kotori0919/PLA-PET-Recycling-Lab/graphify-out/GRAPH_REPORT.md

# Graph Report - PPR  (2026-10-19)

## Corpus Check
- 1292 files · ~3,835,179 words
- Verdict: corpus is large enough that graph structure adds value.
- Unclassified: 2214 file(s) not represented in the graph (top: .step 486, .dxf 275, .csv 217)

## Summary
- 9168 nodes · 17152 edges · 686 communities (466 shown, 220 thin omitted)
- Extraction: 96% EXTRACTED · 4% INFERRED · 0% AMBIGUOUS · INFERRED: 723 edges (avg confidence: 0.84)
- Token cost: 0 input · 0 output

## Graph Freshness
- Built from commit: `34ae29d7`
- Run `git rev-parse HEAD` and compare to check if the graph is stale.
- Run `graphify update .` after code changes (no API cost).

## Community Hubs (Navigation)
- source_sha256
- MachineSupervisor
- MachineSupervisor
- MachineSupervisor
- cad/freecad/compact/geometry.py
- 05_SOURCE/analysis/final_validation/run_calculix_v08.py
- cad/freecad/compact/manufacturing.py
- cad/freecad/compact/generate.py
- Production Requalification Gate
- 05_SOURCE/cad/freecad/compact/geometry.py
- before/cad/freecad/compact/geometry.py
- BoundaryTests
- Parallel Actuation Hardening v0.6.2
- ProcessController
- build_bom_release.py
- QualificationTests
- P1SemanticsTest
- v0.8 공차·끼워맞춤 검토 — PASS
- runtime_supervisor_harness.cpp
- MachineViewState
- 환경 변경 이력
- MachineViewState
- MachineViewState
- source_sha256
- before/cad/freecad/compact/manufacturing.py
- ResourceTests
- freecad
- source_payload
- v0.4 요구사항 완료 감사
- 05_SOURCE/cad/freecad/compact/manufacturing.py
- TraverseHomingController
- source_sha256
- source_sha256
- 교정
- Gate-1 CUT-01 coupon 시험 절차와 합격기준
- TraverseHomingController
- TraverseHomingController
- Communities (46 total, 1 thin omitted)
- Parent Codex visual review — compact-single-path-v0.3
- 현금비용 value engineering — coupled-digital-validation-v0.5
- 16 mm x 16 L/D screw/barrel 제조성 audit — RFQ 기준
- Tests
- assembly.py
- Arduino Mega 2560 controller wiring contract
- firmware/arduino_mega/src/machine_supervisor.cpp
- SizingTests
- 시스템 요구사항 — coupled-digital-validation-v0.5
- ActuationShadowSystem
- GgmInput
- Conditional Cash Target
- GgmInput
- GgmInput
- build_complete_release.py
- EvidenceTests
- Actuation Hardening Contract
- render_views.py
- source/arduino_mega/src/machine_supervisor.cpp
- summarize_results.py
- source/arduino_mega/src/calibration_record.h
- generate
- cad/freecad/compact/generate_fusion_validation.py
- TraverseController
- fusion_release_gate_v0621.py
- solve_sliding_gradients.py
- InputSnapshot
- 공학 계산 통합 보고 — coupled-digital-validation-v0.5
- Shredder geared-DC drive wiring — solid-manifold-openmodelica-v0.4
- ProcessController
- ShredderController
- InputSnapshot
- ProcessController
- ShredderController
- InputSnapshot
- run_v062.py
- ShredderController
- analyze_p2_records.py
- shelf_fea.py
- Coupon Ppr Tc01 First Layer
- v0621_mutation_tests.py
- v062_mutation_tests.py
- Gate1 Assembly
- Compact Exploded
- Fullsystemjam
- Tests
- cutter_shaft
- firmware/arduino_mega/src/calibration_record.h
- 저비용 물리 Gate
- Trace
- RadialSupportTests
- source_sha256
- 05_SOURCE/cad/freecad/compact/generate.py
- CalibrationRecord
- Cut 01 Cycloidal Hook Profile
- drive_ggm_v08/firmware/arduino_mega/src/machine_supervisor.cpp
- CalibrationRecord
- DriveCalibration
- CalibrationRecord
- QuantizedDrivePlant
- Compact FreeCAD source
- numpy
- 교환식 분쇄기 구동 인터페이스 — coupled-digital-validation-v0.5
- minimum_yield_floor
- integrated_objects
- 05_SOURCE/cad/freecad/compact/generate_fusion_validation.py
- Tests
- SelectionTests
- analyze_p4_records.py
- v0.5 가열계 RFQ 및 수령검사 계약
- TraverseController
- TraverseController
- build_mechanical_release.py
- analysis/final_validation/run_calculix_v08.py
- cad/freecad/compact/process_v0621.py
- FeedDeliveryConfig
- FeedDeliveryConfig
- 05_SOURCE/cad/freecad/compact/process_v0621.py
- Compact Full Assembly Front
- FeedDeliveryConfig
- pre_push.py
- Communities (19 total, 7 thin omitted)
- Tests
- build_print_release.py
- sys
- shadow_v0.6.2/README.md
- configureCalibrationRecord
- ProcessProfile
- ProcessProfile
- ProcessProfile
- 경제성  coupled-digital-validation-v05
- forming_chain_control_ko.md
- drive_acceptance_v08/package_review.py
- puller_spooler_traverse_control_ko.md
- purge_measurement_ko.md
- v0.6.2_parallel_work_contract.md
- EX-BAR-01 — ID16.20 x OD34 barrel
- Machine fabrication package — coupled-digital-validation-v0.5
- calculate.py
- artifacts/manifest.json
- datetime
- extruder_rfq_parts
- CalibrationReadiness
- CalibrationReadiness
- CoolingMonitorOutput
- CalibrationReadiness
- build_electrical_firmware_release.py
- test_p11_execution.py
- Dimension Sheet
- Dimension Sheet
- Dimension Sheet
- Dimension Sheet
- Dimension Sheet
- Dimension Sheet
- Dimension Sheet
- Dimension Sheet
- Dimension Sheet
- Dimension Sheet
- Dimension Sheet
- Dimension Sheet
- runtime_schedule.md
- SpoolerConfig
- make_fixture
- SpoolerConfig
- Extruder Die Exploded
- OpenModelica coupled digital validation v0.5
- shelf_strip_screen.py
- Graph Report - PPR  (2026-09-10)
- 동적 하중 연계 구조 검토
- Metal Extruder Load Path
- SpoolerConfig
- Build Manual Ko
- Design Report Ko
- Digital Release Report Ko
- CUT-01 — Cycloidal hook cutter disc
- CUT-02 — Cutter spacer
- CUT-03 — Bearing side plate
- CUT-04 — 5 mm aperture screen
- CUT-05 — 20 mm keyed cutter shaft
- CUT-06 — Phase gear axial spacer
- CUT-07 — DRV-01 universal donor motor plate
- CUT-08 — Dual 6004 bearing retainer
- Ex Scr 01 Drawing
- EX-CPN-BAR — Matched barrel process coupon
- EX-CPN-SCR — Three-pitch screw process coupon
- EX-DIE-01 — Connected 90 degree down-die body
- EX-DIE-02 — Seven-hole breaker plate
- EX-DIE-03 — Replaceable Ø3 die insert
- EX-DIE-04 — Sacrificial die relief retainer
- EX-DIE-05 — Annealed copper face gasket
- EX-SCR-01 — 16 mm x 16D single screw
- DRV-01 — Universal donor motor plate
- DRV-02 — Bolt-on cutter sprocket hub
- DRV-03 — M3 Z16 keyed phase gear lamination
- DRV-A42 — 42GP-775 reference adapter plate
- DRV-A60 — GMP60-60127 selected adapter plate
- DRV-F01A — Motor-side fuse inner hub
- DRV-F01B — Motor-side fuse sprocket carrier
- DRV-F01P — Replaceable waisted shear pin coupon
- CT-ENC-01 — Control-panel sheet enclosure
- DRV-GD-01 — Interlocked drive guard
- EX-SH-01 — Three-panel hot-zone shield
- EX-THR-01 — Extruder thrust plate
- FD-BIN-01 — Removable flake bin
- FD-HOP-01 — Sealed feed hopper
- FD-MET-01 — Metering feeder housing
- FD-MET-02 — Six-pocket metering rotor
- FD-MET-03 — Metering feeder shaft
- pin_record
- FM-AX-01 — Puller roller spindle
- FM-GA-01 — Guide roller fixed axle
- FM-GR-01 — Solid-strand guide roller
- FM-PL-01 — Puller side plate
- FM-RL-01 — Puller roller
- IN-HOP-01 — Refillable input hopper
- SP-AX-01 — Dancer pivot/roller axles
- SP-BP-01 — Spool 6001 bearing plate
- SP-DA-01 — Dancer arm
- SP-DS-01 — Dancer pivot support plate
- SP-MM-01 — Universal NEMA17-class spool motor plate
- SP-RL-01 — Dancer end roller
- SP-SH-01 — Spool spindle
- SP-TR-01 — Traverse rod end plate
- G1J-01 — Reusable jig base plate
- G1J-02 — 250 mm torque arm
- G1J-03 — Front/rear guard panel
- G1J-04 — Left guard panel
- G1J-05 — Right slotted guard panel
- G1J-06 — Torque-slot offset baffle
- G1J-07 — Metal guard upright
- G1J-08 — Removable screen rail
- G1J-09 — Universal guard-interlock bracket
- G1J-10 — CUT-03 plate foot angle
- G1J-11 — DRV-01 motor-plate foot angle
- G1J-12 — Top guard panel with chute opening
- G1J-P01 — Anti-reach coupon feed chute
- G1J-P02 — Removable chip collection tray
- G1J-P03 — Guard edge trim
- PPR-TC01 — fastener/insert/fit tolerance coupon
- Release slicer profile
- Plate 05 Ppr C05 First Layer
- Plate 06 Ppr C06 First Layer
- Plate 07 Ppr C07 First Layer
- Plate 08 Ppr C08 First Layer
- Plate 09 Ppr C09 First Layer
- Plate 10 Ppr C10 First Layer
- Plate 11 Ppr C11 First Layer
- Plate 12 Ppr C12 First Layer
- 출력물 총 재료 보고  실제 slicing
- TH-BH-01 — Custom barrel mica band heater
- TH-DIE-01 — Die cartridge heater
- TH-FUSE-01 — Independent one-shot thermal fuse envelope
- validate_physical_test.py
- properties
- finalizeOutput
- TH-TC-01 — Grounded K-type barrel/die/hopper probe
- Mega realtime core
- LoadTests
- SpoolerController::configure
- TraverseController::configure
- run_phase_load_v08.py
- run_engineering.py
- TachEstimator
- TachEstimator
- External Predry Unqualified
- Cooling Fault Scenarios
- Reverseclear
- TachEstimator
- audit_evidence
- inspection.py
- analysis/final_validation/run_solid_load_path_closure.py
- dancer_revision.py
- ScrewMotionMonitor
- configureCalibrationRecord
- 물리 검증·시제품 제작 착수용 검증 계획
- FeedDeliveryController
- configureCalibrationRecord
- PulseAdapter
- run_sensor_bore_local_candidate.py
- analysis/structural/run_load_checks.py
- PowerLoop
- Arduino Mega Runtime Schedule
- run_controller_replay.py
- properties
- HeaterController
- plate_fea.py
- power_loop_bridge.cpp
- validate
- generate_manufacturing.py
- tolerance_stack_final.py
- ScrewMotionOutput
- source_sha256
- DriveSpeedController
- FeedDeliveryController
- HeaterController
- DriveSpeedController
- FeedDeliveryController
- DriveSpeedController
- test_machine_supervisor.cpp
- test_tach_estimator.cpp
- analyze_p12_records.py
- make_p6_records
- FrameReleaseTest
- ExecutionToolsTest
- ScrewMotionMonitor
- crossrail_response
- analyze_p5_records.py
- analyze_p9_records.py
- fixture
- validate_p8_firmware_commissioning.py
- manifest_lib.py
- CoolingMonitorOutput
- drive_ggm_v08/firmware/arduino_mega/src/feed_delivery_control.cpp
- FeedDeliveryOutput
- HeaterAllocation
- PullerCalibration
- integrated_motion
- traverse_retention
- stdint
- source/arduino_mega/src/feed_delivery_control.cpp
- FeedDeliveryOutput
- HeaterAllocation
- PullerCalibration
- exact_head_evidence_v0621.py
- FeedDeliveryOutput
- HeaterAllocation
- PullerCalibration
- prepare_run.py
- build_p3_inspection_packet.py
- make_inputs
- PatchTests
- run_qualification_v08.py
- GaugeController
- hook_disc
- GaugeController
- StatePermissions
- ActuatorCommands
- promote_canonical.py
- Branch Current and Dual-Fan Tach
- finalizeOutput
- GaugeController
- StatePermissions
- source/arduino_mega/src/hardware_interfaces.h
- ActuatorCommands
- HeaterController
- SpoolerOutput
- process_v0621/manifest.json
- 05_SOURCE/release/finalize_engineering_closure_review.py
- firmware/arduino_mega/src/feed_delivery_control.cpp
- DiameterController
- StatePermissions
- firmware/arduino_mega/src/hardware_interfaces.h
- ActuatorCommands
- SpoolerOutput
- FusionImportTests
- validate_v0621_shadow.py
- 05_SOURCE/validation/test_load_path_closure.py
- test_material_run.py
- make_p12
- make_record
- TorqueTests
- fixture/manifest.json
- test_fixture_geometry.py
- finalizeOutput
- TachEstimatorConfig
- integrated_clearance
- Purge Completion Gate
- TachEstimatorConfig
- CoolingMonitorOutput
- TachEstimatorConfig
- properties
- analyze_p6_records.py
- analyze_p8_records.py
- make_fixture
- CompactLayoutTests
- MountBindingTest
- P4ExecutionTest
- analysis/final_validation/beam_torque_recovery.py
- 470 x 700 x 930 mm compact 배치의 canonical 승격
- v0.8 현재 closure 보고서
- v0.8 현재 closure 보고서
- v0.8 현재 closure 보고서
- S0 시작 전 최종 재검토 - 2026-09-12
- SupervisorOutput
- SupervisorOutput
- TemperatureReading
- SupervisorOutput
- TachEstimate
- drive_ggm_v08/manifest.json
- joined
- build_p5_inquiry_package.py
- PullerSpeedOutput
- TachEstimate
- execution_checkout_sha
- source_git_sha
- TachEstimate
- step_sha256
- BomReleaseScopeTest
- acknowledgeMaterialStep
- build_physical_evidence_package.py
- make_record
- slice_prints.py
- regional_stress_review.py
- Chiron 기반 최소 제작 기준 — 2026-09-09
- acknowledgeMaterialStep
- 실제 히터 제어기와 수치 열모델 연결
- FeedDeliveryInputs
- DriveCalibration
- one_solid
- drive_ggm_v08/firmware/arduino_mega/src/machine_supervisor.h
- dancer_retention
- FeedDeliveryInputs
- FeederMotionMonitor
- ShredderInputs
- DriveCalibration
- ScrewMotionOutput
- analyze_ggm_mount_compatibility.py
- analyze_s4_thermal_barrier_tape.py
- P3 GGM 구동계 벤치 검증 절차
- LaunchBindingTest
- make_release
- make_release
- make_release
- make_release
- EvidencePackageTest
- FirmwareController
- v0.8 공급자 문의 패키지 — 발송·회신 기록
- HS-R1-S2: 고온부 sliding 시험 기반
- 시험 목적과 판정 범위
- drive_ggm_v08/firmware/arduino_mega/src/tach_estimator.cpp
- HeaterOutput
- source/arduino_mega/src/tach_estimator.cpp
- TraverseOutput
- 05_SOURCE/cad/freecad/compact/export_validation_geometry_v08.py
- test_feed_delivery_control.cpp
- FeedDeliveryInputs
- HeaterOutput
- firmware/arduino_mega/src/tach_estimator.cpp
- prepareProduction
- mesh_levels
- finalize_v0621_handoff_lock.py
- analyze_p7_records.py
- analyze_p9_receipt.py
- PPR v0.8 물리 검증·제작 준비 기준
- make_release
- P5ExecutionTest
- make
- validate_p5_stage_release.py
- validate_p8_stage_release.py
- test_release.py
- beam_screen.py
- GGM 구동부 마감 검토
- GGM 구동부 제조도면·수령·교정 마감 r2
- run_feed_surrogate.py
- 모터 옵션 및 보유품 회신 검토 — 2026-09-09
- v0.5.1 구매처·제품 후보 고정 (구매 실행 전 단계)
- GaugeCalibration
- FeederMotionMonitor
- ShredderInputs
- GaugeReading
- GaugeReading
- validate_fusion_v0621_package.py
- check_axial_retainer_candidate.py
- 전방 뚜껑 서비스 공간 재검토
- orchestration_contract.py
- P3PacketBuilderTest
- validate_p10_stage_release.py
- validate_p11_stage_release.py
- validate_p12_stage_release.py
- validate_p2_stage_release.py
- validate_p3_stage_release.py
- argparse
- validate_p6_stage_release.py
- validate_p7_stage_release.py
- validate_p9_stage_release.py
- CompletePackageTest
- PPR 조건부 시퀀스 모터 선정 — 2026-09-09
- 실용적 MVP로 고온부 마감 방향 수정
- run_screening.py
- GMP60 기준 구동 인터페이스 근거 — v0.8
- Hot-zone 소재·가공 확인 요청서 — JLCCNC 부적합 회신 / 대체 공급자 HOLD
- T1–T4 프로브 구매 기준 — Tempco MTA1 맞춤품 / 승인도면 HOLD
- 실제 히터 제어 코드와 열모델 연동
- PR 정상화 확인과 고온부 방사방향 지지 검토
- PPR v0.8 직접 코드 수정 및 수치 재검증
- support_contacts
- exact_head_evidence.py
- compare_published.py
- finalize_engineering_binding.py
- validate_v062_shadow.py
- v0.5.1 가상 물리 폐쇄 완료 감사
- v0.6.1 safety-orchestration 완료 감사
- analyze_p3_records.py
- P5 screw/barrel 공정 coupon 실행안
- itertools
- pathlib
- 모터 선정 전 시퀀스 부하 산정
- PPR 실용적 고온부 마감 검토
- Z1 폭 / 지지 위치 변경의 분리 비교
- price_policy
- 추가 부품 확인과 가격 근거
- v0.6.1 조달 폐쇄 상태
- cutter_shaft
- TH-DIE-01 다이 카트리지 히터 선정 근거
- IF-020 extruder thrust stack 선정·검증 근거
- PPR 실용적 MVP 마감 우선순위 — 2026-09-09
- PPR v1.0.0-rc1 - 전체 설계 및 제작 인수인계
- TH-TC-01 맞춤 열전대 선정 근거
- run_binding_sha256
- 처음 목적에 맞춘 규모 재검토 / 2026-09-15
- 히터 입력과 전역 오류 래치 재검토
- rc1 이후 수정본의 디지털 검토와 사용 제한
- GGM 통합 형상 수정 및 R1/R2 검토
- 고온부 입력 결박 보완
- 고온부 sliding prototype 실행 종료 — 2026-09-09
- HS-R1-S2 냉간 실측 준비와 기록 보완
- HOLD 근거 조사 / 2026-09-09
- 재료 참고자료와 적용 한계
- firmware/manifest.json
- extruder_screw
- v0.8 고온부·하중 경로 직접 보완 — 2026-09-09
- build_ggm_drive_release.py
- acknowledgeMaterialStep
- configuration_control_v0.6.2.1.py
- geometry
- freecad_checks.py
- fusion_worker_handoff_v0621.py
- GGM 프레임 R1: 절단표와 실제 재고를 연결하는 절차
- P4 두-cutter coupon 물리 검증
- P9 빈 hot-zone 가열 검증
- TapeContractTest
- validate_thermal_cutoff_topology.py
- FabricationActivePartSetTest
- v062_actuation_contract.py
- v0.5.1 멀티모달 CAD 검토 기록
- package_r2.py
- qualify_hot_zone_digital_v08.py
- P0-H 공정 공급 virtual closure 보고서
- run_recirculation_surrogate.py
- P0-G shredder 재순환 virtual closure 보고서
- Chiron 기반 마감 판정
- generate_contract_artifacts.py
- IF-022 기준 feeder drive 계약
- v0.8 solver 검증 보고
- v0.6.2.1 Fusion deferred release 정책
- before/docs/final/release_notes_v1.0.0-rc1_ko.md
- v0.8 고온부·하중 경로 직접 보완 — 2026-09-09
- 열제어 연동 변경의 커밋·배포 사본 검사
- 원격 재연결 후 실제 실행 / 2026-09-14
- 트래버스 축방향 고정 보완 / 2026-09-14
- 지지판 후보의 3D 솔리드 검토 / 2026-09-15
- PPR v0.8 steering 검토 기록 — 2026-09-09
- 공급업체·시험기관 문의 초안 — 미발송
- test_hardware_adapter_e2e.cpp
- test_guard.cpp
- run_manifest.schema.json
- completed_utc
- generate_v0621_shadow.py
- v0.6.2.1 기술 blocker closure 보고서
- v0.6.2 완료 조건 감사
- controller_contract.py
- hardware_adapter_v0621.py
- graphify-execution-out/manifest.json
- MVP = 최종 제품: 최소 smoke 검증 운용 계약
- P1 실물 재고·수령검사 실행안
- P2 냉간 프레임·fit 검증
- P8 설치 후 motor dry-run
- SmokeContractTest
- test_fusion_policy_v0621.py
- Parent multimodal visual review — coupled-digital-validation-v0.5 (HISTORICAL ARCHIVE)
- v0.6.2.1 공정 CAD parent 시각 검토
- GGM 구동부 계속 작업의 독립 검토
- qualify_die_joint_v08.py
- cooling_degradation_v0.6.2.1.py
- build_manifest_v0621.py
- review_keepouts/manifest.json
- CI-FULL: CAD 회귀시험과 배포 펌웨어 재현
- PR 실패 알림의 원인과 push 전 검사
- drawings/manifest.json
- LC11 feeder attachment Fusion 패키지
- generate_plots.py
- build_release_metadata_v0621.py
- check_phase_path_25_evidence.py
- v0.6 구현·교차 solver 완료 감사
- configuration_control.py
- gate1_readiness.py
- P10/P11 PLA/PET low-feed physical validation
- P12 forming/spool full-path validation
- P1 의미 검사 R2 - 무전원 재고 기록
- P6 냉간 압출기 조립 검증
- P7 전기 안전·logic 검증
- validate_execution_registry.py
- validate
- validate
- Hot-zone 대체 공급자 1차 선별
- 댄서 축 제조·조립 정합화
- 재생성 및 검증
- Autodesk Fusion 교차 검증 중립 패키지
- generate_config.py
- case_id
- engineering_source_sha
- load_case_manifest_sha256
- model_manifest_sha256
- run_id
- solver_version
- started_utc
- step_file
- correlation_report_ko.md
- solver_assumptions.md
- fusion_delta_queue/README.md
- shadow_v0.6.2.1/README.md
- cooling_airflow_sensitivity.md
- cooling_degradation_v0.6.2.1_ko.md
- hopper_screw_feed_screening.md
- shredder_particle_screening.md
- refresh_revision_metadata.py
- v0.7_exploratory_index.md
- cross_solver_release_report_ko.md
- 61905_interface_basis_ko.md
- 625_6001_interface_basis_ko.md
- ci_release_audit_ko.md
- jlccnc_zip_readme_ko.md
- multimodal_review_ko.md
- release_approval_report_ko.md
- release_readiness_ko.md
- docs/final/v08_full_compliance_ko.md
- fusion_result_integration_ko.md
- hardware_adapter_validation_ko.md
- process_feed_validation_ko.md
- before/docs/final/v08_full_compliance_ko.md
- PLAIN_SHAFT_DRAWINGS_KO.md
- aggregate_check_ko.md
- s0-prestart-20260912/GRAPH_REPORT.md
- hot_slide_r1/AGENTS.md
- CUT-05R/drawing_notes.md
- CUT-09/drawing_notes.md
- CUT-10/drawing_notes.md
- DRV-03R/drawing_notes.md
- FD-CP-01/drawing_notes.md
- FD-DA-01/drawing_notes.md
- FD-GSK-01/drawing_notes.md
- FM-EB-01/drawing_notes.md
- FM-GC-01/drawing_notes.md
- SP-AW-08/drawing_notes.md
- SP-AX-02/drawing_notes.md
- SP-BR-01/drawing_notes.md
- SP-TG-01/drawing_notes.md
- configure
- calibration_guide_ko.md
- EEPROM_schema.md
- flashing_guide_ko.md
- pinmap.md
- runtime_state_machine_ko.md
- configure
- frame_v08/README.md
- print_settings_ko.md
- step/README.md
- fusion_validation/coordinate_system.md
- buckling.md
- event_simulation.md
- modal_frequencies.md
- nonlinear_static.md
- static_stress.md
- thermal.md
- thermal_stress.md
- results/README.md
- units_contract.md
- fusion_validation_v0621/coordinate_system.md
- compact_layout_v08/README_KO.md
- radial_support_v08/README_KO.md
- TH-BH-02/drawing_notes.md
- TH-TCR-01/drawing_notes.md
- configure
- fusion_worker/AGENTS.md
- fusion_execution.md
- fusion_worker/README.md
- pre-push
- render_v08_closeups.py
- results_v0.6.2.1/README.md
- templates/README.md
- 2026-08-30-implementation-crosssolver-v0.6.md
- arduino

## God Nodes (most connected - your core abstractions)
1. `MachineSupervisor` - 141 edges
2. `MachineSupervisor` - 140 edges
3. `MachineSupervisor` - 140 edges
4. `source_sha256` - 109 edges
5. `assembly_objects()` - 66 edges
6. `integrated_objects()` - 63 edges
7. `assembly_objects()` - 59 edges
8. `final_objects()` - 57 edges
9. `one_solid()` - 54 edges
10. `assembly_objects()` - 54 edges

## Surprising Connections (you probably didn't know these)
- `God Nodes (most connected - your core abstractions)` --references--> `integrated_objects()`  [INFERRED]
  validation/physical_v08/graphify-execution-out/GRAPH_REPORT.md → cad/freecad/drive_v08/assembly.py
- `God Nodes (most connected - your core abstractions)` --references--> `integrated_objects()`  [INFERRED]
  analysis/drive_acceptance_v08/graphify-drive-out/GRAPH_REPORT.md → cad/freecad/drive_v08/assembly.py
- `CoolingMonitor::update` --conceptually_related_to--> `Common Fault Containment Sequence`  [INFERRED]
  firmware/arduino_mega/src/cooling_monitor.cpp → docs/forming_chain_control_ko.md
- `MachineSupervisor::enterFormingRundown` --implements--> `Common Fault Containment Sequence`  [INFERRED]
  firmware/arduino_mega/src/machine_supervisor.cpp → docs/forming_chain_control_ko.md
- `ScrewMotionMonitor::update` --conceptually_related_to--> `Common Fault Containment Sequence`  [INFERRED]
  firmware/arduino_mega/src/screw_motion_monitor.cpp → docs/forming_chain_control_ko.md

## Import Cycles
- None detected.

## Hyperedges (group relationships)
- **Closed-Loop Actuation Feedback Evidence** — control_actuation_contract_v0_6_2_puller_cascade, control_actuation_contract_v0_6_2_actual_purge_revolutions, control_actuation_contract_v0_6_2_dancer_spooler, control_actuation_contract_v0_6_2_traverse_turn_sync, electronics_io_schedule_motion_feedback_signals [INFERRED 0.85]
- **Measurement-Backed Process Safety** — docs_purge_measurement_ko_measured_screw_revolutions, docs_purge_measurement_ko_purge_completion_gate, docs_cooling_feedback_ko_branch_current_and_dual_fan_tach, firmware_arduino_mega_src_screw_motion_monitor_update, firmware_arduino_mega_src_cooling_monitor_update, firmware_arduino_mega_src_machine_supervisor_confirmpurgecomplete [INFERRED 0.85]
- **Forming Fault Containment and Requalification Flow** — docs_forming_chain_control_ko_common_fault_containment_sequence, firmware_arduino_mega_src_machine_supervisor_enterformingrundown, firmware_arduino_mega_src_machine_supervisor_updaterequalification, firmware_arduino_mega_src_cooling_monitor_update, firmware_arduino_mega_src_screw_motion_monitor_update [INFERRED 0.95]
- **Fusion Release Hold Boundary** — changelog_frozen_fusion_input, docs_validation_report_ko_fusion_intake_pending, docs_validation_report_ko_main_merge_blocked, analysis_load_cases_shadow_v0_6_2_readme_zero_structural_load_delta, analysis_load_cases_shadow_v0_6_2_readme_fusion_input_freeze_rule, analysis_load_cases_shadow_v0_6_2_readme_hash_bound_correlation_review [INFERRED 0.95]
- **Hardware-Independent Safety Permission Chain** — electronics_controller_wiring_v0_6_hardwired_safety_chain, bom_bom_mandatory_safety_parts, electronics_io_schedule_safety_inputs, electronics_io_schedule_safe_outputs [INFERRED 0.95]
- **Turn-Coupled Winding Control Flow** — docs_puller_spooler_traverse_control_ko_cascaded_diameter_and_tach_control, docs_puller_spooler_traverse_control_ko_estimated_spool_radius, docs_puller_spooler_traverse_control_ko_turn_synchronized_traverse, firmware_arduino_mega_src_puller_speed_control_update, firmware_arduino_mega_src_spooler_control_update, firmware_arduino_mega_src_traverse_control_update [INFERRED 0.95]
- **v0.6.2 Digital Actuation Validation** — changelog_parallel_actuation_hardening_v0_6_2, changelog_closed_loop_actuation_feedback, changelog_runtime_and_mutation_validation, docs_validation_report_ko_actuation_hardening_complete, docs_validation_report_ko_actuation_feedback_gate [INFERRED 0.95]

## Communities (686 total, 220 thin omitted)

### Community 0 - "source_sha256"
Cohesion: 0.02
Nodes (109): source_sha256, analysis/frame_v08/audit_geometry.py, analysis/frame_v08/beam_screen.py, analysis/frame_v08/compare_published.py, cad/freecad/compact/geometry.py, cad/freecad/compact/shaft_retention.py, cad/freecad/compact/traverse_revision.py, cad/freecad/drive_v08/assembly.py (+101 more)

### Community 1 - "MachineSupervisor"
Cohesion: 0.02
Nodes (79): CoolingMonitor, DiameterController, FormingChainState, GaugeController, HeaterController, HeaterPowerAllocator, ProcessController, PullerSpeedController (+71 more)

### Community 2 - "MachineSupervisor"
Cohesion: 0.02
Nodes (79): CoolingMonitor, DiameterController, FormingChainState, GaugeController, HeaterController, HeaterPowerAllocator, ProcessController, PullerSpeedController (+71 more)

### Community 3 - "MachineSupervisor"
Cohesion: 0.02
Nodes (79): CoolingMonitor, DiameterController, FormingChainState, GaugeController, HeaterController, HeaterPowerAllocator, ProcessController, PullerSpeedController (+71 more)

### Community 4 - "cad/freecad/compact/geometry.py"
Cohesion: 0.07
Nodes (69): assembly_objects(), placed_cutter_plate(), cylindrical_hopper(), dancer_arm_shape(), dancer_support_plate_shape(), die_cartridge_heater_shape(), drive_guard_shape(), feed_hopper_gasket_shape() (+61 more)

### Community 5 - "05_SOURCE/analysis/final_validation/run_calculix_v08.py"
Cohesion: 0.05
Nodes (63): add_measured_root_torque(), expanded_root_torque(), Path, Measured root torque for the existing straight X-axis RECT B31 surrogate. The…, cross_matrix(), Work-conjugate weighted rigid-section fit and statically exact surface…, resultant_loads(), rigid_fit_coefficients() (+55 more)

### Community 6 - "cad/freecad/compact/manufacturing.py"
Cohesion: 0.08
Nodes (51): bearing_retainer_plate(), bearing_side_plate(), chain_sprocket_shape(), motor_adapter_42gp775_shape(), motor_adapter_gmp60_shape(), motor_mount_plate(), Manufacturable #35 sprocket LOD with explicit teeth and shaft bore., DRV-A42 plate for the requested 42GP/GMP42 family reference. (+43 more)

### Community 7 - "cad/freecad/compact/generate.py"
Cohesion: 0.05
Nodes (78): Export each closed guard half separately; avoid machining an assembly as one…, export(), main(), Path, Shape, v0.8 해석용 형상을 controlling FreeCAD Python에서 직접 내보낸다., sha256(), dirs() (+70 more)

### Community 8 - "Production Requalification Gate"
Cohesion: 0.15
Nodes (17): Production Requalification Gate, Common Fault Containment Sequence, Forming-chain Common Fault and Requalification, Cascaded Diameter and Tach Control, CRC Drive Calibration, Estimated Spool Radius, Puller–Spooler–Traverse Control, Turn-Synchronized Traverse (+9 more)

### Community 9 - "05_SOURCE/cad/freecad/compact/geometry.py"
Cohesion: 0.07
Nodes (69): assembly_objects(), chain_sprocket_shape(), cylindrical_hopper(), dancer_arm_shape(), dancer_support_plate_shape(), die_cartridge_heater_shape(), drive_guard_shape(), feed_hopper_gasket_shape() (+61 more)

### Community 10 - "before/cad/freecad/compact/geometry.py"
Cohesion: 0.09
Nodes (44): assembly_objects(), box(), cyl(), cylindrical_hopper(), dancer_support_plate_shape(), drive_guard_shape(), feed_hopper_gasket_shape(), feeder_agitator_shaft_shape() (+36 more)

### Community 12 - "Parallel Actuation Hardening v0.6.2"
Cohesion: 0.10
Nodes (25): Digital Simulation Only, Fusion Input Freeze Rule, Hash-Bound Correlation Review, Shadow Envelope Comparison, v0.6.2 Shadow Load Namespace, Zero Structural Load Delta, Closed-Loop Actuation Feedback, Conditional Budget v0.6.2 (+17 more)

### Community 13 - "ProcessController"
Cohesion: 0.05
Nodes (50): MachineState, MaterialProfile, MaterialSession, SafetyInputs, guardsOk(), MachineState, MaterialProfile, MaterialSession (+42 more)

### Community 14 - "build_bom_release.py"
Cohesion: 0.08
Nodes (47): active_reference_rows(), assembly_step(), assembly_step_number(), auxiliary(), category(), critical(), drawing(), enrich_final_manufacturing() (+39 more)

### Community 15 - "QualificationTests"
Cohesion: 0.06
Nodes (28): bolt_screen(), drag_budget(), finite(), main(), pressure_force(), Read-only engineering evidence calculations. No equipment control., sha(), artifact() (+20 more)

### Community 17 - "v0.8 공차·끼워맞춤 검토 — PASS"
Cohesion: 0.04
Nodes (49): IF-001 — PASS, IF-002 — PASS, IF-003 — PASS, IF-004 — PASS, IF-005 — PASS, IF-006 — PASS, IF-007 — PASS, IF-008 — PASS (+41 more)

### Community 18 - "runtime_supervisor_harness.cpp"
Cohesion: 0.15
Nodes (49): cstdint, anyHeater(), assertOutputInvariant(), boundedSequences(), calibrationReadinessPhaseGates(), coldBootAndCalibration(), completeCoolingStartup(), configure() (+41 more)

### Community 19 - "MachineViewState"
Cohesion: 0.04
Nodes (48): CoolingMonitorOutput, CoolingStartupRequest, HeaterAllocation, MachineState, MaterialSession, PullerSpeedOutput, ScrewMotionOutput, SpoolerOutput (+40 more)

### Community 20 - "환경 변경 이력"
Cohesion: 0.05
Nodes (37): Filament Recycler Agent Rules, Git과 산출물, 소유권과 언어, 로컬 subagent, 1. 무엇부터 열어야 하는가, 2. 설계·문서의 우선순위, 3. 실제 제작 경로, 4. 기록·수정·재시험 (+29 more)

### Community 21 - "MachineViewState"
Cohesion: 0.04
Nodes (48): CoolingMonitorOutput, CoolingStartupRequest, HeaterAllocation, MachineState, MaterialSession, PullerSpeedOutput, ScrewMotionOutput, SpoolerOutput (+40 more)

### Community 22 - "MachineViewState"
Cohesion: 0.04
Nodes (48): CoolingMonitorOutput, CoolingStartupRequest, HeaterAllocation, MachineState, MaterialSession, PullerSpeedOutput, ScrewMotionOutput, SpoolerOutput (+40 more)

### Community 23 - "source_sha256"
Cohesion: 0.04
Nodes (46): edges, method, nodes, scope, source_sha256, analysis/drive_acceptance_v08/check_geometry.py, analysis/drive_acceptance_v08/check_process_limits.py, analysis/drive_acceptance_v08/CLOSEOUT_KO.md (+38 more)

### Community 24 - "before/cad/freecad/compact/manufacturing.py"
Cohesion: 0.09
Nodes (40): chain_sprocket_shape(), motor_adapter_gmp60_shape(), DRV-A60 plate for the selected GMP60-60127 reference motor., Manufacturable #35 sprocket LOD with explicit teeth and shaft bore., screen_plate(), bolt_on_sprocket_hub(), _flat_panel(), gate1_assembly() (+32 more)

### Community 25 - "ResourceTests"
Cohesion: 0.09
Nodes (16): build(), main(), User-asset and fabrication allocation; not donor performance qualification., read_csv(), route(), sha(), target_material(), write_csv() (+8 more)

### Community 26 - "freecad"
Cohesion: 0.03
Nodes (73): main(), Read the exported assembly and independently inspect functional bearing lands., sha(), Check actual R2 bearing relief and cover mounting in the exported CAD., Extract machining coordinates from the exported, hash-bound assembly., Check recorded dependencies through intermediate JSON evidence., verify_sources(), cad_freecad_compact (+65 more)

### Community 27 - "source_payload"
Cohesion: 0.05
Nodes (43): source_payload, arduino_mega.ino, src/board_config.h, src/calibration_record.h, src/cooling_monitor.cpp, src/cooling_monitor.h, src/drive_speed_control.cpp, src/drive_speed_control.h (+35 more)

### Community 28 - "v0.4 요구사항 완료 감사"
Cohesion: 0.14
Nodes (15): 원문 목표 항목별 completion audit, Cutter구동Gate-1, v0.4 요구사항 완료 감사, Extrusion열forming, 디지털 제작 기준선, Solid CAD와 출력 패키지, v04 요구사항 완료 감사, v0.5 요구사항 완료 감사 (+7 more)

### Community 29 - "05_SOURCE/cad/freecad/compact/manufacturing.py"
Cohesion: 0.09
Nodes (40): motor_adapter_42gp775_shape(), DRV-A42 plate for the requested 42GP/GMP42 family reference., screen_plate(), bolt_on_sprocket_hub(), _flat_panel(), gate1_assembly(), gate1_base_plate(), gate1_chip_tray() (+32 more)

### Community 30 - "TraverseHomingController"
Cohesion: 0.07
Nodes (36): TraverseHomingConfig, TraverseHomingFault, TraverseHomingOutput, TraverseHomingFault, TraverseHomingState, TraverseHomingConfig, backoff_mm, home_timeout_ms (+28 more)

### Community 31 - "source_sha256"
Cohesion: 0.05
Nodes (42): source_sha256, firmware/arduino_mega/arduino_mega.ino, firmware/arduino_mega/src/board_config.h, firmware/arduino_mega/src/calibration_record.h, firmware/arduino_mega/src/cooling_monitor.cpp, firmware/arduino_mega/src/cooling_monitor.h, firmware/arduino_mega/src/drive_speed_control.cpp, firmware/arduino_mega/src/drive_speed_control.h (+34 more)

### Community 32 - "source_sha256"
Cohesion: 0.05
Nodes (43): source_sha256, cad/freecad/compact/check_shaft_section_v08.py, cad/freecad/compact/dancer_revision.py, cad/freecad/compact/export_validation_geometry_v08.py, cad/freecad/compact/generate_fusion_validation.py, cad/freecad/compact/generate.py, cad/freecad/compact/geometry.py, cad/freecad/compact/manufacturing.py (+35 more)

### Community 33 - "교정"
Cohesion: 0.28
Nodes (13): Compact v03 surface-proof 동결, 연구 설계 동결 인덱스, Solid-manifold OpenModelica v04 동결, Cutter load, 교정, Pullerspooler, XY diameter gauge, CERN-OHL-P-20 (+5 more)

### Community 34 - "Gate-1 CUT-01 coupon 시험 절차와 합격기준"
Cohesion: 0.28
Nodes (13): Gate-1 cutter coupon jig 조립도, 조립 순서, Gate1 Assembly Ko, Gate-1 release record — 물리시험 후 작성, A Lockout와 dry mechanical, B Quasi-static 절단토크, C Motorcurrent와 jam recovery, D Chip-size (+5 more)

### Community 35 - "TraverseHomingController"
Cohesion: 0.07
Nodes (36): TraverseHomingConfig, TraverseHomingFault, TraverseHomingOutput, TraverseHomingFault, TraverseHomingState, TraverseHomingConfig, backoff_mm, home_timeout_ms (+28 more)

### Community 36 - "TraverseHomingController"
Cohesion: 0.07
Nodes (36): TraverseHomingConfig, TraverseHomingFault, TraverseHomingOutput, TraverseHomingFault, TraverseHomingState, TraverseHomingConfig, backoff_mm, home_timeout_ms (+28 more)

### Community 37 - "Communities (46 total, 1 thin omitted)"
Cohesion: 0.05
Nodes (40): Communities (46 total, 1 thin omitted), Community 0 - "Community 0", Community 10 - "Community 10", Community 11 - "Community 11", Community 12 - "Community 12", Community 13 - "Community 13", Community 14 - "Community 14", Community 15 - "Community 15" (+32 more)

### Community 38 - "Parent Codex visual review — compact-single-path-v0.3"
Cohesion: 0.19
Nodes (13): After 근거, Before 기준, Parent Codex visual review — compact-single-path-v0.3, Parent Codex visual review  compact-single-path-v03, VE / Gate-1 / extruder RFQ 시각검토 — compact-single-path-v0.3, 검토 이미지, VE  Gate-1  extruder RFQ 시각검토  compact-single-path-v03, 남은 물리시각 blocker (+5 more)

### Community 39 - "현금비용 value engineering — coupled-digital-validation-v0.5"
Cohesion: 0.20
Nodes (12): 분쇄기 기준모터 trade study — v0.5, 분쇄기 기준모터 trade study  v05, Budget hierarchy, 현금비용 value engineering — solid-manifold-openmodelica-v0.4, 변경 근거, Release lock, 현금비용 value engineering  solid-manifold-openmodelica-v04, 현금비용 value engineering — coupled-digital-validation-v0.5 (+4 more)

### Community 40 - "16 mm x 16 L/D screw/barrel 제조성 audit — RFQ 기준"
Cohesion: 0.32
Nodes (12): Ex Bar 01 Drawing, Ex Cpn Drawing, Ex Die Drawing, Controlling geometry, DFM decision, 16 mm x 16 L/D screw/barrel 제조성 audit — RFQ 기준, EX-BAR-01 barrel, EX-DIE connected open-die assembly (+4 more)

### Community 41 - "Tests"
Cohesion: 0.12
Nodes (4): current_records(), meta(), receipts(), Tests

### Community 42 - "assembly.py"
Cohesion: 0.11
Nodes (29): box(), add(), Motor integration: lengthwise direct extrusion and supported shredder shaft., ring(), apply_compact_layout(), _by_name(), _move(), Canonical compact placement for the v0.8 integrated machine. (+21 more)

### Community 43 - "Arduino Mega 2560 controller wiring contract"
Cohesion: 0.15
Nodes (13): Mandatory Safety Parts, Actuator Feedback Topology, Arduino Mega 2560 controller wiring contract, Mega 2560 Controller Wiring Contract, Cooling Feedback Commissioning Hold, Fan-First Start Proof, Hardwired Safety Chain, Inputs and commissioning (+5 more)

### Community 44 - "firmware/arduino_mega/src/machine_supervisor.cpp"
Cohesion: 0.17
Nodes (33): coolingSnapshotHealthy(), GaugeReading, InputSnapshot, MaterialProfile, gaugeWithinProductionTolerance(), armExtrusion, buildCommands, canClearFaults (+25 more)

### Community 45 - "SizingTests"
Cohesion: 0.11
Nodes (10): independent(), main(), mean(), run_case(), scenarios(), sha(), SizingTests, main() (+2 more)

### Community 46 - "시스템 요구사항 — coupled-digital-validation-v0.5"
Cohesion: 0.20
Nodes (11): Claim발주 경계, 아키텍처 계약  coupled-digital-validation-v05, 아키텍처 계약 — coupled-digital-validation-v0.5, 잠긴 결정, 책임·검증 matrix — coupled-digital-validation-v0.5, 책임검증 matrix  coupled-digital-validation-v05, 기능 baseline, 시스템 요구사항  coupled-digital-validation-v05 (+3 more)

### Community 47 - "ActuationShadowSystem"
Cohesion: 0.18
Nodes (11): Forming Requalification Scenarios, Heater Allocator Scenarios, Puller Fault Scenarios, Screw and Purge Scenarios, Spool and Traverse Scenarios, V062ShadowScenarios, ActuationShadowSystem, Forming Fault Cascade (+3 more)

### Community 48 - "GgmInput"
Cohesion: 0.06
Nodes (30): GgmDriveGuard, direction_, latched_, motion_axis_, motion_started_ms_, tach_seen_, wait_start_ms_, waiting_ (+22 more)

### Community 49 - "Conditional Cash Target"
Cohesion: 0.20
Nodes (10): Absolute Cash Cap With Reserve, Blocked Procurement Allowances, Conditional Cash Target, Conditional Planning Budget, Optional Empirical Validation Cost, Verified Procurement Not Established, External State Holds, Conditional Cash Target Assumption (+2 more)

### Community 50 - "GgmInput"
Cohesion: 0.06
Nodes (30): GgmDriveGuard, direction_, latched_, motion_axis_, motion_started_ms_, tach_seen_, wait_start_ms_, waiting_ (+22 more)

### Community 51 - "GgmInput"
Cohesion: 0.06
Nodes (30): GgmDriveGuard, direction_, latched_, motion_axis_, motion_started_ms_, tach_seen_, wait_start_ms_, waiting_ (+22 more)

### Community 52 - "build_complete_release.py"
Cohesion: 0.06
Nodes (61): Communities (12 total, 3 thin omitted), Community 0 - "Release 0", Community 1 - "Release 1", Community 2 - "Release 2", Community 3 - "Release 3", Community Hubs (Navigation), Corpus Check, God Nodes (most connected - your core abstractions) (+53 more)

### Community 53 - "EvidenceTests"
Cohesion: 0.08
Nodes (31): audit_evidence(), check_edge(), issue(), path_for(), read(), scan(), visit(), evidence_current() (+23 more)

### Community 54 - "Actuation Hardening Contract"
Cohesion: 0.19
Nodes (13): Actuation Tach Package, Cooling Feedback Assembly, Heater and Thermal Protection System, Actual Measured Purge Revolutions, Actuation Hardening Contract, Cooling Monitor Topology, Dancer PI Spooler, Global Heater Power Allocator (+5 more)

### Community 55 - "render_views.py"
Cohesion: 0.13
Nodes (26): box(), cyl(), print_parts(), Non-manufacturing motion/service volumes, quarantined from exports., review_keepout_objects(), gate1_render_items(), gui_render(), main() (+18 more)

### Community 56 - "source/arduino_mega/src/machine_supervisor.cpp"
Cohesion: 0.17
Nodes (33): coolingSnapshotHealthy(), GaugeReading, InputSnapshot, MaterialProfile, gaugeWithinProductionTolerance(), armExtrusion, buildCommands, canClearFaults (+25 more)

### Community 57 - "summarize_results.py"
Cohesion: 0.15
Nodes (29): main(), boolean_duration(), evaluate(), evaluate_forming(), evaluate_full(), evaluate_orchestration_supervisor(), evaluate_power(), evaluate_purge() (+21 more)

### Community 58 - "source/arduino_mega/src/calibration_record.h"
Cohesion: 0.15
Nodes (26): calibrationBytesCrc(), calibrationDomainReady(), calibrationReadinessMask(), calibrationRecordCrc(), calibrationRecordValid(), calibrationUnitsForId(), CalibrationValueRecord, crc (+18 more)

### Community 59 - "generate"
Cohesion: 0.11
Nodes (32): main(), Rebuild this experiment's local graph with AST and reviewed document links., main(), Rebuild this experiment's local graph with AST and reviewed document links., main(), Rebuild this experiment's local graph with AST and reviewed document links., main(), Rebuild this experiment's local graph with AST and reviewed document links. (+24 more)

### Community 60 - "cad/freecad/compact/generate_fusion_validation.py"
Cohesion: 0.11
Nodes (34): compound(), export_geometry(), load_cases(), main(), Path, Shape, Generate the Fusion-neutral v0.6.1 handoff from controlling FreeCAD sources., sha256() (+26 more)

### Community 61 - "TraverseController"
Cohesion: 0.07
Nodes (30): TraverseConfig, TraverseOutput, TraverseConfig, missed_limit_timeout_ms, steps_per_mm, usable_width_mm, winding_pitch_mm, TraverseController (+22 more)

### Community 62 - "fusion_release_gate_v0621.py"
Cohesion: 0.17
Nodes (20): expected_unit(), import_results(), load_contract(), main(), Path, 검증된 Fusion CSV를 frozen v0.6.1 package에 결박해 수신한다. 외부 solver 값은 이 도구가 생성하지 않는다.…, sha256(), validate_rows() (+12 more)

### Community 63 - "solve_sliding_gradients.py"
Cohesion: 0.14
Nodes (24): cross_matrix(), Work-conjugate weighted rigid-section fit and statically exact surface…, resultant_loads(), rigid_fit_coefficients(), Three radial slots: constrain tangent/axial means, leave radial motion free., supports(), mesh_step(), Quadratic tetrahedral mesh adapter for the isolated flexure prototype. (+16 more)

### Community 64 - "InputSnapshot"
Cohesion: 0.06
Nodes (33): SafetyInputs, TemperatureReading, InputSnapshot, cooling_feedback_valid, dancer_angle_rad, fan1_rpm, fan1_tach_valid, fan2_rpm (+25 more)

### Community 65 - "공학 계산 통합 보고 — coupled-digital-validation-v0.5"
Cohesion: 0.43
Nodes (7): 공학 계산 통합 보고  coupled-digital-validation-v05, 공학 계산 통합 보고 — coupled-digital-validation-v0.5, 16 mm × 16 L/D screw — RPM/처리량 sensitivity, Flight-tip radial-clearance sensitivity, Cycloidal-derived cutter와 interchangeable drive, 열·전력·forming screening, 열전력forming screening

### Community 66 - "Shredder geared-DC drive wiring — solid-manifold-openmodelica-v0.4"
Cohesion: 0.29
Nodes (7): 24 V safety/power topology, 600 W PSU arbiter, 기준 actuator, 입고검사와 calibration, Shredder geared-DC drive wiring — solid-manifold-openmodelica-v0.4, Hardwired power path, Profile과 fault

### Community 67 - "ProcessController"
Cohesion: 0.05
Nodes (50): MachineState, MaterialProfile, MaterialSession, SafetyInputs, guardsOk(), MachineState, MaterialProfile, MaterialSession (+42 more)

### Community 68 - "ShredderController"
Cohesion: 0.07
Nodes (37): DriveCalibration, ProcessProfile, ShredderInputs, ShredderOutput, DriveCalibration, DriveSpeedController, ProcessProfile, ShredderCommand (+29 more)

### Community 69 - "InputSnapshot"
Cohesion: 0.06
Nodes (33): SafetyInputs, TemperatureReading, InputSnapshot, cooling_feedback_valid, dancer_angle_rad, fan1_rpm, fan1_tach_valid, fan2_rpm (+25 more)

### Community 70 - "ProcessController"
Cohesion: 0.05
Nodes (50): MachineState, MaterialProfile, MaterialSession, SafetyInputs, guardsOk(), MachineState, MaterialProfile, MaterialSession (+42 more)

### Community 71 - "ShredderController"
Cohesion: 0.07
Nodes (37): DriveCalibration, ProcessProfile, ShredderInputs, ShredderOutput, DriveCalibration, DriveSpeedController, ProcessProfile, ShredderCommand (+29 more)

### Community 72 - "InputSnapshot"
Cohesion: 0.06
Nodes (33): SafetyInputs, TemperatureReading, InputSnapshot, cooling_feedback_valid, dancer_angle_rad, fan1_rpm, fan1_tach_valid, fan2_rpm (+25 more)

### Community 73 - "run_v062.py"
Cohesion: 0.33
Nodes (10): shlex, CI-FULL Gate, file_hash(), freecad(), main(), path_hashes(), Path, Fusion frozen package를 재생성하지 않는 v0.6.2 exact-worktree gates. (+2 more)

### Community 74 - "ShredderController"
Cohesion: 0.07
Nodes (37): DriveCalibration, ProcessProfile, ShredderInputs, ShredderOutput, DriveCalibration, DriveSpeedController, ProcessProfile, ShredderCommand (+29 more)

### Community 75 - "analyze_p2_records.py"
Cohesion: 0.07
Nodes (57): decimal, main(), require(), evaluate(), expected_inventory(), load_inspection(), main(), Path (+49 more)

### Community 76 - "shelf_fea.py"
Cohesion: 0.20
Nodes (12): exterior_faces(), mesh_step(), Quadratic tetrahedral shelf mesh; surface traction uses consistent weights., read_gmsh_inp(), deck(), main(), Local shelf stiffness screen for relocation; bolt/contact approval is separate., printed_reactions() (+4 more)

### Community 77 - "Coupon Ppr Tc01 First Layer"
Cohesion: 1.00
Nodes (6): Coupon Ppr Tc01 First Layer, Plate 01 Ppr C01 First Layer, Plate 02 Ppr C02 First Layer, Plate 03 Ppr C03 First Layer, Plate 04 Ppr C04 First Layer, Slicing preview package

### Community 78 - "v0621_mutation_tests.py"
Cohesion: 0.18
Nodes (33): typing, baseline_cpp(), budget_mutation(), compile_and_run(), cpp_mutation(), digest(), edit_adapter_bypass(), edit_fixed_window() (+25 more)

### Community 79 - "v062_mutation_tests.py"
Cohesion: 0.21
Nodes (11): No Timer Conflicts, Runtime Resource Constraints, Mega Timer and Pin Budget, CI-LIGHT Gate, checks(), main(), Production Mutation Rejection Suite, 핵심 v0.6.2 회귀가 production source mutation을 실제로 거부하는지 증명한다. (+3 more)

### Community 80 - "Gate1 Assembly"
Cohesion: 1.00
Nodes (6): Gate1 Assembly, Gate1 Exploded, Gate1 Powered Assembly, Gate1 Powered Exploded, Gate1 Powered Guard Removed, Gate1 Rotor Detail

### Community 81 - "Compact Exploded"
Cohesion: 1.00
Nodes (6): Compact Exploded, Compact Section, Forming Spool Motion, Print Orientation, Shredder Fastener Tool Access, Support Contact

### Community 82 - "Fullsystemjam"
Cohesion: 1.00
Nodes (6): Fullsystemjam, Fullsystempla, Gaugedropout, Inputfuseoperation, Jamreverseretry, Mechanicalfusetrip

### Community 83 - "Tests"
Cohesion: 0.12
Nodes (8): envelope(), main(), operating_point(), positive(), Check published rated operating points; not physical motor acceptance., Tests, apply_reply(), main()

### Community 84 - "cutter_shaft"
Cohesion: 0.08
Nodes (29): bearing_retainer_plate(), box(), cutter_shaft(), _cycloidal_ease(), cycloidal_hook_profile_points(), cyl(), hook_disc(), motor_mount_plate() (+21 more)

### Community 85 - "firmware/arduino_mega/src/calibration_record.h"
Cohesion: 0.16
Nodes (28): calibrationBytesCrc(), calibrationDomainReady(), calibrationReadinessMask(), calibrationRecordCrc(), calibrationRecordValid(), calibrationUnitsForId(), CalibrationValueRecord, crc (+20 more)

### Community 86 - "저비용 물리 Gate"
Cohesion: 0.33
Nodes (6): 저비용 물리 Gate, Gate 1 Cutter coupon, Gate 2 Flakefeed coupon, Gate 3 Extruder coldmechanical proof, Gate 4 Hot extrusion, Gate 5 Diameterspool

### Community 87 - "Trace"
Cohesion: 0.15
Nodes (21): JLCCNC SCM440 스크루·배럴 능력 문의 회신 판정, 결론과 다음 gate, 공급자 답변의 설계 판정, allHazardsOff(), calibrationAndTraverseScenarios(), ActuatorCommands, ofstream, TachEstimate (+13 more)

### Community 88 - "RadialSupportTests"
Cohesion: 0.16
Nodes (12): axis_at(), capture_lift(), concave_hertz(), finite(), Explicit free-body/contact screens; no physical or full-machine approval., reactions(), seated_thermal_shift(), main() (+4 more)

### Community 89 - "source_sha256"
Cohesion: 0.07
Nodes (27): CUT-09, CUT-10, edges, incremental_note, nodes, reviewed_bom_followup, assembly_installation, retired_alias (+19 more)

### Community 90 - "05_SOURCE/cad/freecad/compact/generate.py"
Cohesion: 0.16
Nodes (24): dirs(), export_assembly(), export_metal_parts(), export_plates(), export_print_part(), export_review_keepouts(), export_tolerance_coupon(), feature() (+16 more)

### Community 91 - "CalibrationRecord"
Cohesion: 0.06
Nodes (52): calibrationBytesCrc(), calibrationDomainReady(), calibrationReadinessMask(), CalibrationRecord, cooling_amps_per_count, cooling_zero_adc, crc, current_amps_per_count (+44 more)

### Community 92 - "Cut 01 Cycloidal Hook Profile"
Cohesion: 1.00
Nodes (5): Cut 01 Cycloidal Hook Profile, Interchangeable Drive Interface, Ppr C02 Individual, Shared Shredder Module, Shredder Drive Guard Removed

### Community 93 - "drive_ggm_v08/firmware/arduino_mega/src/machine_supervisor.cpp"
Cohesion: 0.17
Nodes (33): coolingSnapshotHealthy(), GaugeReading, InputSnapshot, MaterialProfile, gaugeWithinProductionTolerance(), armExtrusion, buildCommands, canClearFaults (+25 more)

### Community 94 - "CalibrationRecord"
Cohesion: 0.07
Nodes (27): CalibrationRecord, cooling_amps_per_count, cooling_zero_adc, crc, current_amps_per_count, current_zero_adc, dancer_radians_per_count, drive (+19 more)

### Community 95 - "DriveCalibration"
Cohesion: 0.20
Nodes (10): DriveCalibration, drivetrain_efficiency, max_continuous_current_a, max_peak_current_a, motor_to_cutter_ratio, motor_torque_per_amp_nm, no_load_current_a, no_load_cutter_rpm (+2 more)

### Community 96 - "CalibrationRecord"
Cohesion: 0.07
Nodes (27): CalibrationRecord, cooling_amps_per_count, cooling_zero_adc, crc, current_amps_per_count, current_zero_adc, dancer_radians_per_count, drive (+19 more)

### Community 97 - "QuantizedDrivePlant"
Cohesion: 0.13
Nodes (21): ofstream, TachEstimate, TachEstimator, TachEstimatorConfig, main(), QuantizedDrivePlant, config_, dead_zone_ (+13 more)

### Community 98 - "Compact FreeCAD source"
Cohesion: 1.00
Nodes (4): Compact FreeCAD source, ADR-001: vertical forming compact cabinet, ADR-002: 공용 cutter 최소화 trade study, ADR-003: 외부 pre-dry, 16 mm screw, 2축 shadow gauge

### Community 99 - "numpy"
Cohesion: 0.10
Nodes (16): beam_screen(), main(), Geometry-bound hot-zone delta screens; not physical qualification., read_geometry(), configurations(), Four-way factorial comparison with independent temporal/spatial refinement., run(), metric_vector() (+8 more)

### Community 100 - "교환식 분쇄기 구동 인터페이스 — coupled-digital-validation-v0.5"
Cohesion: 0.50
Nodes (4): 교환식 분쇄기 구동 인터페이스  coupled-digital-validation-v05, 교환식 분쇄기 구동 인터페이스 — coupled-digital-validation-v0.5, 기계 interface, 선정 기준과 기준모터

### Community 101 - "minimum_yield_floor"
Cohesion: 0.23
Nodes (4): main(), sha(), minimum_yield_floor(), FloorTests

### Community 102 - "integrated_objects"
Cohesion: 0.03
Nodes (106): analysis_compact_layout_v08, candidate(), Move the upper module but keep frame rails and four shelf feet in place., validate(), main(), Export the two unchanged-member frames and real shelf load stations., snapshot(), frame_rows() (+98 more)

### Community 103 - "05_SOURCE/cad/freecad/compact/generate_fusion_validation.py"
Cohesion: 0.16
Nodes (24): compound(), export_geometry(), load_cases(), main(), Path, Shape, Generate the Fusion-neutral v0.6.1 handoff from controlling FreeCAD sources., sha256() (+16 more)

### Community 105 - "SelectionTests"
Cohesion: 0.10
Nodes (5): conservative_catalog_nm(), main(), output(), sha(), SelectionTests

### Community 106 - "analyze_p4_records.py"
Cohesion: 0.29
Nodes (20): boolean(), build_result(), canonical(), check_p3(), chip(), evaluate_records(), evidence(), interval_pass() (+12 more)

### Community 107 - "v0.5 가열계 RFQ 및 수령검사 계약"
Cohesion: 0.67
Nodes (3): v0.5 가열계 RFQ 및 수령검사 계약, 고정 아키텍처, v05 가열계 RFQ 및 수령검사 계약

### Community 108 - "TraverseController"
Cohesion: 0.07
Nodes (30): TraverseConfig, TraverseOutput, TraverseConfig, missed_limit_timeout_ms, steps_per_mm, usable_width_mm, winding_pitch_mm, TraverseController (+22 more)

### Community 109 - "TraverseController"
Cohesion: 0.10
Nodes (21): TraverseConfig, TraverseOutput, TraverseConfig, missed_limit_timeout_ms, steps_per_mm, usable_width_mm, winding_pitch_mm, TraverseController (+13 more)

### Community 110 - "build_mechanical_release.py"
Cohesion: 0.06
Nodes (47): dimh(), dimv(), line(), main(), matrix_for(), projection(), Produce dimensioned vector sheets from actual CAD, with HLR projections., sha() (+39 more)

### Community 111 - "analysis/final_validation/run_calculix_v08.py"
Cohesion: 0.20
Nodes (27): main(), bearing_plate_deck(), ccx_executable(), freecad_export(), helper_source_sha256(), hot_mount_deck(), main(), mesh_step() (+19 more)

### Community 112 - "cad/freecad/compact/process_v0621.py"
Cohesion: 0.22
Nodes (24): agitator_shape(), auger_shape(), comb_shape(), dimension_svg(), feature(), guard_shape(), hopper_shape(), housing_shape() (+16 more)

### Community 113 - "FeedDeliveryConfig"
Cohesion: 0.08
Nodes (24): FeedDeliveryConfig, agitator_bridge_current_a, agitator_max_rpm, agitator_minimum_pwm, agitator_to_auger_ratio, agitator_trip_current_a, anomaly_dwell_ms, auger_jam_current_a (+16 more)

### Community 114 - "FeedDeliveryConfig"
Cohesion: 0.08
Nodes (24): FeedDeliveryConfig, agitator_bridge_current_a, agitator_max_rpm, agitator_minimum_pwm, agitator_to_auger_ratio, agitator_trip_current_a, anomaly_dwell_ms, auger_jam_current_a (+16 more)

### Community 115 - "05_SOURCE/cad/freecad/compact/process_v0621.py"
Cohesion: 0.22
Nodes (24): agitator_shape(), auger_shape(), comb_shape(), dimension_svg(), feature(), guard_shape(), hopper_shape(), housing_shape() (+16 more)

### Community 116 - "Compact Full Assembly Front"
Cohesion: 1.00
Nodes (3): Compact Full Assembly Front, Compact Full Assembly Isometric, Compact Full Assembly Top

### Community 117 - "FeedDeliveryConfig"
Cohesion: 0.08
Nodes (24): FeedDeliveryConfig, agitator_bridge_current_a, agitator_max_rpm, agitator_minimum_pwm, agitator_to_auger_ratio, agitator_trip_current_a, anomaly_dwell_ms, auger_jam_current_a (+16 more)

### Community 118 - "pre_push.py"
Cohesion: 0.24
Nodes (6): types, check_push(), Fail before publishing commits whose isolated light suite is not passing., revisions(), PrePushTest, Only exact outgoing commits may pass the local publication preflight.

### Community 119 - "Communities (19 total, 7 thin omitted)"
Cohesion: 0.17
Nodes (12): Communities (19 total, 7 thin omitted), Community 0 - "Community 0", Community 10 - "Community 10", Community 11 - "Community 11", Community 1 - "Community 1", Community 2 - "Community 2", Community 3 - "Community 3", Community 4 - "Community 4" (+4 more)

### Community 120 - "Tests"
Cohesion: 0.16
Nodes (4): calculate(), main(), Tests, verify()

### Community 121 - "build_print_release.py"
Cohesion: 0.10
Nodes (33): Element, build_count_and_bounds(), build_row(), copy_inputs(), corresponding_meshes_match(), csv_rows(), main(), mesh_stats() (+25 more)

### Community 122 - "sys"
Cohesion: 0.03
Nodes (80): Pre/post rear-relief local plate screen; rigid bolt bores, room-temperature…, Pre/post rear-relief local plate screen; rigid bolt bores, room-temperature…, mesh_step(), Quadratic tetrahedral refinement for the scoped thrust-plate comparison., read_gmsh_inp(), main(), Path, Rebuild the GGM Arduino variant and bind the exact binary/source snapshot. (+72 more)

### Community 124 - "configureCalibrationRecord"
Cohesion: 0.14
Nodes (18): CalibrationId, CalibrationRecord, DriveCalibration, GaugeCalibration, PullerCalibration, SpoolerConfig, configureCalibrationRecord, configureCoolingFeedbackCalibration (+10 more)

### Community 125 - "ProcessProfile"
Cohesion: 0.09
Nodes (22): MaterialProfile, ProcessProfile, diameter_ki, diameter_kp, die_c, external_predry_qualified, fan_percent, feeder_rpm (+14 more)

### Community 126 - "ProcessProfile"
Cohesion: 0.09
Nodes (22): MaterialProfile, ProcessProfile, diameter_ki, diameter_kp, die_c, external_predry_qualified, fan_percent, feeder_rpm (+14 more)

### Community 127 - "ProcessProfile"
Cohesion: 0.09
Nodes (22): MaterialProfile, ProcessProfile, diameter_ki, diameter_kp, die_c, external_predry_qualified, fan_percent, feeder_rpm (+14 more)

### Community 130 - "drive_acceptance_v08/package_review.py"
Cohesion: 0.38
Nodes (10): Surprising Connections (you probably didn't know these), encoded_manifest(), gather(), main(), Package the current GGM drive snapshot; never label it a machine release., write_zip(), bound_path(), check_bindings() (+2 more)

### Community 136 - "calculate.py"
Cohesion: 0.19
Nodes (8): gap(), growth(), main(), positive(), Geometry-specific movement and pressure audit; not a pressure/fit approval., sha(), thrust(), PracticalAuditTests

### Community 137 - "artifacts/manifest.json"
Cohesion: 0.14
Nodes (13): artifact_count, artifacts, cross_solver_state, empirical_state, empirical_validation, fabrication_validation, geometry_validation, implementation_state (+5 more)

### Community 138 - "datetime"
Cohesion: 0.32
Nodes (15): datetime, authenticate_run_context(), authenticate_sample(), evaluate(), load(), main(), number(), profile_targets() (+7 more)

### Community 139 - "extruder_rfq_parts"
Cohesion: 0.10
Nodes (21): down_die_body(), down_die_breaker_plate(), down_die_copper_gasket(), down_die_insert(), down_die_relief_retainer(), Machinable 90 degree open-die body, local barrel face at X=40. The local outlet…, Ø15.9 x2 304 breaker plate with seven Ø2 flow holes., Replaceable Ø11.9 x14 die insert: Ø3 x10 land plus 4 mm cone. (+13 more)

### Community 140 - "CalibrationReadiness"
Cohesion: 0.10
Nodes (21): CalibrationReadiness, cooling_current_valid, cooling_feedback_calibration_valid, current_sensor_calibration_valid, current_sensor_valid, dancer_valid, drive_calibration_valid, fan1_tach_valid (+13 more)

### Community 141 - "CalibrationReadiness"
Cohesion: 0.10
Nodes (21): CalibrationReadiness, cooling_current_valid, cooling_feedback_calibration_valid, current_sensor_calibration_valid, current_sensor_valid, dancer_valid, drive_calibration_valid, fan1_tach_valid (+13 more)

### Community 142 - "CoolingMonitorOutput"
Cohesion: 0.16
Nodes (12): CoolingMonitor, invalid_since_ms_, off_feedback_since_ms_, reset, update, CoolingMonitorOutput, fan1_running, fan2_running (+4 more)

### Community 143 - "CalibrationReadiness"
Cohesion: 0.10
Nodes (21): CalibrationReadiness, cooling_current_valid, cooling_feedback_calibration_valid, current_sensor_calibration_valid, current_sensor_valid, dancer_valid, drive_calibration_valid, fan1_tach_valid (+13 more)

### Community 144 - "build_electrical_firmware_release.py"
Cohesion: 0.05
Nodes (57): ast, build_variant(), compile_hex(), diagram_data(), electrical_release(), firmware_docs(), firmware_release(), main() (+49 more)

### Community 145 - "test_p11_execution.py"
Cohesion: 0.35
Nodes (6): make_p11(), p11_stub(), P11ExecutionTest, Path, sha(), write_csv()

### Community 159 - "SpoolerConfig"
Cohesion: 0.06
Nodes (39): clampf(), SpoolerConfig, SpoolerOutput, DriveSpeedController, SpoolerConfig, core_radius_mm, dancer_target_rad, filament_diameter_mm (+31 more)

### Community 160 - "make_fixture"
Cohesion: 0.32
Nodes (7): make_fixture(), P2ExecutionTest, Path, receipt(), refresh_approval(), sha(), write_csv()

### Community 161 - "SpoolerConfig"
Cohesion: 0.06
Nodes (39): clampf(), SpoolerConfig, SpoolerOutput, DriveSpeedController, SpoolerConfig, core_radius_mm, dancer_target_rad, filament_diameter_mm (+31 more)

### Community 164 - "shelf_strip_screen.py"
Cohesion: 0.29
Nodes (6): beam_case(), main(), Path, Conservative strip screen for the compact shredder shelf relocation., sha(), ShelfStripTests

### Community 165 - "Graph Report - PPR  (2026-09-10)"
Cohesion: 0.20
Nodes (10): Community Hubs (Navigation), Corpus Check, Drive closeout review scoped graph, God Nodes (most connected - your core abstractions), Graph Report - PPR  (2026-09-10), Import Cycles, Knowledge Gaps, Suggested Questions (+2 more)

### Community 168 - "SpoolerConfig"
Cohesion: 0.06
Nodes (39): clampf(), SpoolerConfig, SpoolerOutput, DriveSpeedController, SpoolerConfig, core_radius_mm, dancer_target_rad, filament_diameter_mm (+31 more)

### Community 250 - "validate_physical_test.py"
Cohesion: 0.31
Nodes (8): Synthetic regression cases for measurement uncertainty and real trace coverage., main(), check(), Synthetic validator regression tests; none are physical test evidence., evaluate(), number(), outcome(), Screen pressureless measurement records; never operate or authorize hardware.

### Community 251 - "properties"
Cohesion: 0.04
Nodes (44): additionalProperties, const, const, items, minItems, type, additionalProperties, properties (+36 more)

### Community 252 - "finalizeOutput"
Cohesion: 0.38
Nodes (7): ActuatorCommands, MachineViewState, SupervisorOutput, buildView, finalizeOutput, invariantsHold, trackPullerCommand

### Community 258 - "run_phase_load_v08.py"
Cohesion: 0.26
Nodes (14): ring_nodes(), sha256(), load_loaded_phase_qualification(), main(), plate(), Path, 실제 CAD 축/기어 위치에서 하중 변위와 cold backlash를 결합한다., shaft() (+6 more)

### Community 259 - "run_engineering.py"
Cohesion: 0.16
Nodes (17): main(), 정상·purge·rundown·hold·requalification phase의 독립 component 합산 검증., cartridge_heater_fit(), cooling_matrix(), diameter_control(), die_relief_screening(), drive_thresholds(), frame_sensitivity() (+9 more)

### Community 260 - "TachEstimator"
Cohesion: 0.11
Nodes (18): TachEstimator, accepted_pulses_, config_, count_estimate_valid_, count_intervals_, count_rpm_, count_window_start_us_, filtered_rpm_ (+10 more)

### Community 261 - "TachEstimator"
Cohesion: 0.11
Nodes (18): TachEstimator, accepted_pulses_, config_, count_estimate_valid_, count_intervals_, count_rpm_, count_window_start_us_, filtered_rpm_ (+10 more)

### Community 265 - "TachEstimator"
Cohesion: 0.11
Nodes (18): TachEstimator, accepted_pulses_, config_, count_estimate_valid_, count_intervals_, count_rpm_, count_window_start_us_, filtered_rpm_ (+10 more)

### Community 266 - "audit_evidence"
Cohesion: 0.38
Nodes (11): audit_evidence(), check_edge(), issue(), path_for(), read(), scan(), visit(), evidence_current() (+3 more)

### Community 267 - "inspection.py"
Cohesion: 0.33
Nodes (13): alignment(), canonical_sha(), currents(), evidence(), fit_line(), inspect(), interval(), number() (+5 more)

### Community 268 - "analysis/final_validation/run_solid_load_path_closure.py"
Cohesion: 0.20
Nodes (15): cross_matrix(), Work-conjugate weighted rigid-section fit and statically exact surface…, resultant_loads(), rigid_fit_coefficients(), Explicit, right-handed machine-coordinate load resultants, no pressure/force…, station_loads(), support_reactions(), area() (+7 more)

### Community 269 - "dancer_revision.py"
Cohesion: 0.29
Nodes (7): assembly_rows(), axle_parts(), Dancer assembly and machining definitions share the same nominal dimensions., washer_shape(), collar_shape(), Purchased collar reference geometry, not a machining master or load rating., traverse_collar_rows()

### Community 270 - "ScrewMotionMonitor"
Cohesion: 0.18
Nodes (13): DriveSpeedConfig, ScrewMotionOutput, DriveSpeedController, ScrewMotionMonitor, configureSpeedControl, cumulative_revolutions_, last_ms_, last_valid_tach_ms_ (+5 more)

### Community 271 - "configureCalibrationRecord"
Cohesion: 0.14
Nodes (18): CalibrationId, CalibrationRecord, DriveCalibration, GaugeCalibration, PullerCalibration, SpoolerConfig, configureCalibrationRecord, configureCoolingFeedbackCalibration (+10 more)

### Community 272 - "물리 검증·시제품 제작 착수용 검증 계획"
Cohesion: 0.20
Nodes (9): 1. 요약, 2. 지금 바로 시작 가능한 것 / 불가능한 것, 3. 검증 층별 현황, 4. 공백과 작업 패키지, 5. 기존 실패 -> 패키지, 6. 테스트 계획 (요지), 7. 에이전트 운영 규칙 (이 저장소 적용안), 8. 사용자 결정 체크리스트 (+1 more)

### Community 273 - "FeedDeliveryController"
Cohesion: 0.12
Nodes (15): FeedDeliveryConfig, FeedDeliveryController, config_, configure, forward_started_ms_, last_agitator_tach_ms_, last_auger_tach_ms_, pending_anomaly_ (+7 more)

### Community 274 - "configureCalibrationRecord"
Cohesion: 0.14
Nodes (18): CalibrationId, CalibrationRecord, DriveCalibration, GaugeCalibration, PullerCalibration, SpoolerConfig, configureCalibrationRecord, configureCoolingFeedbackCalibration (+10 more)

### Community 275 - "PulseAdapter"
Cohesion: 0.12
Nodes (15): TachEstimator, TachEstimatorConfig, fanConfig(), PulseAdapter, config_, estimator_, initialized_, last_abs_us_ (+7 more)

### Community 276 - "run_sensor_bore_local_candidate.py"
Cohesion: 0.38
Nodes (9): geometry(), main(), nodal_pressure(), pressure_faces(), 최악치 센서 보어의 3D 압력 응력 screen. 고온 재료/열구배 qualification 아님., sha(), stress_records(), temperature_records() (+1 more)

### Community 277 - "analysis/structural/run_load_checks.py"
Cohesion: 0.17
Nodes (17): chamber_joint_screen(), check(), convergence_result(), key_demands(), main(), parse_frd(), plate_deck(), Path (+9 more)

### Community 278 - "PowerLoop"
Cohesion: 0.15
Nodes (5): Numerical plant connected to compiled heater components; never equipment., run_case(), positive(), PowerLoop, CoupledReplayTest

### Community 279 - "Arduino Mega Runtime Schedule"
Cohesion: 0.24
Nodes (10): Allowed Change Scope, External Fusion Promotion Gate, Frozen Architecture Boundary, v0.6.2 Parallel Work Contract, Arduino Mega Runtime Schedule, Compile Resource Evidence, Cooperative Scheduler, Nonblocking Safety Runtime (+2 more)

### Community 280 - "run_controller_replay.py"
Cohesion: 0.15
Nodes (13): loss_case(), main(), Separate external-loss reduction from heater enlargement and contact adequacy., build_library(), source_hashes(), digest(), main(), metrics() (+5 more)

### Community 281 - "properties"
Cohesion: 0.06
Nodes (32): additionalProperties, const, minimum, type, pattern, type, pattern, type (+24 more)

### Community 282 - "HeaterController"
Cohesion: 0.10
Nodes (23): clampf(), HeaterOutput, MachineState, TemperatureReading, HeaterController, applyAllocation, canClearFault, clearFault (+15 more)

### Community 283 - "plate_fea.py"
Cohesion: 0.23
Nodes (9): equilibrium(), exterior_faces(), load_patch(), main(), make_deck(), Candidate-only linear solid guide screen, not a contact or machine approval., sha(), GuideFEATest (+1 more)

### Community 284 - "power_loop_bridge.cpp"
Cohesion: 0.10
Nodes (10): HeaterController, HeaterPowerAllocator, HostLoop, allocator, controller, fault_zone, priority, ppr_loop_cap() (+2 more)

### Community 285 - "validate"
Cohesion: 0.23
Nodes (6): main(), Validate reviewed source records; no checkout or orders., read(), validate(), Cost records cannot invent inventory or a completed checkout., SourceTests

### Community 286 - "generate_manufacturing.py"
Cohesion: 0.20
Nodes (17): export_assembly(), export_shape_set(), main(), Generate VE drive, Gate-1 jig and screw/barrel RFQ artifacts., Human-readable hardwired motor-energy cut schematic for Gate-1., 가열기·센서의 실제 형상과 구매 전 RFQ 계약을 생성한다., Export every non-shredder stock/fabricated machine family., svg_barrel_drawing() (+9 more)

### Community 287 - "tolerance_stack_final.py"
Cohesion: 0.25
Nodes (17): assessed(), clearance(), evidence(), interface(), main(), mating_rows(), note(), numeric_status() (+9 more)

### Community 288 - "ScrewMotionOutput"
Cohesion: 0.20
Nodes (10): ScrewMotionOutput, actual_rpm, command_motion_mismatch, control_pwm, cumulative_revolutions, mismatch_duration_ms, speed_saturated, tach_loss (+2 more)

### Community 289 - "source_sha256"
Cohesion: 0.12
Nodes (15): additional_paid_api_calls, edges, method, nodes, scope, source_sha256, docs/reviews/s0-prestart-20260912/frame_profile_evidence.json, docs/reviews/s0-prestart-20260912/p1_semantic_negative.json (+7 more)

### Community 290 - "DriveSpeedController"
Cohesion: 0.06
Nodes (33): DriveSpeedConfig, ki_pwm_per_rpm_s, kp_pwm_per_rpm, maximum_pwm, maximum_rpm, minimum_stable_rpm, pwm_dead_zone, saturation_dwell_ms (+25 more)

### Community 291 - "FeedDeliveryController"
Cohesion: 0.14
Nodes (13): FeedDeliveryController, config_, forward_started_ms_, last_agitator_tach_ms_, last_auger_tach_ms_, pending_anomaly_, phase_started_ms_, requested_mass_flow_g_h_ (+5 more)

### Community 292 - "HeaterController"
Cohesion: 0.11
Nodes (22): clampf(), HeaterOutput, MachineState, TemperatureReading, HeaterController, applyAllocation, canClearFault, clearFault (+14 more)

### Community 293 - "DriveSpeedController"
Cohesion: 0.06
Nodes (33): DriveSpeedConfig, ki_pwm_per_rpm_s, kp_pwm_per_rpm, maximum_pwm, maximum_rpm, minimum_stable_rpm, pwm_dead_zone, saturation_dwell_ms (+25 more)

### Community 294 - "FeedDeliveryController"
Cohesion: 0.14
Nodes (13): FeedDeliveryController, config_, forward_started_ms_, last_agitator_tach_ms_, last_auger_tach_ms_, pending_anomaly_, phase_started_ms_, requested_mass_flow_g_h_ (+5 more)

### Community 295 - "DriveSpeedController"
Cohesion: 0.06
Nodes (33): DriveSpeedConfig, ki_pwm_per_rpm_s, kp_pwm_per_rpm, maximum_pwm, maximum_rpm, minimum_stable_rpm, pwm_dead_zone, saturation_dwell_ms (+25 more)

### Community 296 - "test_machine_supervisor.cpp"
Cohesion: 0.26
Nodes (12): calibrate(), calibrateDomains(), completeCoolingStartupProbe(), ActuatorCommands, InputSnapshot, MachineSupervisor, SupervisorOutput, enterProductionExtrusion() (+4 more)

### Community 297 - "test_tach_estimator.cpp"
Cohesion: 0.24
Nodes (14): ofstream, TachEstimate, TachEstimateMode, TachEstimator, TachEstimatorConfig, main(), modeName(), pulseInterval() (+6 more)

### Community 298 - "analyze_p12_records.py"
Cohesion: 0.28
Nodes (16): authenticate(), bool_value(), design_limits(), evaluate(), load(), main(), member_file(), number() (+8 more)

### Community 299 - "make_p6_records"
Cohesion: 0.36
Nodes (8): make_p3_release(), make_p5_release(), make_p6_records(), p3_invalid(), p3_valid(), P6ExecutionTest, Path, write_csv()

### Community 302 - "ScrewMotionMonitor"
Cohesion: 0.18
Nodes (13): DriveSpeedConfig, ScrewMotionOutput, DriveSpeedController, ScrewMotionMonitor, configureSpeedControl, cumulative_revolutions_, last_ms_, last_valid_tach_ms_ (+5 more)

### Community 304 - "analyze_p5_records.py"
Cohesion: 0.28
Nodes (15): authenticate(), check_capability(), check_certificates(), check_measurements(), evaluate(), hashish(), interval(), main() (+7 more)

### Community 305 - "analyze_p9_records.py"
Cohesion: 0.28
Nodes (15): authenticate(), bool_value(), evaluate(), limit_ok(), load(), main(), number(), profile_contract() (+7 more)

### Community 306 - "fixture"
Cohesion: 0.32
Nodes (7): digest(), fixture(), P8ExecutionTest, Path, run_eval(), stage_analyzer(), write_csv()

### Community 307 - "validate_p8_firmware_commissioning.py"
Cohesion: 0.33
Nodes (15): auth_file(), close(), finite(), installation(), load(), main(), parse_report(), Path (+7 more)

### Community 308 - "manifest_lib.py"
Cohesion: 0.10
Nodes (28): main(), Build revision-locked SHA-256 manifest for the v0.6.1 safety baseline., artifact_record(), collect_paths(), _frame_members(), _normalized_step(), _normalized_zip(), Path (+20 more)

### Community 309 - "CoolingMonitorOutput"
Cohesion: 0.16
Nodes (12): CoolingMonitor, invalid_since_ms_, off_feedback_since_ms_, reset, update, CoolingMonitorOutput, fan1_running, fan2_running (+4 more)

### Community 310 - "drive_ggm_v08/firmware/arduino_mega/src/feed_delivery_control.cpp"
Cohesion: 0.22
Nodes (13): FeedDeliveryConfig, FeedDeliveryFault, FeedDeliveryInputs, FeedDeliveryOutput, beginAnomaly, clampf, clearFault, configure (+5 more)

### Community 311 - "FeedDeliveryOutput"
Cohesion: 0.14
Nodes (14): FeedDeliveryOutput, agitator_pwm, agitator_target_rpm, auger_pwm, auger_target_rpm, bridge_detected, commanded_mass_flow_g_h, derated (+6 more)

### Community 312 - "HeaterAllocation"
Cohesion: 0.16
Nodes (12): clampf(), HeaterAllocation, HeaterAllocation, actual_time_proportion_command, allocated_duty, allocated_power_w, allocation_deficit, integrator_state (+4 more)

### Community 313 - "PullerCalibration"
Cohesion: 0.06
Nodes (34): PullerCalibration, PullerSpeedOutput, DriveSpeedController, PullerCalibration, ki, kp, maximum_pwm, maximum_rpm (+26 more)

### Community 314 - "integrated_motion"
Cohesion: 0.13
Nodes (15): integrated_motion, continuous_traverse_bounding_envelope_clear, dancer_sample_count, fabrication_authorized, lid_opening_covered, lid_service_axis, lid_service_endpoint_bbox_mm, lid_service_travel_mm (+7 more)

### Community 315 - "traverse_retention"
Cohesion: 0.20
Nodes (10): traverse_retention, checks, collar_quantity, fabrication_authorized, guide_rod_length_mm, holding_force_verified, limitations, manufacturer_source (+2 more)

### Community 316 - "stdint"
Cohesion: 0.09
Nodes (14): FeederMotionMonitor, last_motion_ms_, previous_high_, running_, timeout_ms_, CoolingMonitor, invalid_since_ms_, off_feedback_since_ms_ (+6 more)

### Community 317 - "source/arduino_mega/src/feed_delivery_control.cpp"
Cohesion: 0.22
Nodes (13): FeedDeliveryConfig, FeedDeliveryFault, FeedDeliveryInputs, FeedDeliveryOutput, beginAnomaly, clampf, clearFault, configure (+5 more)

### Community 318 - "FeedDeliveryOutput"
Cohesion: 0.14
Nodes (14): FeedDeliveryOutput, agitator_pwm, agitator_target_rpm, auger_pwm, auger_target_rpm, bridge_detected, commanded_mass_flow_g_h, derated (+6 more)

### Community 319 - "HeaterAllocation"
Cohesion: 0.16
Nodes (12): clampf(), HeaterAllocation, HeaterAllocation, actual_time_proportion_command, allocated_duty, allocated_power_w, allocation_deficit, integrator_state (+4 more)

### Community 320 - "PullerCalibration"
Cohesion: 0.09
Nodes (23): PullerCalibration, PullerSpeedOutput, DriveSpeedController, PullerCalibration, ki, kp, maximum_pwm, maximum_rpm (+15 more)

### Community 321 - "exact_head_evidence_v0621.py"
Cohesion: 0.42
Nodes (8): committed_sha256(), git(), load_json(), main(), Path, v0.6.2.1 검증 결과를 정확한 현재 Git HEAD와 fail-closed로 결속한다., require_hashes(), sha256()

### Community 322 - "FeedDeliveryOutput"
Cohesion: 0.14
Nodes (14): FeedDeliveryOutput, agitator_pwm, agitator_target_rpm, auger_pwm, auger_target_rpm, bridge_detected, commanded_mass_flow_g_h, derated (+6 more)

### Community 323 - "HeaterAllocation"
Cohesion: 0.16
Nodes (12): clampf(), HeaterAllocation, HeaterAllocation, actual_time_proportion_command, allocated_duty, allocated_power_w, allocation_deficit, integrator_state (+4 more)

### Community 324 - "PullerCalibration"
Cohesion: 0.06
Nodes (34): PullerCalibration, PullerSpeedOutput, DriveSpeedController, PullerCalibration, ki, kp, maximum_pwm, maximum_rpm (+26 more)

### Community 325 - "prepare_run.py"
Cohesion: 0.38
Nodes (14): build_manifest(), case_binding(), find_load_spec(), git(), load_json(), main(), Path, 검증된 Fusion 입력 패키지에서 hash-bound 실행 manifest를 만든다. 현재 checkout은 결박 commit 이후일 수… (+6 more)

### Community 326 - "build_p3_inspection_packet.py"
Cohesion: 0.30
Nodes (14): bind_preflight(), build(), check_bindings(), load_inspection(), load_preflight(), main(), merged_meta(), number() (+6 more)

### Community 327 - "make_inputs"
Cohesion: 0.35
Nodes (6): evaluate_with_stubs(), make_inputs(), P9ExecutionTest, prerequisite_stubs(), Path, write_csv()

### Community 329 - "run_qualification_v08.py"
Cohesion: 0.31
Nodes (11): beam_nodes(), main(), modal(), numbers_after(), Path, CalculiX torsion/thermal/modal benchmark와 subsystem SF를 clean-run한다., run(), set_lines() (+3 more)

### Community 330 - "GaugeController"
Cohesion: 0.25
Nodes (6): GaugeCalibration, GaugeController, calibration_, reading_, setCalibration, GaugeReading

### Community 331 - "hook_disc"
Cohesion: 0.09
Nodes (23): placed_cutter_plate(), bearing_retainer_plate(), bearing_side_plate(), cutter_shaft(), _cycloidal_ease(), cycloidal_hook_profile_points(), hook_disc(), motor_mount_plate() (+15 more)

### Community 332 - "GaugeController"
Cohesion: 0.09
Nodes (21): clampf(), GaugeCalibration, GaugeReading, DiameterController, integral_, reset, safe_pause_, update (+13 more)

### Community 333 - "StatePermissions"
Cohesion: 0.15
Nodes (12): PhasePower, average_w, peak_w, StatePermissions, cooling, feeder, process_heaters, puller (+4 more)

### Community 334 - "ActuatorCommands"
Cohesion: 0.05
Nodes (35): ActuatorBackend, apply, ActuatorCommands, cooling_pwm, feeder_enable, feeder_step_hz, heater_on, puller_pwm (+27 more)

### Community 335 - "promote_canonical.py"
Cohesion: 0.48
Nodes (6): current(), load(), main(), Path, Bind the reviewed 470x700x930 layout to the canonical CAD contract., sha()

### Community 336 - "Branch Current and Dual-Fan Tach"
Cohesion: 0.33
Nodes (6): Airflow Measurement Boundary, Branch Current and Dual-Fan Tach, Cooling feedback topology와 한계, CoolingMonitor::update, MachineSupervisor::update, MachineSupervisor::updateCoolingStartupProbe

### Community 337 - "finalizeOutput"
Cohesion: 0.38
Nodes (7): ActuatorCommands, MachineViewState, SupervisorOutput, buildView, finalizeOutput, invariantsHold, trackPullerCommand

### Community 338 - "GaugeController"
Cohesion: 0.09
Nodes (21): clampf(), GaugeCalibration, GaugeReading, DiameterController, integral_, reset, safe_pause_, update (+13 more)

### Community 339 - "StatePermissions"
Cohesion: 0.15
Nodes (12): PhasePower, average_w, peak_w, StatePermissions, cooling, feeder, process_heaters, puller (+4 more)

### Community 340 - "source/arduino_mega/src/hardware_interfaces.h"
Cohesion: 0.11
Nodes (14): ActuatorBackend, apply, CoolingFeedback, current_amp, valid, CoolingFeedbackBackend, read, TemperatureBackend (+6 more)

### Community 341 - "ActuatorCommands"
Cohesion: 0.15
Nodes (13): ActuatorCommands, cooling_pwm, feeder_enable, feeder_step_hz, heater_on, puller_pwm, screw_pwm, shredder_pwm (+5 more)

### Community 342 - "HeaterController"
Cohesion: 0.11
Nodes (22): clampf(), HeaterOutput, MachineState, TemperatureReading, HeaterController, applyAllocation, canClearFault, clearFault (+14 more)

### Community 343 - "SpoolerOutput"
Cohesion: 0.15
Nodes (13): SpoolerOutput, actual_length_delta_mm, cumulative_turns, estimated_radius_mm, jam, measured_rpm, pwm, radius_is_estimated (+5 more)

### Community 344 - "process_v0621/manifest.json"
Cohesion: 0.22
Nodes (8): all_bboxes_within_210_mm, all_valid_solids, assemblies, parameters, parts, physical_validation, revision, source

### Community 345 - "05_SOURCE/release/finalize_engineering_closure_review.py"
Cohesion: 0.14
Nodes (14): evidence_freshness, digest(), dump(), main(), Source-bound review package. Never publishes or declares fabrication approval., safe_path(), declared_map(), is_physics_report() (+6 more)

### Community 346 - "firmware/arduino_mega/src/feed_delivery_control.cpp"
Cohesion: 0.24
Nodes (11): FeedDeliveryFault, FeedDeliveryInputs, FeedDeliveryOutput, beginAnomaly, clampf, clearFault, latchFault, makeOutput (+3 more)

### Community 347 - "DiameterController"
Cohesion: 0.21
Nodes (8): clampf(), GaugeReading, DiameterController, integral_, reset, safe_pause_, update, update

### Community 348 - "StatePermissions"
Cohesion: 0.15
Nodes (12): PhasePower, average_w, peak_w, StatePermissions, cooling, feeder, process_heaters, puller (+4 more)

### Community 349 - "firmware/arduino_mega/src/hardware_interfaces.h"
Cohesion: 0.15
Nodes (9): ActuatorBackend, apply, CoolingFeedback, current_amp, valid, CoolingFeedbackBackend, read, TemperatureBackend (+1 more)

### Community 350 - "ActuatorCommands"
Cohesion: 0.15
Nodes (13): ActuatorCommands, cooling_pwm, feeder_enable, feeder_step_hz, heater_on, puller_pwm, screw_pwm, shredder_pwm (+5 more)

### Community 351 - "SpoolerOutput"
Cohesion: 0.15
Nodes (13): SpoolerOutput, actual_length_delta_mm, cumulative_turns, estimated_radius_mm, jam, measured_rpm, pwm, radius_is_estimated (+5 more)

### Community 353 - "validate_v0621_shadow.py"
Cohesion: 0.31
Nodes (13): evaluate(), evidence(), final(), load(), main(), peak(), Path, Validate v0.6.2.1 shadow traces and emit load/Fusion delta evidence. This… (+5 more)

### Community 354 - "05_SOURCE/validation/test_load_path_closure.py"
Cohesion: 0.40
Nodes (4): distributing_patch_v08, Regression tests for physical signs, resultants and work-conjugate patch…, load_path_contract_v08, Regression tests for physical signs, resultants and work-conjugate patch…

### Community 355 - "test_material_run.py"
Cohesion: 0.35
Nodes (6): make_p10(), MaterialRunTest, p10_stubs(), Path, sha(), write_csv()

### Community 356 - "make_p12"
Cohesion: 0.36
Nodes (6): make_p12(), p11_stub(), P12ExecutionTest, Path, sha(), write_csv()

### Community 357 - "make_record"
Cohesion: 0.40
Nodes (4): make_record(), P9ReceiptTest, Path, write_csv()

### Community 359 - "fixture/manifest.json"
Cohesion: 0.17
Nodes (11): assembly_model, base_dimensions_mm, mounting, nominal_mechanical_travel_limits_mm, physical_state, rows, source_sha256, contract.json (+3 more)

### Community 360 - "test_fixture_geometry.py"
Cohesion: 0.30
Nodes (10): cyl(), main(), FreeCAD prototype: replace hard radial fit by three elastic shoes. Not an…, rotor_sheet(), carrier(), circle(), export_one(), local_to_station() (+2 more)

### Community 361 - "finalizeOutput"
Cohesion: 0.38
Nodes (7): ActuatorCommands, MachineViewState, SupervisorOutput, buildView, finalizeOutput, invariantsHold, trackPullerCommand

### Community 362 - "TachEstimatorConfig"
Cohesion: 0.17
Nodes (12): TachEstimatorConfig, count_min_intervals, count_window_us, expected_max_rpm, expected_min_rpm, filter_time_constant_us, maximum_plausible_acceleration_rpm_s, minimum_pulse_spacing_us (+4 more)

### Community 363 - "integrated_clearance"
Cohesion: 0.15
Nodes (13): integrated_clearance, clearances, fabrication_authorized, not_qualified, object_count, pairs, physical_validation_state, reference_overlaps (+5 more)

### Community 364 - "Purge Completion Gate"
Cohesion: 0.53
Nodes (6): Measured Screw Revolutions, Nominal Purge Mass Limitation, Purge Actual Motion Evidence, Purge Completion Gate, MachineSupervisor::confirmPurgeComplete, ScrewMotionMonitor::update

### Community 365 - "TachEstimatorConfig"
Cohesion: 0.17
Nodes (12): TachEstimatorConfig, count_min_intervals, count_window_us, expected_max_rpm, expected_min_rpm, filter_time_constant_us, maximum_plausible_acceleration_rpm_s, minimum_pulse_spacing_us (+4 more)

### Community 366 - "CoolingMonitorOutput"
Cohesion: 0.33
Nodes (6): CoolingMonitorOutput, fan1_running, fan2_running, fault_bits, invalid_duration_ms, valid

### Community 367 - "TachEstimatorConfig"
Cohesion: 0.17
Nodes (12): TachEstimatorConfig, count_min_intervals, count_window_us, expected_max_rpm, expected_min_rpm, filter_time_constant_us, maximum_plausible_acceleration_rpm_s, minimum_pulse_spacing_us (+4 more)

### Community 368 - "properties"
Cohesion: 0.29
Nodes (7): properties, related_case_bindings, status, study_type, type, enum, enum

### Community 369 - "analyze_p6_records.py"
Cohesion: 0.40
Nodes (12): authenticate(), check_cold(), check_receipt(), evaluate(), limit_ok(), load_validator(), main(), number() (+4 more)

### Community 370 - "analyze_p8_records.py"
Cohesion: 0.35
Nodes (12): boolean(), evaluate(), evidence(), load(), main(), metric_ok(), number(), Path (+4 more)

### Community 371 - "make_fixture"
Cohesion: 0.38
Nodes (6): digest(), make_fixture(), P8FirmwareCommissioningTest, Path, run_validate(), write_csv()

### Community 375 - "analysis/final_validation/beam_torque_recovery.py"
Cohesion: 0.25
Nodes (10): add_measured_root_torque(), expanded_root_torque(), Path, Measured root torque for the existing straight X-axis RECT B31 surrogate. The…, run_case(), shaft_deck(), front_u(), main() (+2 more)

### Community 376 - "470 x 700 x 930 mm compact 배치의 canonical 승격"
Cohesion: 0.40
Nodes (4): 470 x 700 x 930 mm compact 배치의 canonical 승격, 남는 물리 경계, 디지털 근거, 목적

### Community 377 - "v0.8 현재 closure 보고서"
Cohesion: 0.18
Nodes (10): BOM / firmware / manual PDF, branch/PR/release state, design changes and reasons / architecture drift, final dimensions and mass / part count, LC04 resolution / hot-zone mount resolution / final safety factors, print mass and time / STEP STL 3MF count / drawing count, release ZIP hash / known limitations, source baseline and final commit (+2 more)

### Community 378 - "v0.8 현재 closure 보고서"
Cohesion: 0.18
Nodes (10): BOM / firmware / manual PDF, branch/PR/release state, design changes and reasons / architecture drift, final dimensions and mass / part count, LC04 resolution / hot-zone mount resolution / final safety factors, print mass and time / STEP STL 3MF count / drawing count, release ZIP hash / known limitations, source baseline and final commit (+2 more)

### Community 379 - "v0.8 현재 closure 보고서"
Cohesion: 0.18
Nodes (10): BOM / firmware / manual PDF, branch/PR/release state, design changes and reasons / architecture drift, final dimensions and mass / part count, LC04 resolution / hot-zone mount resolution / final safety factors, print mass and time / STEP STL 3MF count / drawing count, release ZIP hash / known limitations, source baseline and final commit (+2 more)

### Community 380 - "S0 시작 전 최종 재검토 - 2026-09-12"
Cohesion: 0.18
Nodes (10): R1 - 최종 GGM 프로파일과 기본 절단표 불일치, R2 - P1 자유서술 필드의 의미 검증 부족, R3 - S0의 무전원 경계, R4 - 안전회로 도면의 표시 품질, S0 시작 전 최종 재검토 - 2026-09-12, S0를 시작할 때의 기록 순서, 공개 자료의 사용법, 다시 실행하여 확인한 것 (+2 more)

### Community 381 - "SupervisorOutput"
Cohesion: 0.40
Nodes (5): ActuatorCommands, SupervisorOutput, actuators, invariants_ok, view

### Community 382 - "SupervisorOutput"
Cohesion: 0.40
Nodes (5): ActuatorCommands, SupervisorOutput, actuators, invariants_ok, view

### Community 383 - "TemperatureReading"
Cohesion: 0.40
Nodes (5): TemperatureReading, celsius, sampled_ms, sensor_open, valid

### Community 384 - "SupervisorOutput"
Cohesion: 0.40
Nodes (5): ActuatorCommands, SupervisorOutput, actuators, invariants_ok, view

### Community 385 - "TachEstimate"
Cohesion: 0.18
Nodes (9): TachEstimateMode, TachEstimate, accepted_pulses, mode, pulse_age_us, rejected_bounce_pulses, rejected_outlier_periods, rpm (+1 more)

### Community 386 - "drive_ggm_v08/manifest.json"
Cohesion: 0.18
Nodes (10): exports, machine_release, motor_envelopes_not_internals, physical_validation, review, inherited_findings, new_interference, profile_tslot_lod_contacts (+2 more)

### Community 387 - "joined"
Cohesion: 0.14
Nodes (14): dancer_arm_shape(), feeder_auger_shape(), feeder_drive_mount_shape(), feeder_reference_drive_shape(), gmp60_60127_reference_shape(), joined(), k_type_probe_shape(), TT Motor GMP60-60127-2460 with ratio-47 gearbox, shaft on +Z. (+6 more)

### Community 388 - "build_p5_inquiry_package.py"
Cohesion: 0.67
Nodes (3): main(), Build a deterministic coupon-only supplier inquiry review ZIP. Never sends or…, sha()

### Community 389 - "PullerSpeedOutput"
Cohesion: 0.18
Nodes (11): PullerSpeedOutput, measured_mm_s, measured_rpm, pwm, pwm_limited, saturated, saturation_duration_ms, speed_error_mm_s (+3 more)

### Community 390 - "TachEstimate"
Cohesion: 0.18
Nodes (9): TachEstimateMode, TachEstimate, accepted_pulses, mode, pulse_age_us, rejected_bounce_pulses, rejected_outlier_periods, rpm (+1 more)

### Community 391 - "execution_checkout_sha"
Cohesion: 0.67
Nodes (3): pattern, type, execution_checkout_sha

### Community 392 - "source_git_sha"
Cohesion: 0.67
Nodes (3): source_git_sha, pattern, type

### Community 393 - "TachEstimate"
Cohesion: 0.18
Nodes (9): TachEstimateMode, TachEstimate, accepted_pulses, mode, pulse_age_us, rejected_bounce_pulses, rejected_outlier_periods, rpm (+1 more)

### Community 394 - "step_sha256"
Cohesion: 0.67
Nodes (3): step_sha256, pattern, type

### Community 397 - "build_physical_evidence_package.py"
Cohesion: 0.35
Nodes (11): build(), discover_from_csv(), discover_from_json(), load(), main(), Path, ZipInfo, Build a review-only evidence bundle rooted at a validated P12 stage release. (+3 more)

### Community 398 - "make_record"
Cohesion: 0.42
Nodes (4): make_record(), P7ExecutionTest, Path, write_csv()

### Community 399 - "slice_prints.py"
Cohesion: 0.26
Nodes (11): first_layer_preview_svg(), gcode_metrics(), main(), normalize_3mf_zip(), parse_time(), Run the pinned PrusaSlicer CLI and replace planning values with slicer evidence., Rewrite a slicer 3MF with stable member order and ZIP metadata., Integrate positive filament-E moves tagged as support material. (+3 more)

### Community 400 - "regional_stress_review.py"
Cohesion: 0.40
Nodes (9): in_web(), main(), percentile(), Path, Converged non-singular thrust-plate web stress review. Uses existing C3D10…, read_nodes(), read_von_mises(), sha() (+1 more)

### Community 401 - "Chiron 기반 최소 제작 기준 — 2026-09-09"
Cohesion: 0.20
Nodes (9): Chiron 기반 최소 제작 기준 — 2026-09-09, 검증과 상태, 도너 적용과 확정 전 확인, 모터·전자부품 최신 회신, 새 PTC, 수량 확정 추가, 시퀀스 기반 모터 기준 선정, 출력 재료와 전력 (+1 more)

### Community 403 - "실제 히터 제어기와 수치 열모델 연결"
Cohesion: 0.20
Nodes (9): PI 변경 근거, PR 실패와 재발 방지, 결과의 의미, 미완료 디지털 항목과 도구 제한, 방법 참고, 실제 히터 제어기와 수치 열모델 연결, 열량 부족을 제어기 문제와 분리, 이번 구현 (+1 more)

### Community 404 - "FeedDeliveryInputs"
Cohesion: 0.20
Nodes (9): FeedDeliveryInputs, agitator_current_a, agitator_rpm, agitator_tach_valid, auger_current_a, auger_rpm, auger_tach_valid, now_ms (+1 more)

### Community 405 - "DriveCalibration"
Cohesion: 0.07
Nodes (26): HeaterOutput, allocated_duty_percent, allocation_deficit_percent, duty_percent, fault_bits, integrator_state, requested_duty_percent, saturation_state (+18 more)

### Community 406 - "one_solid"
Cohesion: 0.12
Nodes (25): die_cartridge_heater_shape(), hot_shield_shape(), mica_band_heater_shape(), motor_adapter_42gp775_shape(), one_solid(), DRV-A42 plate for the requested 42GP/GMP42 family reference., 24 V/100 W custom split mica band in its free state, local barrel axis +Z., TH-TCR-01 bridge retaining the supplier-welded probe stop collar. (+17 more)

### Community 407 - "drive_ggm_v08/firmware/arduino_mega/src/machine_supervisor.h"
Cohesion: 0.05
Nodes (37): MachineSupervisorTestAccess, DriveSpeedConfig, ScrewMotionOutput, DriveSpeedController, ScrewMotionMonitor, configureSpeedControl, cumulative_revolutions_, last_ms_ (+29 more)

### Community 408 - "dancer_retention"
Cohesion: 0.20
Nodes (10): collars, fabrication_authorized, holding_force_verified, manufacturing_lengths_mm, nominal_pivot_endplay_mm, nominal_roller_endplay_mm, physical_validation_state, status (+2 more)

### Community 409 - "FeedDeliveryInputs"
Cohesion: 0.20
Nodes (9): FeedDeliveryInputs, agitator_current_a, agitator_rpm, agitator_tach_valid, auger_current_a, auger_rpm, auger_tach_valid, now_ms (+1 more)

### Community 412 - "FeederMotionMonitor"
Cohesion: 0.20
Nodes (5): FeederMotionMonitor, last_motion_ms_, previous_high_, running_, timeout_ms_

### Community 413 - "ShredderInputs"
Cohesion: 0.29
Nodes (7): ShredderInputs, current_amp, cutter_rpm, heater_or_screw_enabled, now_ms, permission_chain_ok, tach_valid

### Community 414 - "DriveCalibration"
Cohesion: 0.20
Nodes (10): DriveCalibration, drivetrain_efficiency, max_continuous_current_a, max_peak_current_a, motor_to_cutter_ratio, motor_torque_per_amp_nm, no_load_current_a, no_load_cutter_rpm (+2 more)

### Community 415 - "ScrewMotionOutput"
Cohesion: 0.20
Nodes (10): ScrewMotionOutput, actual_rpm, command_motion_mismatch, control_pwm, cumulative_revolutions, mismatch_duration_ms, speed_saturated, tach_loss (+2 more)

### Community 418 - "analyze_ggm_mount_compatibility.py"
Cohesion: 0.29
Nodes (10): axis_compatibility(), bolt_pattern_mismatch_mm(), evaluate(), _interval(), _load_inspection(), main(), Path, Convert authenticated GGM receipt geometry into an as-drawn mount compatibility… (+2 more)

### Community 419 - "analyze_s4_thermal_barrier_tape.py"
Cohesion: 0.36
Nodes (10): auth(), boolean(), evaluate(), main(), num(), Path, Authenticate S4 TH-INS-01 material coupon smoke evidence; never authorizes hot-…, rows() (+2 more)

### Community 420 - "P3 GGM 구동계 벤치 검증 절차"
Cohesion: 0.20
Nodes (9): P3-0: 통전 전 preflight, P3-A: 전류센서 전기 교정, P3-B: 무부하 축 확인, P3-C: 동적 torque-current map, P3-D: 보호핀 release coupon, P3 GGM 구동계 벤치 검증 절차, P3 보정값의 firmware handoff, P3 판정 (+1 more)

### Community 422 - "make_release"
Cohesion: 0.43
Nodes (5): analyzer_stub(), make_release(), P10StageReleaseTest, Path, sha()

### Community 423 - "make_release"
Cohesion: 0.38
Nodes (5): analyzer_stub(), make_release(), P11StageReleaseTest, Path, sha()

### Community 424 - "make_release"
Cohesion: 0.43
Nodes (5): analyzer_stub(), make_release(), P12StageReleaseTest, Path, sha()

### Community 425 - "make_release"
Cohesion: 0.40
Nodes (5): make_release(), P9StageReleaseTest, Path, sha(), stub_analyzer()

### Community 426 - "EvidencePackageTest"
Cohesion: 0.25
Nodes (5): EvidencePackageTest, validate(), fake_validation(), make_graph(), Path

### Community 427 - "FirmwareController"
Cohesion: 0.22
Nodes (3): FirmwareController, Host execution of released HeaterController; no safety/physical certification., ctypes

### Community 428 - "v0.8 공급자 문의 패키지 — 발송·회신 기록"
Cohesion: 0.22
Nodes (8): 1. JLCCNC 1차 문의, 2. 열전대 판매자 문의, 3. 대체 공급자 발송 전 체크, 4. 실제 전송 순서, JLCCNC 회신표, v0.8 공급자 문의 패키지 — 발송·회신 기록, 능력 확인 후 업로드할 파일, 열전대 회신표

### Community 429 - "HS-R1-S2: 고온부 sliding 시험 기반"
Cohesion: 0.22
Nodes (8): 2026-09-09 r2 보완, HS-R1-S2: 고온부 sliding 시험 기반, 실제 생성·실행한 자료, 실측 기록 보강, 제작자료 사용, 중요한 수치와 제한, 해결 구조, 현재 MVP 선택 상태

### Community 430 - "시험 목적과 판정 범위"
Cohesion: 0.22
Nodes (8): r2 추가 시험, 기록 경계 보강, 물리 기록 검사, 수치 시험, 시험 목적과 판정 범위, 패키지, 패키지 r1, 형상

### Community 433 - "drive_ggm_v08/firmware/arduino_mega/src/tach_estimator.cpp"
Cohesion: 0.36
Nodes (8): clampf(), TachEstimate, relativeDifference(), acceptPeriod, estimate, onPulse, periodRpm, reset

### Community 435 - "HeaterOutput"
Cohesion: 0.22
Nodes (9): HeaterOutput, allocated_duty_percent, allocation_deficit_percent, duty_percent, fault_bits, integrator_state, requested_duty_percent, saturation_state (+1 more)

### Community 437 - "source/arduino_mega/src/tach_estimator.cpp"
Cohesion: 0.36
Nodes (8): clampf(), TachEstimate, relativeDifference(), acceptPeriod, estimate, onPulse, periodRpm, reset

### Community 438 - "TraverseOutput"
Cohesion: 0.22
Nodes (9): TraverseOutput, direction, enable, estimated_position_mm, hard_fault, pitch_synchronized, position_valid, step (+1 more)

### Community 439 - "05_SOURCE/cad/freecad/compact/export_validation_geometry_v08.py"
Cohesion: 0.27
Nodes (10): export(), main(), Path, Shape, v0.8 해석용 형상을 controlling FreeCAD Python에서 직접 내보낸다., sha256(), placed_cutter_plate(), bearing_side_plate() (+2 more)

### Community 440 - "test_feed_delivery_control.cpp"
Cohesion: 0.40
Nodes (9): feed_delivery_control, FeedDeliveryController, config(), FeedDeliveryConfig, FeedDeliveryInputs, driveOneRecovery(), healthy(), main() (+1 more)

### Community 441 - "FeedDeliveryInputs"
Cohesion: 0.22
Nodes (9): FeedDeliveryInputs, agitator_current_a, agitator_rpm, agitator_tach_valid, auger_current_a, auger_rpm, auger_tach_valid, now_ms (+1 more)

### Community 442 - "HeaterOutput"
Cohesion: 0.22
Nodes (9): HeaterOutput, allocated_duty_percent, allocation_deficit_percent, duty_percent, fault_bits, integrator_state, requested_duty_percent, saturation_state (+1 more)

### Community 444 - "firmware/arduino_mega/src/tach_estimator.cpp"
Cohesion: 0.36
Nodes (8): clampf(), TachEstimate, relativeDifference(), acceptPeriod, estimate, onPulse, periodRpm, reset

### Community 445 - "prepareProduction"
Cohesion: 0.39
Nodes (5): InputSnapshot, MachineState, MachineSupervisor, MachineSupervisorTestAccess, prepareProduction()

### Community 446 - "mesh_levels"
Cohesion: 0.33
Nodes (6): enum, items, minItems, type, uniqueItems, mesh_levels

### Community 447 - "finalize_v0621_handoff_lock.py"
Cohesion: 0.44
Nodes (9): atomic_json(), bind_file(), committed_bytes(), expand_files(), git(), main(), Path, 최종 v0.6.2.1 engineering source에 두 Fusion handoff 패키지를 결박한다. 이 도구는 solver 결과를… (+1 more)

### Community 448 - "analyze_p7_records.py"
Cohesion: 0.40
Nodes (9): authenticate(), evaluate(), limit_ok(), main(), number(), Path, Fail-closed P7 electrical-safety and logic-only evidence checker. Authenticates…, read_rows() (+1 more)

### Community 449 - "analyze_p9_receipt.py"
Cohesion: 0.40
Nodes (9): authenticate(), bool_value(), evaluate(), main(), number(), Path, Authenticate hot-zone receipt evidence before any P9 heater energization., read_rows() (+1 more)

### Community 450 - "PPR v0.8 물리 검증·제작 준비 기준"
Cohesion: 0.22
Nodes (8): MVP와 smoke 검증 정책, PPR v0.8 물리 검증·제작 준비 기준, 고온부의 현재 물리 기준, 구동부의 현재 물리 기준, 비용을 줄이는 제작 전략, 전기/안전 기준, 파일 역할, 현재 진입 상태

### Community 451 - "make_release"
Cohesion: 0.43
Nodes (4): make_release(), P2StageReleaseTest, Path, sha()

### Community 452 - "P5ExecutionTest"
Cohesion: 0.43
Nodes (3): P5ExecutionTest, synthetic_packet(), write_csv()

### Community 453 - "make"
Cohesion: 0.54
Nodes (3): make(), S4Test, write()

### Community 454 - "validate_p5_stage_release.py"
Cohesion: 0.40
Nodes (9): load_p5(), main(), Path, Validate a reviewed P5 coupon result before P6 entry review. This validator…, repo_dir(), repo_file(), require_time(), sha() (+1 more)

### Community 455 - "validate_p8_stage_release.py"
Cohesion: 0.40
Nodes (9): load_analyzer(), main(), Path, Revalidate a human-reviewed P8 dry-run release before P9 entry review., repo_dir(), repo_file(), require_time(), sha() (+1 more)

### Community 456 - "test_release.py"
Cohesion: 0.47
Nodes (9): main(), v0.6.1 safety-orchestration closure의 구현·release 증거를 검증한다., require(), test_artifacts_and_locks(), test_geometry_budget_and_prints(), test_implementation_and_cross_solver(), test_manufacturing_and_physics(), test_revision_and_stale() (+1 more)

### Community 457 - "beam_screen.py"
Cohesion: 0.15
Nodes (7): benchmark(), closest(), main(), model(), Conditional 3D Euler-Bernoulli comparison, not assembled-joint qualification., stiffness(), SteadyHeatTest

### Community 458 - "GGM 구동부 마감 검토"
Cohesion: 0.25
Nodes (7): GGM 구동부 마감 검토, 검증 재실행, 구동 경로, 배선 및 전력, 제작 데이터 사용, 직접 재검사, 토크 한도와 생산량

### Community 459 - "GGM 구동부 제조도면·수령·교정 마감 r2"
Cohesion: 0.25
Nodes (7): GGM 구동부 제조도면·수령·교정 마감 r2, r2 후속 디지털 폐쇄, 기계 수정, 산출물, 실제 검사와 승인, 재생성, 해석 경계

### Community 460 - "run_feed_surrogate.py"
Cohesion: 0.47
Nodes (8): clamp(), degraded_cases(), main(), nominal_dynamic(), normalized(), P0-H용 결정적 feed/inventory/current/tach surrogate. 이는 입자 DEM의 대체용 설계 판단 모델이며 실측…, state(), sweep_rows()

### Community 461 - "모터 옵션 및 보유품 회신 검토 — 2026-09-09"
Cohesion: 0.25
Nodes (7): 계산, 근거의 경계, 모터 옵션 및 보유품 회신 검토 — 2026-09-09, 실용적 다음 결정, 이후 선정 결과, 재실행과 상태, 판단

### Community 462 - "v0.5.1 구매처·제품 후보 고정 (구매 실행 전 단계)"
Cohesion: 0.25
Nodes (7): v0.5.1 구매처·제품 후보 고정 (구매 실행 전 단계), 구매처·제품 확정 목록, 기각 기록, 상한 준수 옵션 (사용자 결정 필요 — 안전 삭제·와트 축소·donor 0원 조작 없이), 설계 반영, 예산 영향 (바닥에서 재계산한 예상 델타, 2026-08-30), 확정 원칙

### Community 467 - "GaugeCalibration"
Cohesion: 0.29
Nodes (7): GaugeCalibration, u95_mm, valid, x_mm_per_count, x_offset_adc, y_mm_per_count, y_offset_adc

### Community 468 - "FeederMotionMonitor"
Cohesion: 0.25
Nodes (5): FeederMotionMonitor, last_motion_ms_, previous_high_, running_, timeout_ms_

### Community 469 - "ShredderInputs"
Cohesion: 0.29
Nodes (7): ShredderInputs, current_amp, cutter_rpm, heater_or_screw_enabled, now_ms, permission_chain_ok, tach_valid

### Community 470 - "GaugeReading"
Cohesion: 0.25
Nodes (8): GaugeReading, calibrated, mean_mm, ovality_mm, u95_mm, valid, x_mm, y_mm

### Community 473 - "GaugeReading"
Cohesion: 0.25
Nodes (8): GaugeReading, calibrated, mean_mm, ovality_mm, u95_mm, valid, x_mm, y_mm

### Community 475 - "validate_fusion_v0621_package.py"
Cohesion: 0.56
Nodes (8): committed_blob(), digest(), fail(), load_json(), main(), Path, Validate the LC11 package without treating pending solver work as completed., rows()

### Community 476 - "check_axial_retainer_candidate.py"
Cohesion: 0.70
Nodes (4): current(), main(), Bind rear-retainer CAD, tolerance and CalculiX evidence., sha()

### Community 477 - "전방 뚜껑 서비스 공간 재검토"
Cohesion: 0.33
Nodes (5): 구분에 사용한 제조사 자료, 아직 남은 디지털 작업, 원래 목적과 크기, 이번 FreeCAD 검사, 전방 뚜껑 서비스 공간 재검토

### Community 478 - "orchestration_contract.py"
Cohesion: 0.42
Nodes (8): close(), cpp_method(), digest(), main(), numeric_token(), Path, Firmware–Modelica safety-orchestration 계약 동등성과 독립 전력 합산 검증., require()

### Community 480 - "validate_p10_stage_release.py"
Cohesion: 0.42
Nodes (8): load_analyzer(), main(), Path, Revalidate reviewed P10 PLA low-feed evidence before P11 entry review., repo_file(), require_time(), sha(), validate()

### Community 481 - "validate_p11_stage_release.py"
Cohesion: 0.42
Nodes (8): load_analyzer(), main(), Path, Revalidate reviewed P11 PET low-feed evidence before P12 entry review., repo_file(), require_time(), sha(), validate()

### Community 482 - "validate_p12_stage_release.py"
Cohesion: 0.42
Nodes (8): load_analyzer(), main(), Path, Revalidate reviewed P12 evidence as a physical-validation review candidate., repo_file(), require_time(), sha(), validate()

### Community 483 - "validate_p2_stage_release.py"
Cohesion: 0.42
Nodes (8): load_analyzer(), main(), Path, Revalidate reviewed P2 cold-fit evidence before P3/P5 entry review., repo_file(), require_time(), sha(), validate()

### Community 484 - "validate_p3_stage_release.py"
Cohesion: 0.42
Nodes (8): inside(), load_inspection(), main(), Path, Validate a human-reviewed P3 stage-release record before P4 or P6 may consume…, sha(), timestamp(), validate()

### Community 485 - "argparse"
Cohesion: 0.12
Nodes (21): argparse, f(), main(), Generate the AVR tach constants from the machine-readable tach contract., render(), inside(), load_p4(), main() (+13 more)

### Community 486 - "validate_p6_stage_release.py"
Cohesion: 0.42
Nodes (8): load_analyzer(), main(), Path, Revalidate a human-reviewed P6 cold-extruder release before P8 entry review., repo_file(), require_time(), sha(), validate()

### Community 487 - "validate_p7_stage_release.py"
Cohesion: 0.42
Nodes (8): load_analyzer(), main(), Path, Revalidate a human-reviewed P7 logic-safety release for P8/P9 entry review., repo_file(), require_time(), sha(), validate()

### Community 488 - "validate_p9_stage_release.py"
Cohesion: 0.42
Nodes (8): load_analyzer(), main(), Path, Revalidate a reviewed P9 empty-hot-zone release before P10 entry review., repo_file(), require_time(), sha(), validate()

### Community 491 - "PPR 조건부 시퀀스 모터 선정 — 2026-09-09"
Cohesion: 0.29
Nodes (6): PPR 조건부 시퀀스 모터 선정 — 2026-09-09, 결론, 구매 후보와 가격, 비교와 적용 전 남은 변경, 실제 수행한 해석, 재생성 및 검사

### Community 492 - "실용적 MVP로 고온부 마감 방향 수정"
Cohesion: 0.29
Nodes (6): 검증 범위, 실용적 MVP로 고온부 마감 방향 수정, 완료의 기준, 이전 설명의 정정, 최소 변경 우선순위, 현재 결정

### Community 493 - "run_screening.py"
Cohesion: 0.43
Nodes (7): airflow(), airflow_case(), feed(), main(), percentile(), v0.6.2 비-Fusion 공정위험의 결정적 reduced-order screening. 실물 chip size, hopper flow,…, random

### Community 496 - "GMP60 기준 구동 인터페이스 근거 — v0.8"
Cohesion: 0.29
Nodes (6): D-flat 정적 screen, GMP60 기준 구동 인터페이스 근거 — v0.8, 범위와 상태, 수령 합격범위와 제작 한계, 제조사 공개 nominal, 판정

### Community 497 - "Hot-zone 소재·가공 확인 요청서 — JLCCNC 부적합 회신 / 대체 공급자 HOLD"
Cohesion: 0.29
Nodes (6): Hot-zone 소재·가공 확인 요청서 — JLCCNC 부적합 회신 / 대체 공급자 HOLD, JLCCNC 공개 안내 대조, 배럴·스크루 공급자에게 확인할 내용, 센서 홀 공정 선택 시 함께 확인할 인터페이스 — 미채택 후보, 유지판·체결부는 별도 확인, 회신 후 처리

### Community 499 - "T1–T4 프로브 구매 기준 — Tempco MTA1 맞춤품 / 승인도면 HOLD"
Cohesion: 0.29
Nodes (6): T1–T4 프로브 구매 기준 — Tempco MTA1 맞춤품 / 승인도면 HOLD, 열접촉 조건, 원본 사양을 확보한 대체 검토 후보: RND 410-00143, 조사 후보, 짧은 카트리지 대체 검토 후보: Slice Engineering Type K, 확인할 구매 옵션 및 자료

### Community 500 - "실제 히터 제어 코드와 열모델 연동"
Cohesion: 0.29
Nodes (6): PR 알림과 재개 기준, 결과의 사용 제한, 실제 히터 제어 코드와 열모델 연동, 연동 범위, 원리 참고, 제어 코드 변경과 검증

### Community 501 - "PR 정상화 확인과 고온부 방사방향 지지 검토"
Cohesion: 0.29
Nodes (6): PR 실패 알림의 실제 원인, PR 정상화 확인과 고온부 방사방향 지지 검토, 간섭 없이 재배치한 후보, 검증과 남은 작업, 기존 배치에서 추가로 확인한 문제, 열간 정렬과 열손실은 별도 판정

### Community 502 - "PPR v0.8 직접 코드 수정 및 수치 재검증"
Cohesion: 0.29
Nodes (6): PPR v0.8 직접 코드 수정 및 수치 재검증, 실제 변경, 실행 결과, 중요한 새 관찰, 통합 판정과 후속 연결, 파일

### Community 504 - "support_contacts"
Cohesion: 0.29
Nodes (7): support_contacts, base_area_mm2, plate_area_mm2, base_area_mm2, plate_area_mm2, Left, Right

### Community 505 - "exact_head_evidence.py"
Cohesion: 0.39
Nodes (8): git(), load_json(), main(), CompletedProcess, Path, 현재 체크아웃에서 생성된 검증 증거를 정확한 Git HEAD에 결속한다. 이 파일은 저장된 과거 PASS를 재사용하지 않는다. 호출 시점의…, require_current_hashes(), sha256()

### Community 506 - "compare_published.py"
Cohesion: 0.60
Nodes (5): identity(), main(), objects(), Compare immutable published CAD with the current native handoff geometry., sha()

### Community 507 - "finalize_engineering_binding.py"
Cohesion: 0.50
Nodes (7): atomic_json(), digest(), digest_bytes(), git_blob(), main(), Path, Bind LC11 package bytes to an existing immutable engineering source commit.

### Community 510 - "validate_v062_shadow.py"
Cohesion: 0.52
Nodes (6): evaluate(), final(), load(), main(), peak(), validate_summary_evidence()

### Community 512 - "v0.5.1 가상 물리 폐쇄 완료 감사"
Cohesion: 0.29
Nodes (6): v0.5.1 가상 물리 폐쇄 완료 감사, 가상 물리·제어, 독립 gate, 예산과 구성관리, 최종 합격 조건, 형상·제작

### Community 513 - "v0.6.1 safety-orchestration 완료 감사"
Cohesion: 0.29
Nodes (6): Purge와 계측 경계, v0.6.1 safety-orchestration 완료 감사, 검증 증거, 구현 감사, 기준선과 형상, 독립 gate

### Community 514 - "analyze_p3_records.py"
Cohesion: 0.46
Nodes (7): current_fit(), fit_line(), main(), num(), Numeric-only P3 analyzer. It never authorizes or controls hardware., read(), torque()

### Community 515 - "P5 screw/barrel 공정 coupon 실행안"
Cohesion: 0.29
Nodes (6): 1. 공급사 응답을 먼저 닫는다, 2. coupon만 제작한 뒤 비파괴 검사를 먼저 한다, 3. 열처리/질화 증거, 4. 판정, 5. 공급사 문의 review package, P5 screw/barrel 공정 coupon 실행안

### Community 517 - "itertools"
Cohesion: 0.27
Nodes (9): hot_dimension(), main(), Traceable thermal fit bounds. No material certification is inferred from…, required_support_temperature(), sha(), main(), Contact-compatible linear screen using actual FE shoe compliance matrix. No…, solve_contact() (+1 more)

### Community 518 - "pathlib"
Cohesion: 0.02
Nodes (119): main(), Compare actual drive setpoints to conditional demand, without raising limits., sha(), main(), Drive-only object register from the exported native assembly, not purchase…, sha(), Author explicit machining requirements; nominal geometry remains CAD-owned., Empty receiving and calibration packets, never fabricated measurement data. (+111 more)

### Community 519 - "모터 선정 전 시퀀스 부하 산정"
Cohesion: 0.33
Nodes (5): 기존 계산을 그대로 구매 기준으로 쓰지 않은 이유, 모터 선정 전 시퀀스 부하 산정, 사용한 관계, 실제 실행 범위, 입력과 범위

### Community 520 - "PPR 실용적 고온부 마감 검토"
Cohesion: 0.33
Nodes (5): PPR 실용적 고온부 마감 검토, 비용을 줄이는 선택, 실제로 좁힌 문제, 재실행, 중요한 정정

### Community 521 - "Z1 폭 / 지지 위치 변경의 분리 비교"
Cohesion: 0.33
Nodes (5): Z1 폭 / 지지 위치 변경의 분리 비교, 방정식과 검증, 실행과 입력, 이번 계산 결과와 판단, 한계와 출처

### Community 522 - "price_policy"
Cohesion: 0.40
Nodes (4): main(), price_policy(), Return price reporting state without changing the technical gate. The former…, main()

### Community 523 - "추가 부품 확인과 가격 근거"
Cohesion: 0.33
Nodes (5): 공개 가격의 의미, 설계를 닫기 위한 한 번의 재고 회신, 접근 제한 대비, 정격 근거, 추가 부품 확인과 가격 근거

### Community 524 - "v0.6.1 조달 폐쇄 상태"
Cohesion: 0.33
Nodes (5): v0.6.1 조달 폐쇄 상태, 결론, 다음 사용자 승인 지점, 상한 위험, 준비된 실제 입력 양식

### Community 525 - "cutter_shaft"
Cohesion: 0.11
Nodes (23): cutter_shaft(), _cycloidal_ease(), cycloidal_hook_profile_points(), hook_disc(), Unit cycloid displacement, with zero slope at both ends., Return the controlling asymmetric 7-hook profile points., Asymmetric cycloidal-derived hook disc. A long 76 % capture flank follows a…, Ideal 20 degree involute envelope for a purchased steel phase gear. Root… (+15 more)

### Community 526 - "TH-DIE-01 다이 카트리지 히터 선정 근거"
Cohesion: 0.33
Nodes (5): TH-DIE-01 다이 카트리지 히터 선정 근거, 결정, 공식 근거와 계산, 구매·수령·물리 gate, 기각안

### Community 527 - "IF-020 extruder thrust stack 선정·검증 근거"
Cohesion: 0.33
Nodes (5): IF-020 extruder thrust stack 선정·검증 근거, 공식 출처, 남은 물리 gate, 선택 계약, 하중 screen

### Community 528 - "PPR 실용적 MVP 마감 우선순위 — 2026-09-09"
Cohesion: 0.33
Nodes (5): 2026-09-09 Chiron 자산으로 제작기준 갱신, PPR 실용적 MVP 마감 우선순위 — 2026-09-09, 다음 작업의 최소 단위, 단순화하되 유지하는 조건, 변경한 방향

### Community 529 - "PPR v1.0.0-rc1 - 전체 설계 및 제작 인수인계"
Cohesion: 0.33
Nodes (5): PPR v1.0.0-rc1 - 전체 설계 및 제작 인수인계, 검증 범위, 상태, 유지하는 실물 HOLD, 전체 제품을 확인하는 순서

### Community 530 - "TH-TC-01 맞춤 열전대 선정 근거"
Cohesion: 0.33
Nodes (5): TH-TC-01 맞춤 열전대 선정 근거, 공식 근거, 기계 인터페이스, 디지털 구매 계약, 승인도면·수령 합격기준

### Community 531 - "run_binding_sha256"
Cohesion: 0.67
Nodes (3): run_binding_sha256, pattern, type

### Community 532 - "처음 목적에 맞춘 규모 재검토 / 2026-09-15"
Cohesion: 0.29
Nodes (6): 유지할 제품, 이번에 실제로 실행한 결과, 이번에 찾은 공간 낭비, 처음 목적에 맞춘 규모 재검토 / 2026-09-15, 판정 경계, 히터를 키우기 전에 확인한 열손실 예산

### Community 533 - "히터 입력과 전역 오류 래치 재검토"
Cohesion: 0.33
Nodes (5): 남은 디지털 작업, 범위, 실행 마감, 재현과 수정, 히터 입력과 전역 오류 래치 재검토

### Community 534 - "rc1 이후 수정본의 디지털 검토와 사용 제한"
Cohesion: 0.33
Nodes (5): CI 후처리 분리, rc1 이후 수정본의 디지털 검토와 사용 제한, 수치 검증과 설계 적합성은 다르다, 패키지의 증거 완결성 검사, 형상과 조립 상세

### Community 535 - "GGM 통합 형상 수정 및 R1/R2 검토"
Cohesion: 0.33
Nodes (5): GGM 통합 형상 수정 및 R1/R2 검토, 다음 단계의 HOLD, 판정과 한계, 프로파일 축소와 절단표, 형상 수정

### Community 536 - "고온부 입력 결박 보완"
Cohesion: 0.33
Nodes (5): 검증, 고온부 입력 결박 보완, 기존 문제와 수정, 참조, 해석의 한계

### Community 537 - "고온부 sliding prototype 실행 종료 — 2026-09-09"
Cohesion: 0.33
Nodes (5): 결과 위치, 고온부 sliding prototype 실행 종료 — 2026-09-09, 기술 판단, 기존 작업 보존, 다음 판정 경로

### Community 538 - "HS-R1-S2 냉간 실측 준비와 기록 보완"
Cohesion: 0.33
Nodes (5): HS-R1-S2 냉간 실측 준비와 기록 보완, 결과의 의미, 기록에 추가된 요구, 실물 작업 전 확인, 최신 근거와 시험 경로

### Community 539 - "HOLD 근거 조사 / 2026-09-09"
Cohesion: 0.33
Nodes (5): HOLD 근거 조사 / 2026-09-09, 시험 방법의 범위, 재료: 식별 가능한 근거와 적용 한계, 적용 방침, 추력/체결

### Community 540 - "재료 참고자료와 적용 한계"
Cohesion: 0.33
Nodes (5): ATI: ATI 17-7, Hamilton Precision Metals: SS 17-7 PH, SKF: Axial load-carrying capacity, 계산 입력, 재료 참고자료와 적용 한계

### Community 541 - "firmware/manifest.json"
Cohesion: 0.33
Nodes (5): builder_sha256, commissioning_header_sha256, hardware_enabled, physical_validation, profile

### Community 544 - "extruder_screw"
Cohesion: 0.29
Nodes (6): extruder_screw(), extruder_screw_process_coupon(), helical_flight_reference(), 1 mm axial-facet quotation ridge with exact pitch and OD envelope., 16 mm, 16 L/D single-start screw with 8D/4D/4D zones. The helical sweep is…, Three-pitch SCM440 supplier coupon; not an operating screw.

### Community 545 - "v0.8 고온부·하중 경로 직접 보완 — 2026-09-09"
Cohesion: 0.33
Nodes (5): Package use, v0.8 고온부·하중 경로 직접 보완 — 2026-09-09, 계산 범위, 실제 원본 변경, 판정 경계

### Community 546 - "build_ggm_drive_release.py"
Cohesion: 0.52
Nodes (6): main(), Promote the verified GGM drive R2 review into the final manufacturing family., read_csv(), sha(), source_step(), update_active()

### Community 550 - "configuration_control_v0.6.2.1.py"
Cohesion: 0.48
Nodes (6): git(), main(), CompletedProcess, Verify the v0.6.2 source freeze and pre-change Fusion evidence record., resolve(), sha256()

### Community 551 - "geometry"
Cohesion: 0.04
Nodes (47): main(), Read-only FreeCAD station audit; no manufacturing geometry changes., sha(), Regenerate PPR-C01 from the shared v0.5 FreeCAD source., Regenerate PPR-C02 from the shared v0.5 FreeCAD source., Regenerate PPR-C03 from the shared v0.5 FreeCAD source., Regenerate PPR-C04 from the shared v0.5 FreeCAD source., Regenerate PPR-C05 from the shared v0.5 FreeCAD source. (+39 more)

### Community 552 - "freecad_checks.py"
Cohesion: 0.43
Nodes (6): main(), overlap(), FreeCAD collision, load-path and service geometry checks., Return first existing shape for a list of legacy/new names., require(), shape()

### Community 553 - "fusion_worker_handoff_v0621.py"
Cohesion: 0.57
Nodes (6): main(), prepare(), Legacy mandatory cases와 LC11 Fusion worker handoff를 실제 입력으로 검증한다., reject(), require(), validate_schema()

### Community 554 - "GGM 프레임 R1: 절단표와 실제 재고를 연결하는 절차"
Cohesion: 0.33
Nodes (5): GGM 프레임 R1: 절단표와 실제 재고를 연결하는 절차, P2, S0 / P1, 검증 범위, 변경 범위

### Community 555 - "P4 두-cutter coupon 물리 검증"
Cohesion: 0.33
Nodes (5): P4 두-cutter coupon 물리 검증, P4 완료 release와 남은 cutter 잠금, 기록, 시험 구성, 판정 원칙

### Community 556 - "P9 빈 hot-zone 가열 검증"
Cohesion: 0.33
Nodes (5): P9 빈 hot-zone 가열 검증, Stage release, TH-INS-01 열 차단 테이프, 선행 검증, 실행 기록

### Community 558 - "validate_thermal_cutoff_topology.py"
Cohesion: 0.53
Nodes (5): main(), Path, require(), rows(), validate()

### Community 562 - "v062_actuation_contract.py"
Cohesion: 0.57
Nodes (6): main(), v0.6.2 actuation extension과 production code/evidence의 semantic binding 검사., require(), require_tokens(), sha256(), source()

### Community 563 - "v0.5.1 멀티모달 CAD 검토 기록"
Cohesion: 0.33
Nodes (5): v0.5.1 멀티모달 CAD 검토 기록, 검토 중 발견 및 수정, 검토한 실제 이미지, 최종 판정, 필수 시각 검토 결과

### Community 564 - "package_r2.py"
Cohesion: 0.43
Nodes (4): check_bindings(), main(), Package only verified drive manufacturing data; no physical authorization., sha()

### Community 566 - "qualify_hot_zone_digital_v08.py"
Cohesion: 0.60
Nodes (5): bound_current(), main(), Path, Close the v0.8 hot-zone digital design envelope without claiming physical…, sha()

### Community 567 - "P0-H 공정 공급 virtual closure 보고서"
Cohesion: 0.40
Nodes (4): P0-H 공정 공급 virtual closure 보고서, 검증 범위와 결과, 모델 가정과 남은 실물 검증, 판정

### Community 568 - "run_recirculation_surrogate.py"
Cohesion: 0.53
Nodes (5): clamp(), evaluate(), main(), P0-G passive/active recirculation trade와 결정적 transport sweep., trade_rows()

### Community 569 - "P0-G shredder 재순환 virtual closure 보고서"
Cohesion: 0.40
Nodes (4): CAD 및 한계, P0-G shredder 재순환 virtual closure 보고서, 가상 검증 결과, 선택

### Community 570 - "Chiron 기반 마감 판정"
Cohesion: 0.40
Nodes (4): Chiron 기반 마감 판정, 산출물의 현재 의미, 이번에 확정한 선택, 제작도면 동결 전 남은 입력

### Community 572 - "generate_contract_artifacts.py"
Cohesion: 0.47
Nodes (5): digest(), main(), Path, 단일 JSON 계약에서 OpenModelica 제어 상수를 생성한다., real()

### Community 573 - "IF-022 기준 feeder drive 계약"
Cohesion: 0.40
Nodes (4): IF-022 기준 feeder drive 계약, 남은 물리 gate, 설계 판정, 전장·firmware 계약

### Community 574 - "v0.8 solver 검증 보고"
Cohesion: 0.40
Nodes (4): v0.8 solver 검증 보고, 경계와 보류, 실행 환경, 판정

### Community 575 - "v0.6.2.1 Fusion deferred release 정책"
Cohesion: 0.40
Nodes (4): Fail-closed 경계, v0.6.2.1 Fusion deferred release 정책, 결정, 최종 handoff lock

### Community 576 - "before/docs/final/release_notes_v1.0.0-rc1_ko.md"
Cohesion: 0.40
Nodes (4): JLCCNC 공급 능력 회신, PLA/PET Recycling Lab v1.0.0-rc1 제작 후보, 공차 인터페이스 갱신, 펌웨어 소스 증적 재감사

### Community 577 - "v0.8 고온부·하중 경로 직접 보완 — 2026-09-09"
Cohesion: 0.40
Nodes (4): v0.8 고온부·하중 경로 직접 보완 — 2026-09-09, 계산 범위, 실제 원본 변경, 판정 경계

### Community 578 - "열제어 연동 변경의 커밋·배포 사본 검사"
Cohesion: 0.40
Nodes (4): 사전검사에서 실제 차단한 누락, 실제 로컬 검사, 열제어 연동 변경의 커밋·배포 사본 검사, 재생성 결과

### Community 579 - "원격 재연결 후 실제 실행 / 2026-09-14"
Cohesion: 0.40
Nodes (4): 가열계 해석의 중요 제한, 실제 실행 결과, 원격 재연결 후 실제 실행 / 2026-09-14, 이번 수정

### Community 580 - "트래버스 축방향 고정 보완 / 2026-09-14"
Cohesion: 0.40
Nodes (4): STEP 왕복 비교의 보완, 검사 방법과 경계, 트래버스 축방향 고정 보완 / 2026-09-14, 확인된 미완성 구조

### Community 581 - "지지판 후보의 3D 솔리드 검토 / 2026-09-15"
Cohesion: 0.40
Nodes (4): PR 확인, 실행한 비교, 아직 필요한 디지털 검증, 지지판 후보의 3D 솔리드 검토 / 2026-09-15

### Community 582 - "PPR v0.8 steering 검토 기록 — 2026-09-09"
Cohesion: 0.40
Nodes (4): PPR v0.8 steering 검토 기록 — 2026-09-09, 동시 작업 보호, 필요한 steering, 확인 결과

### Community 584 - "공급업체·시험기관 문의 초안 — 미발송"
Cohesion: 0.40
Nodes (4): NSK·체결부 공급자 확인 요청, 공급업체·시험기관 문의 초안 — 미발송, 시험기관 확인 요청, 재료 공급업체 확인 요청

### Community 592 - "test_hardware_adapter_e2e.cpp"
Cohesion: 0.07
Nodes (28): assert, calibration_record, cassert, cmath, cooling_monitor, pullerCalibration(), spoolerConfig(), TraverseHomingController (+20 more)

### Community 594 - "test_guard.cpp"
Cohesion: 0.32
Nodes (7): cstdio, cstdlib, expect(), good(), main(), ggm_drive_guard, GgmInput

### Community 595 - "run_manifest.schema.json"
Cohesion: 0.33
Nodes (5): additionalProperties, required, $schema, title, type

### Community 596 - "completed_utc"
Cohesion: 0.67
Nodes (3): format, type, completed_utc

### Community 598 - "generate_v0621_shadow.py"
Cohesion: 0.47
Nodes (5): fmt(), main(), Path, Generate the v0.6.2.1 OpenModelica shadow contract and runner. The generated…, sha256()

### Community 599 - "v0.6.2.1 기술 blocker closure 보고서"
Cohesion: 0.40
Nodes (4): v0.6.2.1 기술 blocker closure 보고서, 이관된 외부 검증, 판정, 확인된 결과

### Community 601 - "v0.6.2 완료 조건 감사"
Cohesion: 0.40
Nodes (4): 15개 완료 조건, v0.6.2 완료 조건 감사, 실행 순서 26개 항목, 해석 경계와 남은 외부 gate

### Community 602 - "controller_contract.py"
Cohesion: 0.53
Nodes (5): invariant_results(), main(), nominal(), Canonical controller contract drift, power and invariant mutation checks., require()

### Community 603 - "hardware_adapter_v0621.py"
Cohesion: 0.53
Nodes (5): compile_binary(), main(), Path, Compile production-linked tach/drive host tests and publish machine-readable…, sha256()

### Community 604 - "graphify-execution-out/manifest.json"
Cohesion: 0.40
Nodes (4): edges, method, nodes, scope

### Community 605 - "MVP = 최종 제품: 최소 smoke 검증 운용 계약"
Cohesion: 0.40
Nodes (4): MVP = 최종 제품: 최소 smoke 검증 운용 계약, 실패 후 설계 feedback, 실행 원칙, 최소 smoke checkpoint

### Community 606 - "P1 실물 재고·수령검사 실행안"
Cohesion: 0.40
Nodes (4): 1. 먼저 측정할 것, 2. 기록 규칙, 3. 다음 단계로 넘기는 정보, P1 실물 재고·수령검사 실행안

### Community 607 - "P2 냉간 프레임·fit 검증"
Cohesion: 0.40
Nodes (4): P2 stage release, P2 냉간 프레임·fit 검증, 기록, 조립 순서

### Community 608 - "P8 설치 후 motor dry-run"
Cohesion: 0.40
Nodes (4): P8 firmware commissioning evidence, P8 설치 후 motor dry-run, P8 완료 release, 순서

### Community 613 - "test_fusion_policy_v0621.py"
Cohesion: 0.47
Nodes (5): invoke(), main(), CompletedProcess, Fusion tri-state 정책과 존재하는 잘못된 결과의 fail-closed 동작을 검사한다., require()

### Community 614 - "Parent multimodal visual review — coupled-digital-validation-v0.5 (HISTORICAL ARCHIVE)"
Cohesion: 0.40
Nodes (4): Parent multimodal visual review — coupled-digital-validation-v0.5 (HISTORICAL ARCHIVE), 관찰 (조치 불요, 기록 목적), 판정 근거, 확인 내용

### Community 615 - "v0.6.2.1 공정 CAD parent 시각 검토"
Cohesion: 0.40
Nodes (4): PDF 재생성 시각 검토, v0.6.2.1 공정 CAD parent 시각 검토, 제한과 후속 gate, 확인 결과

### Community 620 - "GGM 구동부 계속 작업의 독립 검토"
Cohesion: 0.50
Nodes (3): GGM 구동부 계속 작업의 독립 검토, 마감 때 혼동하면 안 되는 경계, 확인된 결과

### Community 622 - "qualify_die_joint_v08.py"
Cohesion: 0.50
Nodes (4): main(), Path, Digital die-joint load-path qualification; physical leak/retorque remains…, sha()

### Community 624 - "cooling_degradation_v0.6.2.1.py"
Cohesion: 0.70
Nodes (4): entry_temperature(), main(), maximum_safe_rate(), Bounded airflow-degradation and conservative response screening. This is an…

### Community 626 - "build_manifest_v0621.py"
Cohesion: 0.50
Nodes (4): main(), Path, v0.6.2.1 blocker-closure source와 경량 증거의 결정적 manifest를 만든다., sha256()

### Community 627 - "review_keepouts/manifest.json"
Cohesion: 0.50
Nodes (3): classification, objects, revision

### Community 629 - "CI-FULL: CAD 회귀시험과 배포 펌웨어 재현"
Cohesion: 0.50
Nodes (3): CI-FULL: CAD 회귀시험과 배포 펌웨어 재현, 실행 환경 분리, 실행과 확인

### Community 632 - "PR 실패 알림의 원인과 push 전 검사"
Cohesion: 0.50
Nodes (3): PR 실패 알림의 원인과 push 전 검사, 재발 방지, 확인한 상태

### Community 633 - "drawings/manifest.json"
Cohesion: 0.50
Nodes (3): files, physical_state, status

### Community 636 - "LC11 feeder attachment Fusion 패키지"
Cohesion: 0.50
Nodes (3): LC11 feeder attachment Fusion 패키지, 실행 순서, 해석 범위

### Community 640 - "generate_plots.py"
Cohesion: 0.60
Nodes (4): main(), 외부 plotting 의존성 없이 핵심 시나리오 SVG를 생성한다., rows(), svg_plot()

### Community 641 - "build_release_metadata_v0621.py"
Cohesion: 0.60
Nodes (4): load(), main(), 검증된 gate 결과에서 결정론적 v0.6.2.1 release metadata를 생성한다., require()

### Community 643 - "check_phase_path_25_evidence.py"
Cohesion: 0.70
Nodes (4): load_current(), main(), Bind the 25 mm FreeCAD and CalculiX phase-path candidate evidence., sha()

### Community 644 - "v0.6 구현·교차 solver 완료 감사"
Cohesion: 0.50
Nodes (3): v0.6 구현·교차 solver 완료 감사, 미완료 외부·물리 증거, 완료된 디지털 증거

### Community 645 - "configuration_control.py"
Cohesion: 0.60
Nodes (4): git(), main(), Verify immutable archive refs and active revision configuration locks., resolve_any()

### Community 647 - "gate1_readiness.py"
Cohesion: 0.60
Nodes (4): main(), v0.8 two-cutter physical Gate P4 readiness audit; executes no hardware., require(), rows()

### Community 650 - "P10/P11 PLA/PET low-feed physical validation"
Cohesion: 0.50
Nodes (3): Bounded run acceptance, Evidence contract, P10/P11 PLA/PET low-feed physical validation

### Community 651 - "P12 forming/spool full-path validation"
Cohesion: 0.50
Nodes (3): Acceptance, Entry contract, P12 forming/spool full-path validation

### Community 652 - "P1 의미 검사 R2 - 무전원 재고 기록"
Cohesion: 0.50
Nodes (3): P1 의미 검사 R2 - 무전원 재고 기록, PASS 행의 추가 필드, R1 최종 프레임 결박

### Community 653 - "P6 냉간 압출기 조립 검증"
Cohesion: 0.50
Nodes (3): P6 냉간 압출기 조립 검증, 조립·측정 순서, 판정

### Community 654 - "P7 전기 안전·logic 검증"
Cohesion: 0.50
Nodes (3): P7-A: 무통전 검사, P7-B: current-limited logic-only, P7 전기 안전·logic 검증

### Community 655 - "validate_execution_registry.py"
Cohesion: 0.60
Nodes (4): py_compile, main(), req(), resolve()

### Community 656 - "validate"
Cohesion: 0.67
Nodes (3): main(), Path, validate()

### Community 657 - "validate"
Cohesion: 0.67
Nodes (3): main(), Path, validate()

### Community 675 - "generate_config.py"
Cohesion: 0.67
Nodes (3): f(), main(), CAD 기준선과 제어 계약에서 Arduino 제어 상수를 생성한다.

### Community 676 - "case_id"
Cohesion: 0.67
Nodes (3): pattern, type, case_id

### Community 677 - "engineering_source_sha"
Cohesion: 0.67
Nodes (3): pattern, type, engineering_source_sha

### Community 678 - "load_case_manifest_sha256"
Cohesion: 0.67
Nodes (3): pattern, type, load_case_manifest_sha256

### Community 679 - "model_manifest_sha256"
Cohesion: 0.67
Nodes (3): pattern, type, model_manifest_sha256

### Community 680 - "run_id"
Cohesion: 0.67
Nodes (3): run_id, minLength, type

### Community 681 - "solver_version"
Cohesion: 0.67
Nodes (3): solver_version, minLength, type

### Community 682 - "started_utc"
Cohesion: 0.67
Nodes (3): started_utc, format, type

### Community 683 - "step_file"
Cohesion: 0.67
Nodes (3): step_file, pattern, type

### Community 780 - "render_v08_closeups.py"
Cohesion: 0.22
Nodes (9): colored(), global_evidence(), main(), Path, v0.8 module별 closeup evidence와 multimodal review manifest를 생성한다., review_state(), sha(), pil (+1 more)

## Knowledge Gaps
- **3147 isolated node(s):** `scope`, `method`, `nodes`, `edges`, `analysis/drive_acceptance_v08/check_geometry.py` (+3142 more)
  These have ≤1 connection - possible missing edges or undocumented components. (Counts symbols only; 4683 node(s) total have ≤1 connection when file, concept and rationale nodes are included.)
- **220 thin communities (<3 nodes) omitted from report** — run `graphify query` to explore isolated nodes.

## Suggested Questions
_Questions this graph is uniquely positioned to answer:_

- **Why does `MachineSupervisor` connect `MachineSupervisor` to `finalizeOutput`, `CalibrationReadiness`, `configureCalibrationRecord`, `acknowledgeMaterialStep`, `MachineViewState`, `source/arduino_mega/src/machine_supervisor.cpp`, `stdint`?**
  _High betweenness centrality (0.056) - this node is a cross-community bridge._
- **Why does `MachineSupervisor` connect `MachineSupervisor` to `acknowledgeMaterialStep`, `CalibrationReadiness`, `configureCalibrationRecord`, `MachineViewState`, `drive_ggm_v08/firmware/arduino_mega/src/machine_supervisor.h`, `finalizeOutput`, `drive_ggm_v08/firmware/arduino_mega/src/machine_supervisor.cpp`?**
  _High betweenness centrality (0.019) - this node is a cross-community bridge._
- **What connects `scope`, `method`, `nodes` to the rest of the system?**
  _3147 weakly-connected nodes found - possible documentation gaps or missing edges._
- **Should `source_sha256` be split into smaller, more focused modules?**
  _Cohesion score 0.01834862385321101 - nodes in this community are weakly interconnected._
- **Should `MachineSupervisor` be split into smaller, more focused modules?**
  _Cohesion score 0.022727272727272728 - nodes in this community are weakly interconnected._
- **Should `MachineSupervisor` be split into smaller, more focused modules?**
  _Cohesion score 0.022727272727272728 - nodes in this community are weakly interconnected._
- **Should `MachineSupervisor` be split into smaller, more focused modules?**
  _Cohesion score 0.022727272727272728 - nodes in this community are weakly interconnected._
