kotori0919/PLA-PET-Recycling-Lab/docs/reviews/spooler-mechanical-traverse-108-20261020/ANALYSIS_KO.md

# 108_stls.zip 메커니즘 검토와 스풀러 적용 판단

검토 대상: `108_stls.zip`(STL 3개, 2025-04-13자, 출처·라이선스 불명). 외부 파일이므로 빈 디렉터리에 풀어 읽기만 했고 실행 코드는 없다. **이 STL은 저장소에 커밋하지 않았다**(출처·라이선스 미확인, 메시는 FreeCAD source-of-truth가 아님). 이 문서는 검토 기록이며 기존 설계를 바꾸지 않았다. 상태 어휘: OBSERVED(메시 계측), INFERRED(추론), PROPOSED, NOT_RUN.

## 1. 파일 내용 (OBSERVED)

| 파일 | 삼각형 | 외형(mm) | 구성 | 관찰 |
|---|---|---|---|---|
| `obj_1_Assembly.stl` | 4,530 | 40.6 x 52.6 x 6.7 | 2개 덩어리 | L자 크랭크 손잡이(막대+둥근 손잡이)와, 핀이 달린 곡면 쐐기형 부품 |
| `obj_2_Assembly.stl` | 2,228 | 20 x 92 x 37 | 2개 덩어리 | 양끝에 축 구멍이 있는 개방형 프레임, 가운데 창에서 움직이는 10.4 x 15 x 10 mm 핀 구멍 블록 |
| `obj_3_108.3.STL_4.stl` | 99,826 | Ø25 x 80 | 1개 덩어리, 중공 | 바깥에 반복 홈 패턴(10 mm 주기). 홈 개구가 높이에 따라 90도/270도로 번갈아 회전 |

## 2. 메커니즘 판단

INFERRED(신뢰도 중간): 손으로 돌리는 **레벨 와인딩(좌우 왕복) 필라멘트 권취기**로 보인다. 크랭크가 홈 드럼을 돌리고, 프레임 안에서 핀 블록이 홈을 따라 좌우로 움직여 필라멘트를 스풀 폭 방향으로 분배하는 구조다.

한계(OBSERVED/INFERRED): 홈 개구의 중심각은 10 mm 구간마다 약 -180도씩 한 방향으로만 이동했고(약 20 mm/회전, 방향 반전 없음), 홈 단면이 넓은 창 모양이라 나선 홈의 정확한 경로(끝에서의 왕복 반전 여부, 폭, 깊이)를 메시만으로 확정하지 못했다. 렌더 이미지도 반전 구간을 확인할 정도로 선명하지 않았다. 따라서 이 드럼이 자체로 왕복을 만드는지는 **확인되지 않았다**.

## 3. 기존 스풀러와의 대응

현재 설계(`docs/puller_spooler_traverse_control_ko.md`): 트래버스는 전자식이다. 스풀 누적 회전수 x 1.85 mm 피치로 68 mm 삼각파 목표를 만들고, 반전은 회전수·끝점에서 일어나며 A5/A6 리미트 스위치와 missed-limit timeout을 쓴다. 스풀 폭 73 mm, 트래버스 행정 80 mm, 필라멘트 직경 1.75 mm.

기구학(INFERRED, 계산): 피치 1.85 mm/회전 기준, 한 방향 68 mm에 스풀 약 36.8회전이 필요하다. 드럼 리드 L(mm/드럼 1회전)이면 스풀:드럼 기어비는 L/1.85다. 108 드럼의 L이 20 mm라면 약 10.8:1 감속이 필요하다.

기계식 트래버스로 바꾸면 얻는 것(PROPOSED): 피치가 기구적으로 고정되어 소프트웨어·전자 오차가 사라진다. 트래버스 스텝 구동, 리미트 스위치(1,000 KRW 항목), missed-limit 처리가 불필요해진다. 잃거나 새로 생기는 것: 스풀 구동과의 기계 결합(감속 기어 또는 벨트) 설계, 피치를 바꿀 수 없음(필라멘트 직경이나 스풀 변경 시 드럼 교체), 끝 반전부에서의 쌓임(dwell) 가능성, 리미트가 하던 끝 충돌·jam 감지를 대체할 수단.

## 4. 이번에 적용하지 않은 이유와 적용 경로

적용하지 않았다. 이유: (1) 홈 반전 거동을 확정하지 못했다. (2) 드럼 길이 80 mm는 필요 행정 68 mm + 핀 블록 길이(10.4 mm) + 끝 여유에 못 미칠 가능성이 높다(약 90 mm 이상 필요, INFERRED). (3) 외부 STL의 출처·라이선스가 불명이고 FreeCAD 파라메트릭 source-of-truth가 아니다. (4) 트래버스 방식 변경은 펌웨어(traverse control), 전기(스텝 드라이버, A5/A6), BOM, P12 합격 기준(usable width >= 68 mm, 끝 충돌·jam)과 그에 묶인 해시 gate 전체를 다시 검증해야 하는 설계 변경이다.

적용 경로(PROPOSED, 사용자 결정 필요):
1. 반전 홈의 정확한 기하를 확정한다: 원본 CAD/STEP을 구하거나 이 STL의 홈 중심선을 추출한다. 출처·라이선스를 확인한다.
2. FreeCAD Python으로 파라메트릭 반전 홈 드럼과 핀 블록 프레임을 새로 모델링한다(행정 68 mm 이상, 피치 1.85 mm/스풀 회전, 기어비 L/1.85).
3. 전자식 트래버스를 유지한 채 기계식을 병렬 후보로 두고, P12에서 두 방식의 권취 균일도와 끝 충돌을 비교한다.
4. 채택이 결정되면 firmware·electronics·BOM·P12 계약을 한 번에 갱신하고 digital gate를 재실행한다.

## 5. 한계

크랭크 부품(`obj_1`)의 용도는 외형 추정이다. 실제 하중·마찰·권취 품질은 평가하지 않았다. 물리 시험은 NOT_RUN이며 구매·가공·통전은 승인되지 않았다.
