kotori0919/PLA-PET-Recycling-Lab/docs/reviews/steering-20260909/REVIEW_KO.md

# PPR v0.8 steering 검토 기록 — 2026-09-09

Remote Desktop Commander로 현재 작업트리를 읽고 원본·결과 해시와 검증 코드를 대조했다.
이 기록은 새 PASS 또는 제작 승인이 아니다. 시점·입력 해시·상세 불일치는 audit.json에 있다.

## 확인 결과
- 선택한 후보 증거 14개 JSON의 전이 의존 경로에서 8개 해시 불일치를 관찰했다. 설계 오류 8개라는 뜻은 아니다.
- 저장된 20/25 PASS는 생성 후 변경된 현재 작업트리의 합격 수가 아니다.
- hot mount 결과는 B31 지정 온도 해석과 국부 폐형식 bound의 합산이다. 전체 heater/contact 열전달 해석 완료가 아니다.
- TS-16은 alpha12e-6/K, hot mount runner는 alpha17e-6/K를 사용한다. 공통 물성·온도 상태를 먼저 확정해야 한다.
- PASS 인터페이스 14행에 surface_finish NOT_SPECIFIED가 남는다. 기능상 필요하면 도면 근거, 불필요하면 정당한 N/A가 필요하다.
- IF-022의 미선정 donor coupling은 단순 수령검사와 다르다. 제작 reference interface를 먼저 정의해야 한다.
- manifest 등록 펌웨어 원본/출시 소스와 실제 HEX의 해시는 대조에서 일치했다. 재컴파일은 수행하지 않았다.

## 동시 작업 보호
기존 문서 세 파일의 작은 수정안을 준비했지만, 쓰기 직전 원본 해시 변경을 감지하여 적용하지 않았다.
기존 writer가 후보 CAD 미채택 단정 두 문장을 이미 수정한 것을 diff로 확인했고 이를 보존했다.
검토자는 기존 설계·수치·합격기준·문서·Git index를 수정하지 않았다.
이 디렉터리의 독립 audit/review 기록만 추가했으며 commit/push/merge는 하지 않았다.

## 필요한 steering
새로운 후보 탐색보다 공통 입력 확정 → 실제 CAD 채택 → 영향 증거 재생성 → 제작 패키지의 순서로 마감한다.
전이 의존성 검증을 보완하고 설계 결함, 증거 미완, 조달, 실물 commissioning gate를 구분한다.
관찰 중 실제 FreeCAD와 기존 parent가 작업 중이었다. 본 점검은 전체 작업트리의 원자적 snapshot이나 solver 재실행이 아니다.
