kotori0919/PLA-PET-Recycling-Lab/exports/cnc/extruder/shield_service_cover_candidate_ko.pdf

## 점검 덮개 후보 — 가공 승인 금지 / HOLD

EX-SH-01 관련 미채택 부품 · 단위 mm · 정면도 2:1 · 수량 2

소재 후보: 기존 차열판과 같은 2 mm 5052 알루미늄 판. 재질 상태·치수 공차·체결품·표면처리·접지 본딩은 미확정이다. 본 도면은 가공 가능성 검토용이며 발주용이 아니다.

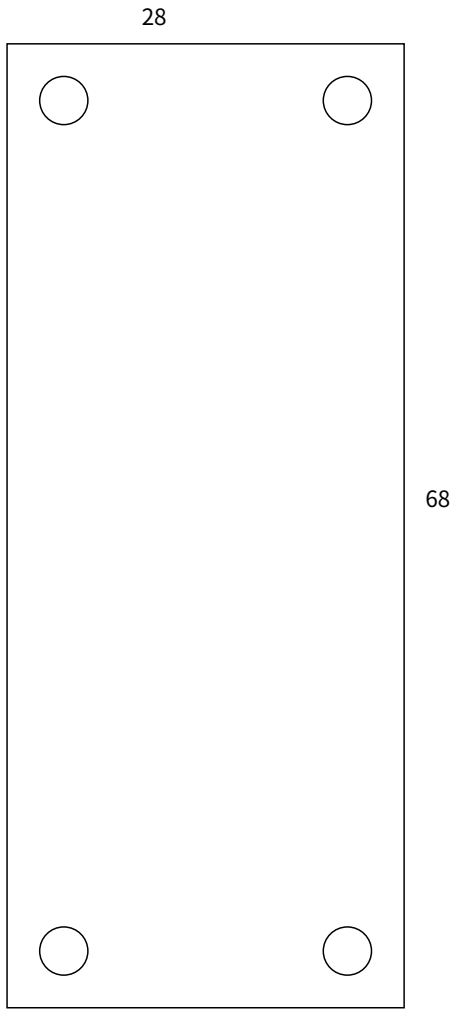
[picture p11: figure]

기준: 정면도 좌하단 = (0,0). 네 구멍은 Ø3.4 관통, 두께 2.

구멍 | X | Z
1 | 4 | 4
2 | 4 | 64
3 | 24 | 4
4 | 24 | 64

최소 명목 외곽 잔여 폭: 2.3 mm. 강도 합격값이 아니다. 맞물리는 점검창은 12×52이며 덮개 중심과 일치한다(각 방향 겹침 8). 나사산 없 음. 관통공만으로 체결·탈락 방지·PE 접지가 성립하지 않는다. 날카로운 모서리 제거 방법과 최종 치수 공차는 공급자 검토 후 확정한다.

검증 범위: STEP 단일 솔리드/부피와 명목 간섭만 검사했다. 체결 강도, 뜨거운 표면 접근 방지, 실제 공구·손 공간 및 물리 시험은 미검증이 다.
