kotori0919/PLA-PET-Recycling-Lab/docs/final/release_approval_report_ko.md

# 배포와 제작 승인 구분

현재 게시 정책은 `release/publication_policy.json`, 기술 상태는 실제 생성된 `validation/results/v08_full_compliance.json`, 현재 사용 파일의 우선순위는 `COMPLETE_HANDOFF_KO.md`를 따른다. 공개 prerelease 게시 승인은 구매·가공·통전·안전 인증의 승인이 아니다. 물리시험은 NOT_RUN이며 세부 미해결 입력은 `open_items_ko.md`에 유지한다.
