kotori0919/PLA-PET-Recycling-Lab/docs/final/jlccnc_zip_readme_ko.md

# JLCCNC 능력 문의 ZIP — 발송 및 회신 기록

상태: `SENT_AND_REPLIED_2026-09-08` · 주문/생산 승인: `NO` · 견적 수락: `NO`

사용자가 문의 메일 발송과 JLCCNC 회신 수신을 확인했다. 원본 회신의 판정과
SHA-256은 `jlccnc_response_2026-09-08_ko.md`에 기록한다.

첨부 내용:

- `01_EMAIL_TO_PASTE.txt`: 실제 발송용 영문 본문
- `02_JLCCNC_CAPABILITY_RESPONSE.csv`: 공급자 회신표
- `03_EX-CPN-BAR.pdf`: 배럴 공정 coupon 참고도
- `04_EX-CPN-SCR.pdf`: 스크루 공정 coupon 참고도

생산품 `EX-BAR-01`과 `EX-SCR-01`의 STEP/DXF/PDF는 포함하지 않았다. 회신 결과
JLCCNC는 현 SCM440/Q&T/가스질화 사양의 일괄 공급처로 부적합하다. 이 문의와
회신은 견적 수락·결제·가공 시작 승인이 아니다.
