kotori0919/PLA-PET-Recycling-Lab/docs/final/release_readiness_ko.md

# v0.8 릴리스 준비도

물리 시험·안전 인증이 아닌 13항목 디지털 산출물 감사다. 전체 compliance와 승인 상태는 `release_notes_v1.0.0-rc1_ko.md` 및 `v08_full_compliance_ko.md`를 따른다. 이 감사의 PASS만으로 제작 후보 승인이나 현재 HOLD 해소를 선언하지 않는다.

- `PASS` baseline_and_archive
- `PASS` solver_evidence
- `PASS` final_step
- `PASS` print_package
- `PASS` hot_zone_manufacturing
- `PASS` hot_zone_bom
- `PASS` firmware_binary
- `PASS` drawing_register
- `PASS` electrical_final_package
- `PASS` final_manual_set
- `PASS` commissioning_set
- `PASS` multimodal_review
- `PASS` release_package

결과: 13/13 — `PASS`
