kotori0919/PLA-PET-Recycling-Lab/docs/reviews/design-load-closure-20260909/pdf_render/page-3.png

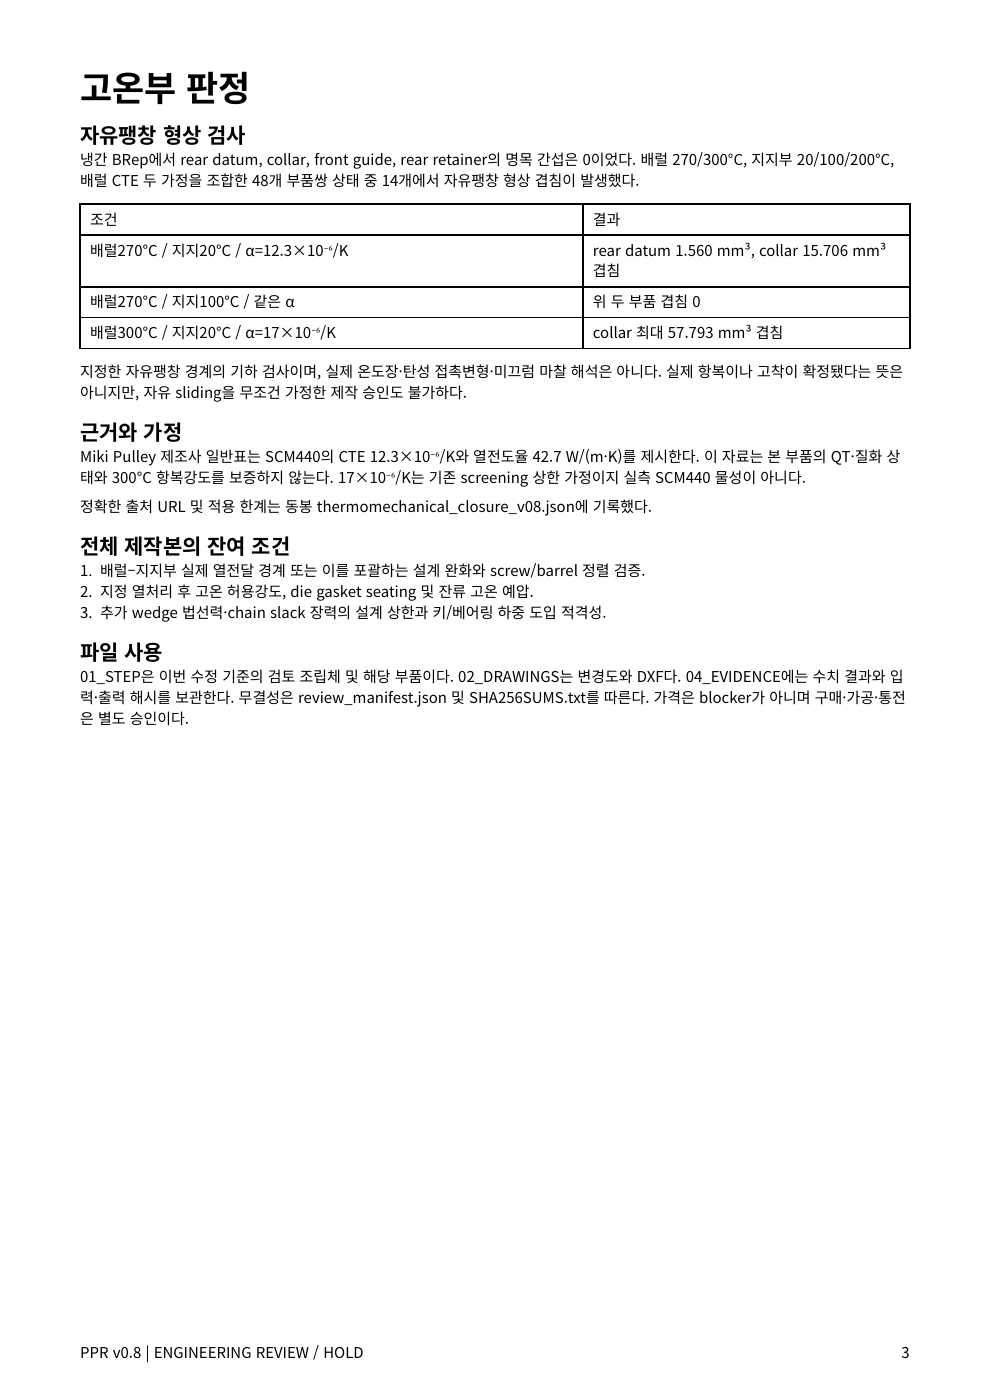
docs/reviews/design-load-closure-20260909/pdf_render/page-3.png
