kotori0919/PLA-PET-Recycling-Lab/docs/final/hot_zone_alternative_supplier_shortlist_ko.md

# Hot-zone 대체 공급자 1차 선별

확인일: 2026-09-09 · 상태: `RFP_READY_NOT_SENT` · 구매/가공 승인: `NO`

JLCCNC 부적합 회신 뒤 공개된 공식 능력만으로 선별했다. 아래 업체를 채택하거나
공개 사양을 설계 입력으로 사용하지 않는다. 정확한 소재, 공정, 치수, 성적서와
coupon-first 순서는 서면 회신으로 다시 확인한다.

| 우선 | 후보/공식 연락처 | 공개 능력과 적합성 | 미확정/탈락 조건 |
|---:|---|---|---|
| 1 | Zhoushan Nanhaiya Plastic Machinery · `info@nhyscrews.com` · https://www.nhyscrews.com/products/single-screw-barrel | 단축 스크루/배럴 Ø15–300 mm, 맞춤 도면 제작, gas nitriding HV900–1000/depth 0.5–0.8 mm/Ra0.4를 명시해 Ø16 형상과 공정 검토가 가능하다. | 공개 재료 목록은 38CrMoAlA/SACM645 등이며 SCM440는 확인되지 않았다. SCM440, 28–32 HRC QT, 최종 0.30–0.50 mm case, 열간 물성, 공차 및 coupon-first 수락을 모두 서면 확인하지 못하면 현 사양에는 부적합하다. |
| 2 | Zhejiang Alven Intelligent Manufacturing · `holly@zsjpjx.com` · https://www.extruderscrewbarrel.com/products.html | 맞춤 압출 스크루/배럴, 40CrMo/38CrMoAlA, 질화 HV900–1000와 Ra0.4 제품군을 공개한다. | 최소 Ø16, SCM440/JIS 추적성, QT 순서, 최종 case, 검사와 coupon-first는 공개 페이지로 확인되지 않았다. 1차 후보가 거절하거나 불완전할 때 같은 패키지로 문의한다. |
| 보조 | ㈜동성금형열처리 · `dongsung@dongsung.co.kr` · 031-499-7071 · https://www.dongsungmht.co.kr/ | SCM440 적용 gas nitriding과 관련 설비를 공개한다. 국내 열처리 공정 후보로 확인 가치가 있다. | 스크루 절삭·deep drilling·최종 honing/grinding 일괄 공급 능력은 확인되지 않았다. 분할 공급망이면 heat/lot 인계, 변형 allowance, 최종 검사 책임 주체가 하나로 닫히지 않는 한 채택하지 않는다. |

## 발송 순서

1. 1순위에는 `dist/PPR-v0.8-SPECIALIST-HOT-ZONE-CAPABILITY-INQUIRY.zip`만 보낸다.
2. 회신표의 모든 필수 항목과 증빙을 내부 검토한 뒤에만 coupon STEP/DXF를 제공한다.
3. 재료·열처리 대체안을 받으면 CAD/CalculiX 입력을 바꾸지 말고 먼저 규격과
   245–270 °C 물성 근거를 검토한다.
4. coupon 견적 수락, 결제, 생산 시작과 본품 발주는 각각 별도 사용자 승인 전 `HOLD`다.
