kotori0919/PLA-PET-Recycling-Lab/exports/print/total_material_report.md

# 출력물 총 재료 보고 — 실제 slicing

- revision: `safety-orchestration-closure-v0.6.1`
- slicer: `PrusaSlicer 2.9.6`, profile `PPR_PrusaSlicer_2.9.6.ini`
- slicer filament: **921.4 g**
- slicer minus solid-CAD nominal: **-195.6 g**
- failed-print reserve 12%: **110.6 g**
- procurement planning mass: **1032.0 g**
- total print time: **82.6 h**
- 1.5 kg target: **PASS**
- G-code support extrusion volume: **24.39 cm³** (nominal mass에 포함)
- PPR-TC01 tolerance coupon (machine total excluded): **50.0 g / 5.3 h**
