kotori0919/PLA-PET-Recycling-Lab/bom/purchase_candidates.csv

item_id | manufacturer_model | required_spec | quantity | candidate_price_krw | price_date | status | url | verification
EX-THR-BRG-01 | NSK 51102 single-direction thrust ball bearing | 15x28x9 mm ISO Normal flat seat Ca10600 N C0a16800 N | 1 | 0 | 2026-09-08 | QUOTE_AND_RECEIPT_HOLD | https://www.nsk.com/engineering/products/bearings/ball-bearings/thrust-ball-bearings/single-direction-thrust-ball-bearings/51102-tb-sd.html | price excluded until quote; verify marking dimensions free rotation and measured height then select 0.05-0.30 mm ground steel shim
SH-MOTOR-DONOR | project-lab wheelchair/conveyor/scooter geared motor | 18-30 V reversible brushed DC cutter-equivalent 14 N.m continuous 24 N.m/3 s peak 20-40 rpm shaft10-20 | 1 | 0 | 2026-08-28 | DONOR_VERIFY_HOLD | project-lab inspection | exact model label quantity state shaft no-load current RPM backlash and 30 min case temperature
SH-MOTOR-REFERENCE | TT Motor GMP60-60127-2460 ratio47 | 24 V 95 rpm no-load 70 rpm rated 9.80665 N.m rated Ø12 shaft 4xM5 PCD45 | 1 | 0 | 2026-08-29 | VENDOR_SELECTED_QUOTE_PENDING | https://www.ttmotor.com/uploads/GMP60-609760127.pdf | digital geometry/dynamics reference only; quote shipping receipt and Gate-1 required before selection; 구매처 확정: TT Motor 공장 직접 RFQ (디지털 기준모터, baseline cash 제외); 국내 유료 대안은 신용모터 GGM 웜기어드 24 V 60 W(약 56,100 KRW, NON_BASELINE_QUOTE_ONLY 유지)
SH-MOTOR-42GP | TT Motor GMP42-775PM ratio51 | 24 V 90 rpm rated 2.5497 N.m rated Ø10 shaft | 1 | 0 | 2026-08-29 | REJECT_CONTINUOUS_TORQUE | https://www.ttmotor.com/uploads/GMP42-775PM.pdf | DRV-A42 retained but this exact variant yields only 5.42 N.m cutter equivalent
SH-DRIVER | BTS7960 43A module candidate | 24 V reversible PWM minimum 20 A for 60 s with heatsink | 1 | 4620 | 2026-08-28 | VENDOR_CONFIRMED_PENDING_BENCH_TEST | https://www.icbanq.com/P014373686 | not accepted by 43 A marking alone; 20 A thermal and voltage-drop bench test; 구매처 확정 2026-08-30 (icbanq P014373686, 4,620 KRW) — 20 A thermal/voltage-drop bench test 전까지 BUY 유지
SH-CURRENT-REFERENCE | ACS758LCB-050B-PFF-T | 50 A bidirectional Hall 40 mV/A genuine Allegro | 1 | 16748 | 2026-08-28 | NON_BASELINE_REFERENCE_OVER_SH_DRIVE_BUCKET | https://www.digikey.kr/ko/products/detail/allegro-microsystems/ACS758LCB-050B-PFF-T/2042745 | BTS7960 candidate와 합계 21368 KRW라 SH-DRIVE 8000 KRW bucket을 초과하므로 기본 BOM에서 제외
SH-CURRENT-DONOR | project-lab 50 A Hall module or 50 A/75 mV low-side shunt plus differential ADC | calibrated 0/5/10/15/20 A feedback and insulated touch-safe conductor path | 1 | 0 | 2026-08-30 | DONOR_VERIFY_OR_QUOTE_REQUIRED_NOT_ZERO_CASH | project-lab inspection | model rating isolation/shunt tolerance wiring and calibration evidence 없이는 0원 확정 금지; torque/current는 sole safety cut이 아님
SH-CHAIN | ANSI number35 chain/sprocket Gate-1 set | 12T motor and 30T cutter sprocket face at least 6 mm plus guarded chain | 1 | 3000 | 2026-08-30 | VENDOR_SELECTED_QUOTE_PENDING | https://kr.misumi-ec.com/vona2/detail/110310384209/ | 구매처 확정: 한국미스미 경제형 스프로켓 35 (ISO 06A/ANSI 35, bore machining option) 12T/30T + #35 chain; 4일 shipped, 수량별 할인; SH-INTERFACE 6,000 KRW bucket 대비 +3,000~+9,000 예상 델타
SH-PHASE-GENERIC | DRV-03 keyed laminated phase pair | module3 Z16 20 degree face18 mm S45C 3x6 mm lamination per gear with 6.2 keyway | 6 | 3000 | 2026-08-30 | GATE1_TARGET_CEILING_RFQ_REQUIRED | exports/drive_interface/parts/DRV-03/DRV-03.dxf | common key plus 2xM4 and 1xØ3 H7 dowel; actual quote above target is budget blocker
SH-MOTOR-NEW-ALT | new industrial gearmotor | functional spec identical to SH-MOTOR-DONOR | 1 | 0 | 2026-08-28 | NON_BASELINE_QUOTE_ONLY | vendor RFQ | only considered if total verified cash remains under 200000 KRW
HT-BAND-01 | custom mica band heater TH-BH-01 | 24 V 100 W ID34.0 +0/-0.1 W45 clamping band high-temp lead cold resistance 5.76 Ω ±10 percent | 3 | 15000 | 2026-08-30 | VENDOR_SELECTED_QUOTE_PENDING | http://www.heater1.co.kr/product7.html | 구매처 후보 확정: 1순위 한국전자전열(대전, 온라인 견적), 2순위 한일전열엔지니어링 http://www.han-il.com/products/korean/band1k.htm, 3순위 AliExpress custom mica band; Omega MBH는 단가 14.5만 KRW/11주로 기각; 견적 전까지 HEAT-BAND 15,000 KRW bucket 유지
HT-CART-01 | Tempco custom Hi-Density Metric cartridge TH-DIE-01 | 24 V 60 W; 321SS; Ø6.500 ±0.013 Type CG; insertion39.50 ±0.20 Type OAL; HTL550 C leads; lead-end cold9.5 minimum; disc-end cold6.4 minimum; custom MFR 304SS t1.5 20x12 flange with 2xØ3.4 on14 pitch | 1 | 0 | 2026-09-08 | CUSTOM_QUOTE_AND_DRAWING_REQUIRED | https://www.tempco.com/Products/Electric-Heaters-and-Elements/Cartridge-Heaters/Hi-Density-Cartridge-Heaters-in-Metric-Sizes.htm | 0 is not a price claim: quote unknown and cash budget must be revised before approval; vendor must accept 24 V/60 W, OD/OAL/flange drawing, 265 C lead environment and watt density; receipt: OD/camber, 9.12-10.56 ohm at20 C, insulation/hipot report and full hand insertion; purchase/energization HOLD
HT-TC-01 | Tempco custom MTA1 TH-TC-01 | Type K single ungrounded; Alloy600 MI Ø3.00±0.03 x25.40±0.25; fiberglass/SS overbraid lead; 538 C potting; supplier-welded Ø6x0.8 stop collars at5.20 or10.00 | 5 | 0 | 2026-09-08 | CUSTOM_QUOTE_AND_DRAWING_REQUIRED | https://www.tempco.com/Products/Temperature-Sensors/Thermocouples/Style-MTA1-MI-Cable-TC-Assembly.htm | 3 barrel +1 die +1 hopper variant; 0 is not a price claim; approved drawing must assign MPNs and confirm short insertion/collar; receipt dimensional, ≥100 Mohm/100 VDC,20 N pull and coupon bias≤2 C/t90≤30 s; purchase HOLD
TEMP-TC-01 | MAX6675 K-type thermocouple module SZH-CH031 | MAX6675 SPI amplifier for T1-T5; use only with separately sourced ungrounded mineral-insulated K probes and common T- electronics reference | 5 | 4500 | 2026-08-30 | VENDOR_CONFIRMED_PENDING_USER_APPROVAL | https://www.devicemart.co.kr/goods/view?no=1362017 | 모듈 5개 계획액 22,500 KRW 반영; supplied grounded probe는 active architecture에 사용 금지; ungrounded probe quote/수령검사와 사용자 승인 필요
ELEC-MOSFET-01 | D4184-class optocoupler MOSFET module | low-side 1-channel opto-isolated MOSFET VDS 40 V minimum 10 A continuous with heatsink per heater channel | 4 | 2500 | 2026-08-30 | VENDOR_SELECTED_PENDING_BENCH_TEST | https://www.devicemart.co.kr/goods/search?keyword=D4184 | 국내 부품몰(디바이스마트/엘레파츠) D4184-class 1ch 모듈; AOD4184 VDS 40 V floor 충족, 10 A continuous thermal bench test 후 채택
ELEC-FUSE-01 | SF139E-class thermal fuse and branch fuse holder | thermal fuse rating per heater_rfq_ko.md receipt contract plus 24 V branch fuse holder and links | 1 lot | 6500 | 2026-08-30 | VENDOR_SELECTED_PENDING_USER_APPROVAL | https://www.devicemart.co.kr/goods/search?keyword=서미스터+온도퓨즈 | 국내 부품몰 조달 경로 확정; 정확 레이팅은 barrel/die 독립 cutoff 요구에 맞춰 수령검사계약 따름; FUSE-ALLOW 6,500 KRW bucket 유지
COOL-FEEDBACK-01 | low-side fan-current feedback parts | shunt plus protected analog amplifier scaled for Mega A4 and exact donor fan normal/open/stall current windows | 1 | 2000 | 2026-08-30 | ALLOWANCE_PENDING_USER_APPROVAL | project-lab inspection | generic allowance only; exact shunt resistance/power/amplifier/creepage and donor-fan calibration must be verified before selection or energization; no purchase performed
FD-DRIVE-01 | StepperOnline 1-CL42T-P07-V41 | 17E1K-07 closed-loop NEMA17 0.72 N.m holding 2.0 A plus CL42T-V41 24-48 VDC driver encoder/cables; 800 pulse/rev; STEP/DIR/ENA/ALM | 1 | 0 | 2026-09-09 | REFERENCE_SELECTED_QUOTE_AND_RECEIPT_HOLD | https://www.omc-stepperonline.com/tp-series-1-axis-closed-loop-stepper-cnc-kit-72ncm-101-98oz-in-nema-17-motor-1-cl42t-p07-v41 | 0 is not a price claim; user approval required; verify label shaft cable driver revision input mode alarm polarity current and low-speed torque curve
FD-GEAR-01 | StepperOnline EG17-G10 | 10:1 96 percent efficiency; continuous permissible torque5 N.m; keyed Ø8 output x21.5; 42x42x55; IP54 | 1 | 0 | 2026-09-09 | REFERENCE_SELECTED_QUOTE_AND_RECEIPT_HOLD | https://www.stepperonline.co.uk/eg-series-planetary-gearbox-gear-ratio-10-1-backlash-15arc-min-for-nema-17-stepper-motor-eg17-g10.html | 0 is not a price claim; verify received pilot mounting pattern key shaft and rating; FD-DA-01/FD-CP-01 fit plus 2.2 N.m torque-arm test before energization
