kotori0919/PLA-PET-Recycling-Lab/bom/rfq_register_v0.6.csv

rfq_id | scope | supplier_candidate | package | status | quoted_total_krw | shipping_tax_krw | lead_time_days | valid_until | evidence_path | next_action
RFQ-01 | CUT-01 cutter coupon then full stack | local laser/waterjet vendor | exports/cnc/CUT-01 + drawing | RFP_READY_NOT_SENT |  |  |  |  |  | user approval required before external RFQ
RFQ-02 | CUT-03 bearing plate matched pair | local laser and bearing-seat finisher | exports/cnc/CUT-03 + drawing | RFP_READY_NOT_SENT |  |  |  |  |  | request material alternative and finish-seat split price
RFQ-03 | CUT-05 keyed shaft pair | local turning/keyway vendor | exports/cnc/CUT-05 + drawing | RFP_READY_NOT_SENT |  |  |  |  |  | request S45C h6/TIR evidence
RFQ-04 | EX-SCR-01 plus process coupon | JLCCNC rejected; Nanhaiya first inquiry candidate, Alven fallback | dist/PPR-v0.8-SPECIALIST-HOT-ZONE-CAPABILITY-INQUIRY.zip | RFP_READY_NOT_SENT |  |  |  |  | docs/final/hot_zone_alternative_supplier_shortlist_ko.md | send only after user chooses recipient; require traceable SCM440 Q&T nitriding final grinding and coupon-first approval
RFQ-05 | EX-BAR-01 plus matched coupon | JLCCNC rejected; Nanhaiya first inquiry candidate, Alven fallback; Dongsung heat-treatment-only lead | dist/PPR-v0.8-SPECIALIST-HOT-ZONE-CAPABILITY-INQUIRY.zip | RFP_READY_NOT_SENT |  |  |  |  | docs/final/hot_zone_alternative_supplier_shortlist_ko.md | send only after user chooses recipient; require final hone and single traceability responsibility
RFQ-06 | custom 24 V band heater x3 | 한국전자전열 / 한일전열 | exports/thermal/heater_rfq_ko.md | RFP_READY_NOT_SENT |  |  |  |  |  | request resistance insulation lead and delivery evidence
RFQ-07 | GMP60-60127-2460 ratio47 | TT Motor factory | bom motor functional specification | RFP_READY_NOT_SENT |  |  |  |  |  | request unit price shipping lead time and exact drawing confirmation
RFQ-08 | #35 12T/30T sprockets and chain | 한국미스미 | bom interface specification | RFP_READY_NOT_SENT |  |  |  |  |  | request bores stock status shipping and lead time
