kotori0919/PLA-PET-Recycling-Lab/exports/review/engineering-closure-20260909/component_review_BOM.csv

part_id | quantity | material | process | critical | step_file | step_sha256 | state
CUT-05 | 1 | S45C QT steel | turn + indexed keyway; black oxide with bearing seats masked | continuous Ø25 h6 =24.987-25.000 across 61905 journals, cutter land and gear/hub land; overall240.0 +/-0.10; TIR<=0.05; 6.005-6.010 keyways at y=0-35 and55-160 with selected key5.995-6.000; 8.005-8.010 keyway at195-240 with selected key7.995-8.000; datum clock0 deg; install slave shaft at Y278 | 01_STEP/CUT-05.step | 6ff76cd2ac8e208196655ab83d41f30e6f4fc38f57e8a77a62309dba868ab997 | ENGINEERING_REVIEW_ONLY_FABRICATION_HOLD
CUT-05R | 1 | S45C QT steel | turn + indexed keyway; black oxide with bearing seats masked | continuous Ø25 h6 =24.987-25.000 across 61905 journals, cutter land and gear/hub land; overall240.0 +/-0.10; TIR<=0.05; all keyway centreplanes clocked25.714 +/-0.02 deg; 6.005-6.010 keyways at y=0-35 and85-165 with selected key5.995-6.000; 8.005-8.010 keyway at212-240 with selected key7.995-8.000; install driven shaft at Y258 | 01_STEP/CUT-05R.step | f811a568d0a2e4a5b9a2d87235a6693b48fb124f4af752174d52d7000185478e | ENGINEERING_REVIEW_ONLY_FABRICATION_HOLD
