kotori0919/PLA-PET-Recycling-Lab/exports/final/step/printed_parts/manifest.csv

part_id | revision | source_object | source_commit | file | format | units | body_count | solid_count | bbox_mm | volume_mm3 | mass_g | sha256 | status | release_gate
PPR-C01 | final-design-fabrication-closure-v0.8 | exports/print/PPR-C01/PPR-C01.step | 93ec6a9c0c2afa3ad72288a967f07b7c8d03c99e | PPR-C01.step | AP214_FALLBACK_FREECAD | mm | 1 | 1 | 195.000000x195.000000x8.000000 | 83050.862325 |  | 74a2e39109177fffe339e75cfeb0acb338bf5c69862d77507d8b43c9465c0caa | PASS | PHYSICAL_FIT_NOT_RUN
PPR-C02 | final-design-fabrication-closure-v0.8 | exports/print/PPR-C02/PPR-C02.step | 93ec6a9c0c2afa3ad72288a967f07b7c8d03c99e | PPR-C02.step | AP214_FALLBACK_FREECAD | mm | 1 | 1 | 190.000000x120.000000x90.000000 | 199061.375441 |  | 83d8d743157027f780b811f9702b00554af1d069947f1f13e70572e9a6cca704 | PASS | PHYSICAL_FIT_NOT_RUN
PPR-C03 | final-design-fabrication-closure-v0.8 | exports/print/PPR-C03/PPR-C03.step | 93ec6a9c0c2afa3ad72288a967f07b7c8d03c99e | PPR-C03.step | AP214_FALLBACK_FREECAD | mm | 1 | 1 | 25.000000x25.000000x100.000000 | 18273.283189 |  | 7984c4371dfbdbdb2080f9698e3c360317984ec3233feece93267e6accb0c46e | PASS | PHYSICAL_FIT_NOT_RUN
PPR-C04 | final-design-fabrication-closure-v0.8 | exports/print/PPR-C04/PPR-C04.step | 93ec6a9c0c2afa3ad72288a967f07b7c8d03c99e | PPR-C04.step | AP214_FALLBACK_FREECAD | mm | 1 | 1 | 100.000000x25.000000x20.000000 | 32049.668222 |  | 54219d2aaac1c66dbf91732fb0884d75f39c0c6c723fe64a2e0f1116cb24c180 | PASS | PHYSICAL_FIT_NOT_RUN
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
