kotori0919/PLA-PET-Recycling-Lab/bom/verified_budget.csv

budget_state | field_or_item | amount_krw | status | evidence_or_blocker
METADATA | revision |  | technical-blocker-closure-v0.6.2.1 | generated from bom/cash_budget.csv
METADATA | PRICE_STATUS |  | INFORMATIONAL | price is reported but does not gate technical release
METADATA | PRICE_RELEASE_BLOCKING |  | false | technical release conjunction excludes price
METADATA | PROCUREMENT_APPROVAL_GATE |  | USER_APPROVAL_REQUIRED | no purchase or payment without user approval
CONDITIONAL_PLANNING_BUDGET | conditional_subtotal | 176076 | INFORMATIONAL | target allowances; not quotes or receipts
CONDITIONAL_PLANNING_BUDGET | print_material_including_support_and_12pct_reserve | 18576 | PRUSASLICER_ESTIMATE | actual toolpath estimate, not purchase receipt
CONDITIONAL_PLANNING_BUDGET | shipping_tax | 0 | INCLUDED_ONLY_IN_CONTINGENCY | no supplier quote
CONDITIONAL_PLANNING_BUDGET | contingency | 20000 | RESERVED | shipping machining variance failed prints fasteners consumables
CONDITIONAL_PLANNING_BUDGET | absolute_total | 196076 | INFORMATIONAL | conditional subtotal plus contingency; no technical release effect
CONDITIONAL_PLANNING_BUDGET | delta_to_former_target | -3924 | INFORMATIONAL_ONLY | not verified purchasing headroom and not a technical gate
OPTIONAL_EMPIRICAL_VALIDATION | gate1_optional_cost | 11900 | EXCLUDED_FROM_DESIGN_RELEASE_MACHINE_TOTAL | requires separate user approval if performed
VERIFIED_PROCUREMENT_BUDGET | verified_quoted_or_receipted_subtotal | 0 | NOT_ESTABLISHED | zero means no item is yet evidence-qualified, not a zero-cost machine
VERIFIED_PROCUREMENT_BUDGET | shipping_tax |  | UNKNOWN | supplier destinations and quotes absent
VERIFIED_PROCUREMENT_BUDGET | print_material_including_support |  | UNKNOWN | filament lot/receipt absent
VERIFIED_PROCUREMENT_BUDGET | contingency | 20000 | RESERVED_NOT_SPENT | cannot be used to hide blocked base cost
VERIFIED_PROCUREMENT_BUDGET | remaining_margin |  | UNKNOWN | cannot calculate until every blocked item has quote/receipt or verified donor evidence
BLOCKED_ITEM | CNC-01 | 10000 | QUOTE_REQUIRED | 동일 CUT-01 flat profile nesting; coupon package는 2장 범위; full stack은 별도 사용자 제작 승인 전 HOLD이며 optional Gate-1은 design-release 필수가 아님
BLOCKED_ITEM | CNC-02 | 3000 | QUOTE_REQUIRED | 동일 flat pattern nesting과 project-lab donor plate 우선; bearing seat만 finish
BLOCKED_ITEM | CNC-03 | 7000 | QUOTE_REQUIRED | 표준 S45C h6 shaft stock과 DRV-02 keyed interface 사용
BLOCKED_ITEM | CNC-04 | 4000 | QUOTE_REQUIRED | Gate-2 aperture 확정 전 coupon만
BLOCKED_ITEM | CNC-05 | 13000 | QUOTE_REQUIRED | EX-CPN-SCR 동일 공정 coupon을 먼저 묶어 견적; full screw HOLD이고 견적 초과 시 budget blocker
BLOCKED_ITEM | CNC-06 | 13000 | QUOTE_REQUIRED | 표준 SCM440 blank와 동일 열처리 lot; EX-CPN-BAR 선행; full barrel HOLD이고 견적 초과 시 blocker
BLOCKED_ITEM | CNC-07 | 5000 | QUOTE_REQUIRED | 표준 봉재 단순 가공과 flat retainer nesting
BLOCKED_ITEM | CNC-08 | 2000 | QUOTE_REQUIRED | project-lab metal flat part 우선
BLOCKED_ITEM | SAFE-ALLOW | 12000 | BUY_HOLD | 재고 확인 시 미사용; 안전 기능 삭제 금지
BLOCKED_ITEM | FUSE-ALLOW | 6500 | BUY_HOLD | exact rating 확인 필요
BLOCKED_ITEM | GAUGE-ALLOW | 5000 | BUY_HOLD | donor LED/photodiode 우선; calibration 전 성능 미확정
BLOCKED_ITEM | THERM-ALLOW | 6500 | BUY_HOLD | donor sheet nesting; PET 온도 등급 확인
BLOCKED_ITEM | HW-ALLOW | 5000 | BUY_HOLD | 표준화된 M4/M5와 donor 실측 후 수량 확정
BLOCKED_ITEM | SH-MOTOR-DONOR | 0 | CONDITIONAL_DONOR_UNVERIFIED | 모델 수량 상태 label 축 무부하전류 확인 전 현금 0원 확정 금지
BLOCKED_ITEM | SH-DRIVE | 8000 | BUY_HOLD | project-lab module 우선; 정격표시를 신뢰하지 않고 20 A 열시험과 donor별 torque calibration 수행
BLOCKED_ITEM | SH-INTERFACE | 6000 | QUOTE_REQUIRED | 12T/30T 표준 blank와 동일 lamination nesting; 특정 coupling/gear MPN 비종속
BLOCKED_ITEM | HEAT-BAND | 15000 | QUOTE_REQUIRED | 국내와 중국 custom RFQ 비교; stock Ø35 대체 금지; 견적 초과는 blocker
BLOCKED_ITEM | HEAT-DIE | 4000 | QUOTE_EXCEEDS_PLANNING_BUCKET_EXPECTED_HOLD | 4,000 KRW is the unchanged planning bucket, not a quote; custom quote and total-budget revision require user approval; vendor drawing/receipt resistance-insulation-fit checks before energization
BLOCKED_ITEM | TEMP-SENSE | 22500 | QUOTE_REQUIRED | 22500 KRW는 devicemart module x5만 포함; Tempco MTA1 custom probe x5와 stop collar 견적은 미포함이므로 견적 수신 후 예산 재승인; 5 channel dimensional/insulation/pull/ice-boiling/coupon response tests
BLOCKED_ITEM | HEAT-MOSFET | 5000 | BUY_HOLD | 각 channel 10 A thermal capability bench test; thermal fuse와 branch fuse 삭제 금지
BLOCKED_ITEM | COOL-FEEDBACK | 2000 | BUY_HOLD | A4 current path plus A14 pin-change tach mux; exact fan tach level shifter/mux wiring and donor calibration required
BLOCKED_ITEM | ACTUATION-TACH | 2000 | BUY_HOLD | donor shaft geometry and Hall voltage level 확인 전 주문 금지; screw actual revolution evidence 필수
BLOCKED_ITEM | TRAVERSE-LIMITS | 1000 | BUY_HOLD | A5/A6 polling input; end-to-end travel and missed-limit timeout 시험 필요
BLOCKED_ITEM | PRINT-ALLOW | 18576 | BUY_HOLD | planning mass 1032.01 g at 18000 KRW/kg
BLOCKED_ITEM | GATE1-METROLOGY | 7500 | BUY_HOLD | optional empirical validation 비용; design-release machine subtotal에서 제외; project-lab 계측기 확인 시 미사용
BLOCKED_ITEM | GATE1-PRINT | 4400 | BUY_HOLD | optional empirical validation 비용; design-release machine subtotal에서 제외; final-machine package와 별도 집계
BLOCKED_ITEM | MACHINE-FAB-DONOR | 0 | CONDITIONAL_DONOR_UNVERIFIED | frame 2020 13.348 m와 local 2040 1.320 m 포함 총 14.668 m의 재고 수량 재질 직진도 실측 전 0원 확정 금지; 부족분은 예산 재검토 blocker
