kotori0919/PLA-PET-Recycling-Lab/exports/final/step/purchased_part_envelopes/manifest.csv

part_id | revision | source_object | source_commit | file | format | units | body_count | solid_count | bbox_mm | volume_mm3 | mass_g | sha256 | status | release_gate
TH-BH-01 | final-design-fabrication-closure-v0.8 | exports/thermal/parts/TH-BH-01/TH-BH-01.step | 93ec6a9c0c2afa3ad72288a967f07b7c8d03c99e | TH-BH-01.step | AP214_FALLBACK_FREECAD | mm | 1 | 1 | 38.044861x38.150000x45.000000 | 9860.430717 |  | 26d0a7a05cfb362e7f1a8b8e81a61897a3bcc63b6d6cd2cbd9533e0402c6693d | PASS | USER_RECEIPT_INSPECTION_REQUIRED
TH-BH-02 | final-design-fabrication-closure-v0.8 | exports/thermal/parts/TH-BH-02/TH-BH-02.step | 93ec6a9c0c2afa3ad72288a967f07b7c8d03c99e | TH-BH-02.step | AP214_FALLBACK_FREECAD | mm | 1 | 1 | 38.044861x38.150000x40.000000 | 8764.827304 |  | b8ad790a5628ecc9672eab1e4fb0c97f17275e25fd6c99a152a0c85525215691 | PASS | USER_RECEIPT_INSPECTION_REQUIRED
TH-DIE-01 | final-design-fabrication-closure-v0.8 | exports/thermal/parts/TH-DIE-01/TH-DIE-01.step | 93ec6a9c0c2afa3ad72288a967f07b7c8d03c99e | TH-DIE-01.step | AP214_FALLBACK_FREECAD | mm | 1 | 1 | 20.000000x40.500000x12.000000 | 1626.902215 |  | d84a7315259190ea5bc4028771c02d1bc3f3f5534c792a09f4a358f2da843e73 | PASS | USER_RECEIPT_INSPECTION_REQUIRED
TH-TC-01 | final-design-fabrication-closure-v0.8 | exports/thermal/parts/TH-TC-01/TH-TC-01.step | 93ec6a9c0c2afa3ad72288a967f07b7c8d03c99e | TH-TC-01.step | AP214_FALLBACK_FREECAD | mm | 1 | 1 | 6.000000x6.000000x70.400000 | 337.878290 |  | 00324324cd9234267bae952480239968223201a5a8fa6be8bfdb539034ac2d3d | PASS | USER_RECEIPT_INSPECTION_REQUIRED
TH-TCR-01 | final-design-fabrication-closure-v0.8 | exports/thermal/parts/TH-TCR-01/TH-TCR-01.step | 93ec6a9c0c2afa3ad72288a967f07b7c8d03c99e | TH-TCR-01.step | AP214_FALLBACK_FREECAD | mm | 1 | 1 | 12.000000x1.500000x16.000000 | 247.143588 |  | 8e562d72a7d5d1da4472e33f74e6fce36e585378b86c8af53f071181b17691ce | PASS | USER_RECEIPT_INSPECTION_REQUIRED
TH-FUSE-01 | final-design-fabrication-closure-v0.8 | exports/thermal/parts/TH-FUSE-01/TH-FUSE-01.step | 93ec6a9c0c2afa3ad72288a967f07b7c8d03c99e | TH-FUSE-01.step | AP214_FALLBACK_FREECAD | mm | 1 | 1 | 20.000000x6.000000x8.000000 | 960.000000 |  | dbe668ef0403d6410a8f7b5769427ea9966d75f2bbc324a1513ad11439db90d6 | PASS | USER_RECEIPT_INSPECTION_REQUIRED
