kotori0919/PLA-PET-Recycling-Lab/validation/results/runtime_traces/puller_tach_startup_grace_and_loss.csv

scenario | timestamp_ms | ui_state | process_phase | material_session | forming_chain_state | fault_reason | drive_calibration_valid | gauge_calibration_valid | current_sensor_calibration_valid | cooling_feedback_calibration_valid | temperature_channels_valid | driver_fault_free | purge_feed_approved | purge_waste_path_confirmed | spool_eligible | waste_mode | heater_fault_latched | shredder_fault_latched | forming_fault_latched | shredder_start_succeeded | pending_material | purge_run_completed | cooling_command_pct | cooling_feedback_valid | cooling_failure_dwell_elapsed | cooling_startup_request | cooling_startup_probe_elapsed_ms | cooling_startup_healthy_dwell_ms | dancer_angle_rad | dancer_hard_stop_rad | nominal_spool_jam | gauge_consecutive_valid_samples | gauge_u95_mm | diameter_error_mm | ovality_mm | stable_duration_ms | transport_delay_elapsed | puller_saturated | estop_active | explicit_restart_issued | purge_screw_revolutions | purge_revolutions_measured | commanded_heater_power_w | phase_peak_envelope_w | cmd_shredder | cmd_screw | cmd_process_heaters | cmd_feeder | cmd_puller | cmd_spooler | cmd_traverse | cmd_cooling | invariant_status
puller_tach_startup_grace_and_loss | 3001 | REQUALIFYING | REQUALIFYING | PLA_ACTIVE | REQUALIFYING | PRE_GRACE_ZERO_RPM_ACCEPTED | True | True | True | True | True | True | False | False | False | True | False | False | False | False | NONE | False | 100.0 | True | False | NONE | 0 | 0 | 0.0 | 0.4363 | False | 2 | 0.02 | 1.19209e-07 | 0.0 | 1499 | False | False | False | True | 0.0 | False | 0.0 | 445 | False | True | False | True | False | False | False | True | True
puller_tach_startup_grace_and_loss | 3002 | FORMING_CHAIN_RUNDOWN | FORMING_CHAIN_RUNDOWN | PLA_ACTIVE | RUNDOWN | PULLER_TACH_FAILURE_AFTER_GRACE | True | True | True | True | True | True | False | False | False | True | False | False | False | False | NONE | False | 100.0 | True | False | NONE | 0 | 0 | 0.0 | 0.4363 | False | 2 | 0.02 | 1.19209e-07 | 0.0 | 1500 | False | False | False | True | 0.0 | False | 0.0 | 437 | False | True | False | False | False | False | False | True | True
puller_tach_startup_grace_and_loss | 2252 | REQUALIFYING | REQUALIFYING | PLA_ACTIVE | REQUALIFYING | NORMAL_PULSE_QUALIFIED | True | True | True | True | True | True | False | False | False | True | False | False | False | False | NONE | False | 100.0 | True | False | NONE | 0 | 0 | 0.0 | 0.4363 | False | 2 | 0.02 | 1.19209e-07 | 0.0 | 750 | False | False | False | True | 0.0 | False | 100.0 | 445 | False | True | True | True | True | False | False | True | True
puller_tach_startup_grace_and_loss | 2253 | FORMING_CHAIN_RUNDOWN | FORMING_CHAIN_RUNDOWN | PLA_ACTIVE | RUNDOWN | PULLER_TACH_FAILURE_AFTER_QUALIFICATION | True | True | True | True | True | True | False | False | False | True | False | False | False | False | NONE | False | 100.0 | True | False | NONE | 0 | 0 | 0.0 | 0.4363 | False | 2 | 0.02 | 1.19209e-07 | 0.0 | 751 | False | False | False | True | 0.0 | False | 100.0 | 437 | False | True | True | False | False | False | False | True | True
