kotori0919/PLA-PET-Recycling-Lab/cad/generation/fcstd/compact_full_assembly.FCStd

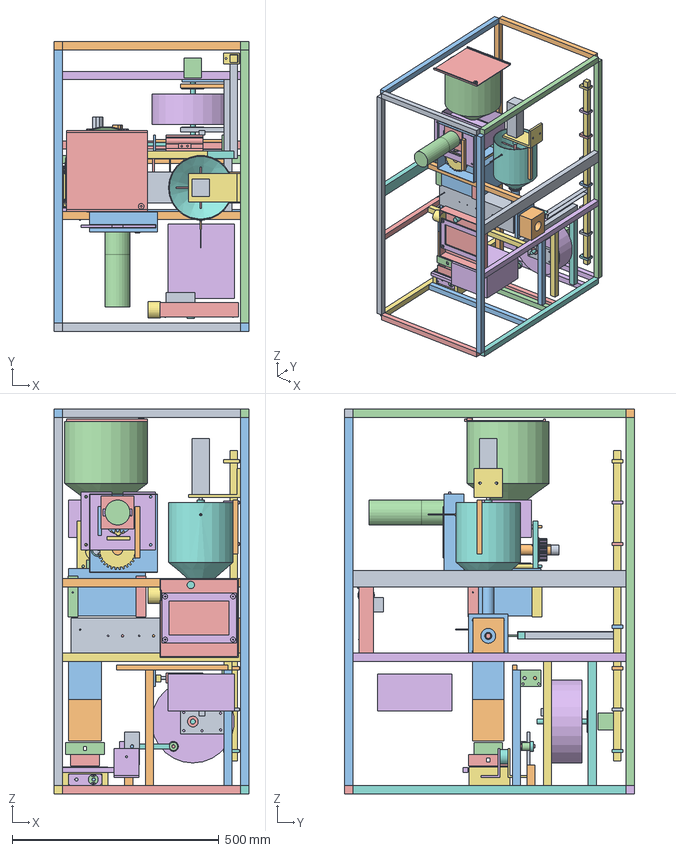
[picture p15: CAD file, 2026-10-19]
cad/generation/fcstd/compact_full_assembly.FCStd
470.0 x 700.0 x 930.0 mm
FrameColumn0_0
FrameColumn0_680
FrameColumn450_0
FrameColumn450_680
FrameX0_0
FrameX0_680
FrameY0_0
FrameY0_450
FrameX910_0
FrameX910_680
FrameY910_0
FrameY910_450
FrameTierY320_0
FrameTierY320_450
MidRail320
FrameTierY500_0
FrameTierY500_450
MidRail500
FrameBottomCross275
FrameBottomCross405
FrameBottomCross440
FrameBottomCross608
FrameSpoolColumnFront
FrameSpoolColumnRear
FrameSpoolTopRail
FrameTraversePostLeft
FrameTraversePostRight
MetalHopper
PPR-C01_SlidingLid
PPR-C02_AntiReach
CutterPlateFront
CutterPlateRear
Shaft105
Hook105_0
Hook105_1
Hook105_2
Hook105_3
Hook105_4
Hook105_5
Bearing105_315
Bearing105_455
Shaft153
Hook153_0
Hook153_1
Hook153_2
Hook153_3
Hook153_4
Hook153_5
Bearing153_315
Bearing153_455
CUT09Sleeve70_550
M6Fastener70_550
CUT09Sleeve70_645
M6Fastener70_645
CUT09Sleeve190_550
M6Fastener190_550
CUT09Sleeve190_645
M6Fastener190_645
Screen
PPR-C04_ScreenHandle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
