kotori0919/PLA-PET-Recycling-Lab/exports/jigs/gate1/gate1_assembly.FCStd

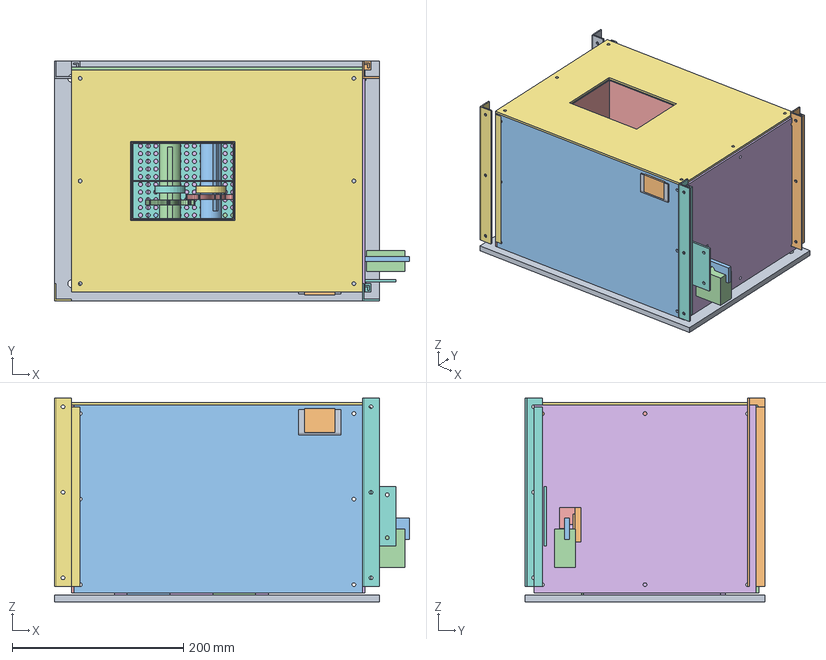
[picture p17: CAD file, 2026-10-19]
exports/jigs/gate1/gate1_assembly.FCStd
415.0 x 280.0 x 238.0 mm
G1JBase
CUT03Front
CUT03Rear
CUT05Shaft135
Bearing135_58
Bearing135_198
SplitCollar135_48
SplitCollar135_126
SplitCollar135_190
SplitCollar135_210
CUT05Shaft183
Bearing183_58
Bearing183_198
SplitCollar183_48
SplitCollar183_126
SplitCollar183_190
SplitCollar183_210
CUT08Front
CUT08Rear
CUT01Coupon135
CUT01Coupon183
G1J08ScreenRailLeft
G1J08ScreenRailRight
CUT04ScreenCoupon
PhaseGear135
PhaseGear183
TorqueArm250
ForceGauge
FeedChute
ChipTray
G1J07Upright0_0
G1J07Upright360_0
G1J07Upright0_260
G1J07Upright360_260
GuardFront
GuardRear
GuardLeft
GuardRight
GuardTop
TorqueSlotBaffle
G1J09InterlockBracket
GuardInterlockSwitch
G1J10PlateFoot85_66
G1J10PlateFoot185_66
G1J10PlateFoot85_194
G1J10PlateFoot185_194
GuardCorner20_10
GuardCorner360_10
GuardCorner20_270
GuardCorner360_270
