kotori0919/PLA-PET-Recycling-Lab/exports/review/engineering-closure-20260909/01_STEP/PPR-ASSEMBLY-REVIEW.step

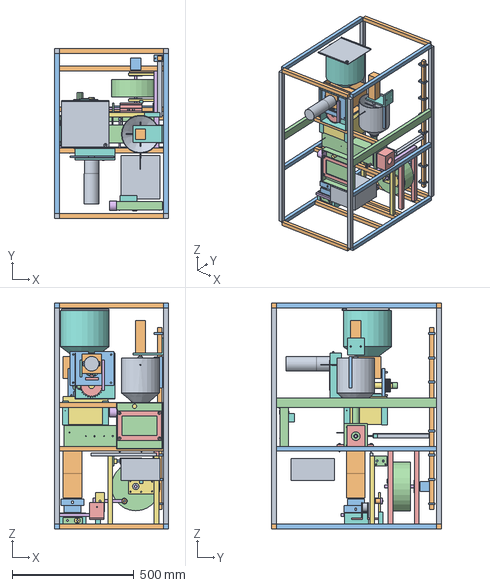
[picture p18: CAD file, 2026-10-19]
exports/review/engineering-closure-20260909/01_STEP/PPR-ASSEMBLY-REVIEW.step
470.0 x 700.0 x 930.0 mm
