kotori0919/PLA-PET-Recycling-Lab/exports/final/drive_ggm_v08/GGM-FULL-ASM.step

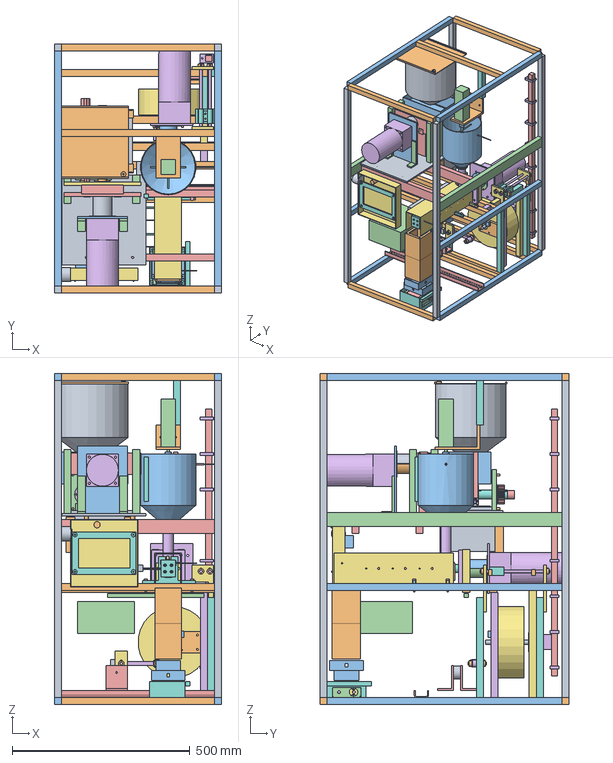
[picture p19: CAD file, 2026-10-19]
exports/final/drive_ggm_v08/GGM-FULL-ASM.step
470.0 x 700.0 x 930.0 mm
