kotori0919/PLA-PET-Recycling-Lab/exports/final/drive_ggm_v08/GGM-DRIVE-ASM.step

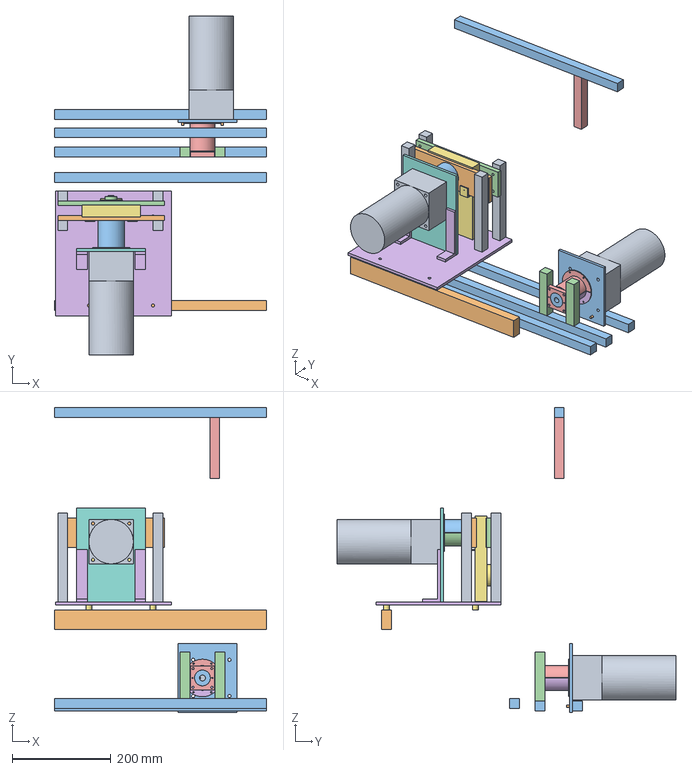
[picture p20: CAD file, 2026-10-19]
exports/final/drive_ggm_v08/GGM-DRIVE-ASM.step
430.0 x 686.0 x 618.0 mm
