kotori0919/PLA-PET-Recycling-Lab/analysis/final_validation/results/v0.8/phase_gear_candidates/DRV-03-R-MATCHED-CANDIDATE.step

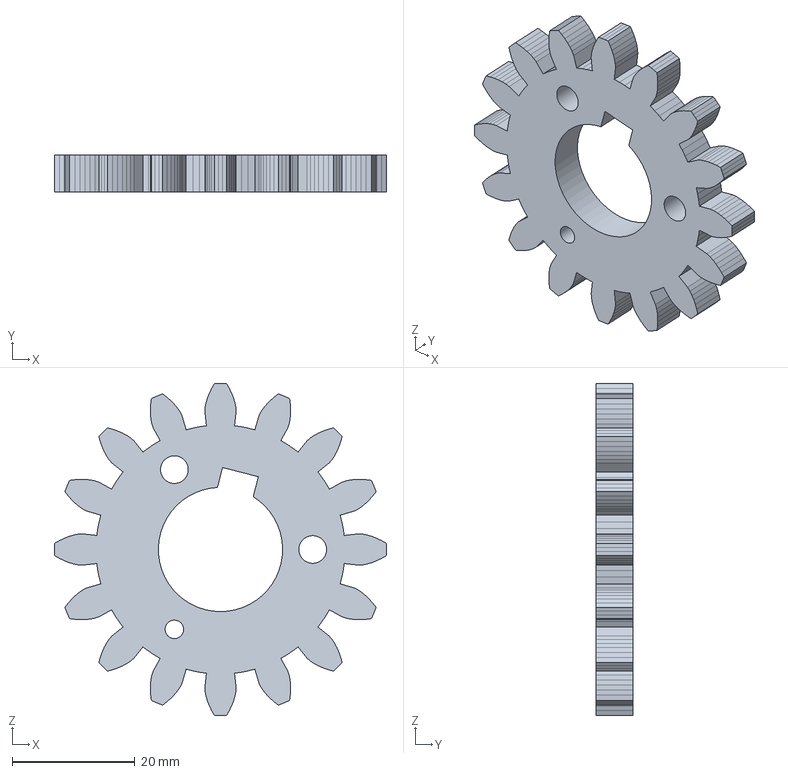
[picture p21: CAD file, 2026-10-19]
analysis/final_validation/results/v0.8/phase_gear_candidates/DRV-03-R-MATCHED-CANDIDATE.step
54.0 x 6.00 x 54.0 mm
