kotori0919/PLA-PET-Recycling-Lab/analysis/final_validation/results/v0.8/shield_service_cover_376_candidate.step

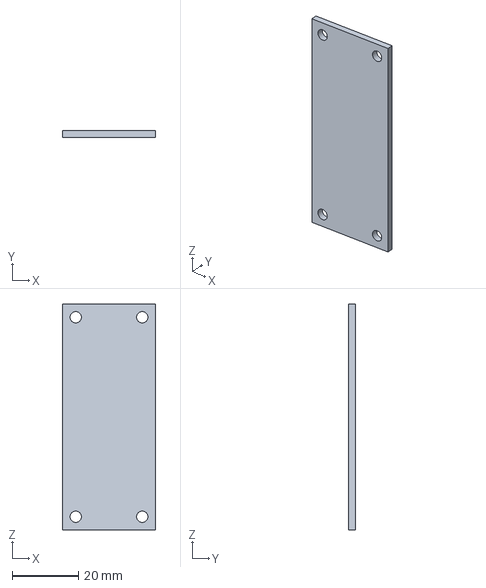
[picture p22: CAD file, 2026-10-19]
analysis/final_validation/results/v0.8/shield_service_cover_376_candidate.step
28.0 x 2.00 x 68.0 mm
