kotori0919/PLA-PET-Recycling-Lab/exports/final/drive_ggm_v08/GGM_SH_BearingCap283.step

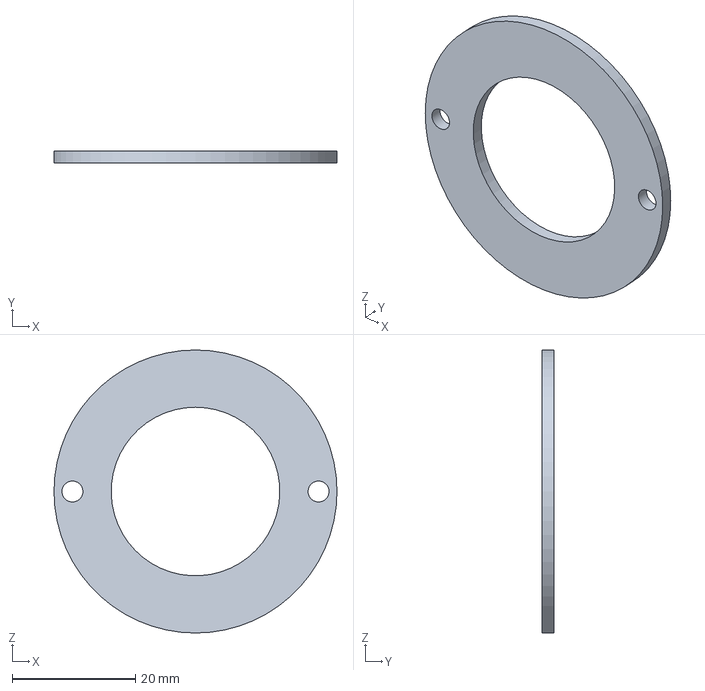
[picture p23: CAD file, 2026-10-19]
exports/final/drive_ggm_v08/GGM_SH_BearingCap283.step
46.0 x 2.00 x 46.0 mm
