kotori0919/PLA-PET-Recycling-Lab/exports/final/frame_v08/FR-TIE-01.step

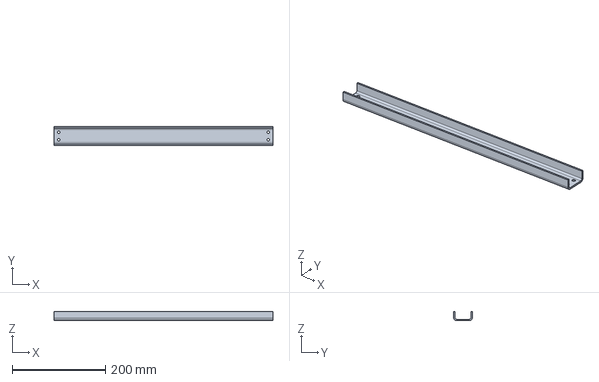
[picture p24: CAD file, 2026-10-19]
exports/final/frame_v08/FR-TIE-01.step
470.0 x 40.0 x 20.0 mm
