kotori0919/PLA-PET-Recycling-Lab/exports/fusion_validation/geometry/spooler_support.step

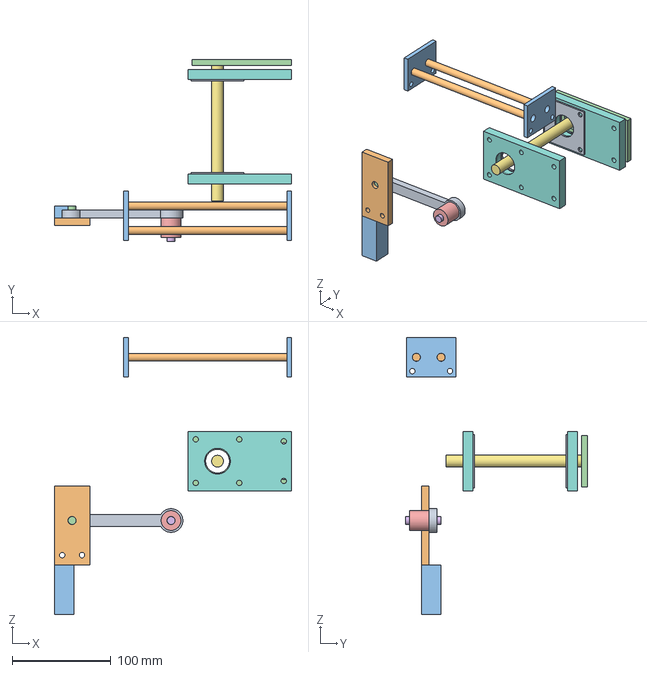
[picture p25: CAD file, 2026-10-19]
exports/fusion_validation/geometry/spooler_support.step
240.0 x 184.0 x 280.0 mm
