kotori0919/PLA-PET-Recycling-Lab/exports/print/coupons/PPR-TC01/PPR-TC01_plate.3mf

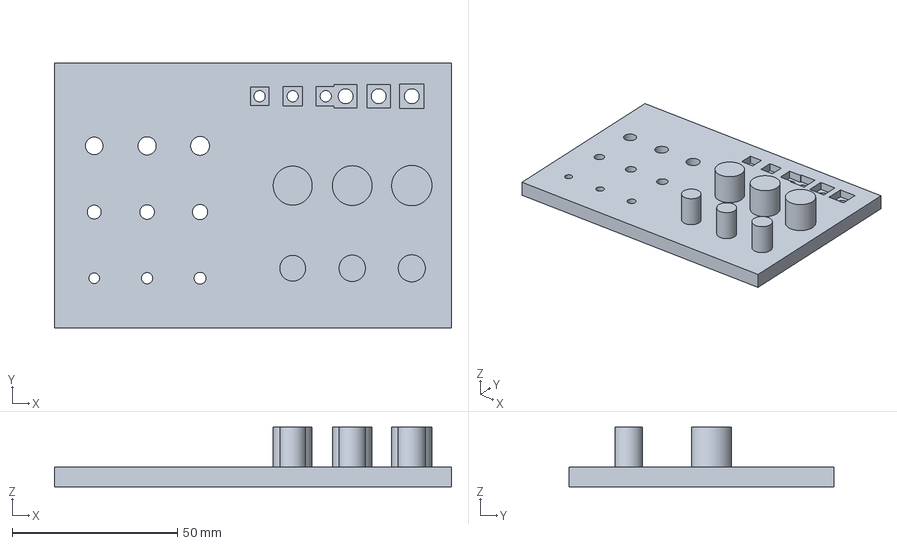
[picture p26: CAD file, 2026-10-19]
exports/print/coupons/PPR-TC01/PPR-TC01_plate.3mf
120.0 x 80.0 x 18.0 mm
