kotori0919/PLA-PET-Recycling-Lab/exports/print/plate_layouts/plate-06-PPR-C06.3mf

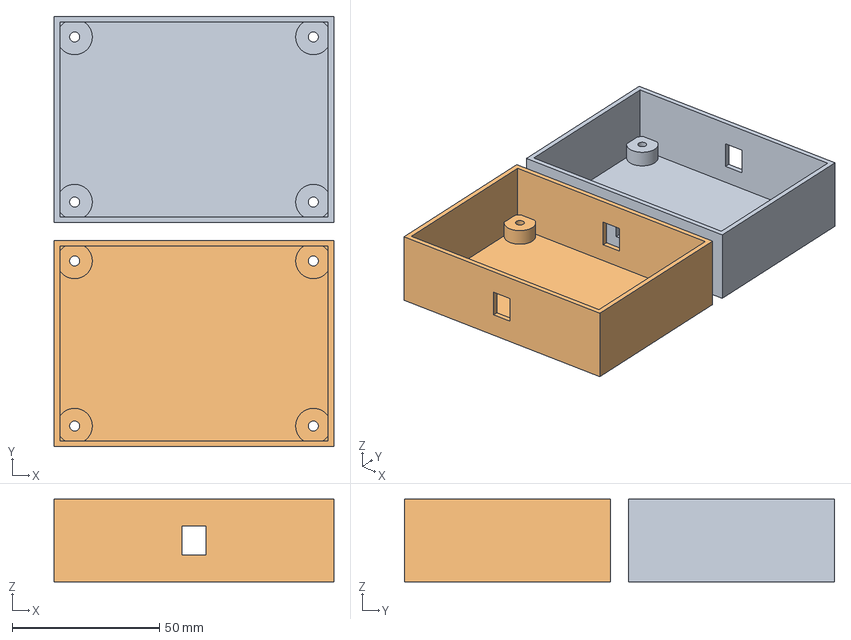
[picture p27: CAD file, 2026-10-19]
exports/print/plate_layouts/plate-06-PPR-C06.3mf
95.0 x 146.0 x 28.0 mm
