kotori0919/PLA-PET-Recycling-Lab/exports/print/PPR-C01/PPR-C01.step

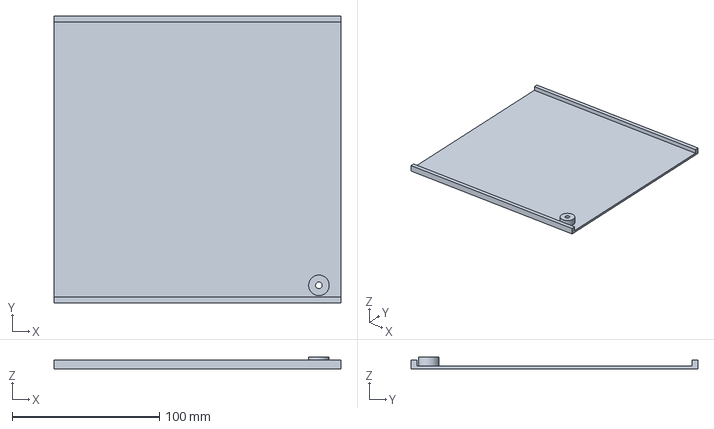
[picture p28: CAD file, 2026-10-19]
exports/print/PPR-C01/PPR-C01.step
195.0 x 195.0 x 8.00 mm
