kotori0919/PLA-PET-Recycling-Lab/exports/print/PPR-C02/PPR-C02.step

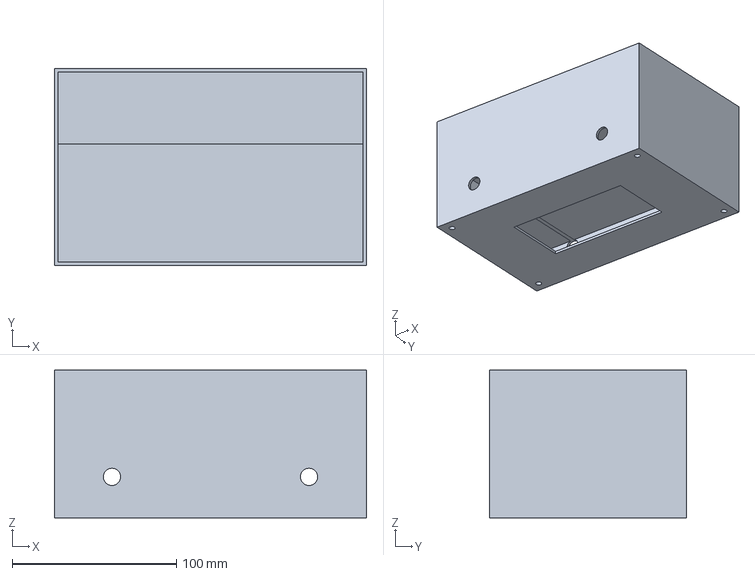
[picture p29: CAD file, 2026-10-19]
exports/print/PPR-C02/PPR-C02.step
190.0 x 120.0 x 90.0 mm
