kotori0919/PLA-PET-Recycling-Lab/exports/print/PPR-C05/PPR-C05.FCStd

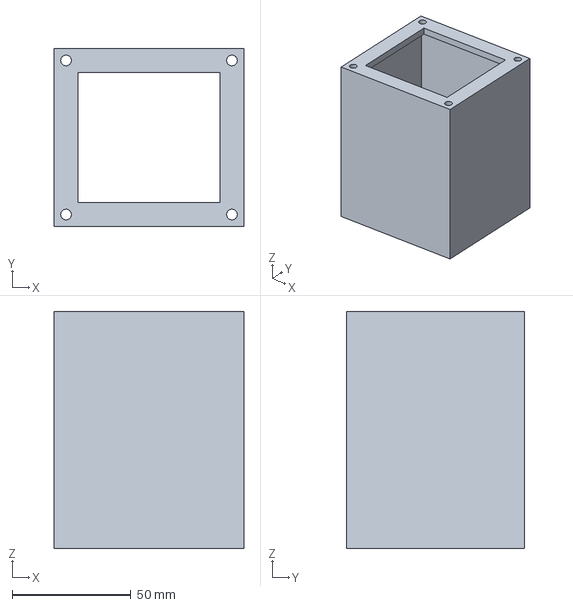
[picture p30: CAD file, 2026-10-19]
exports/print/PPR-C05/PPR-C05.FCStd
80.0 x 75.0 x 100.0 mm
