kotori0919/PLA-PET-Recycling-Lab/exports/print/PPR-C06/PPR-C06.step

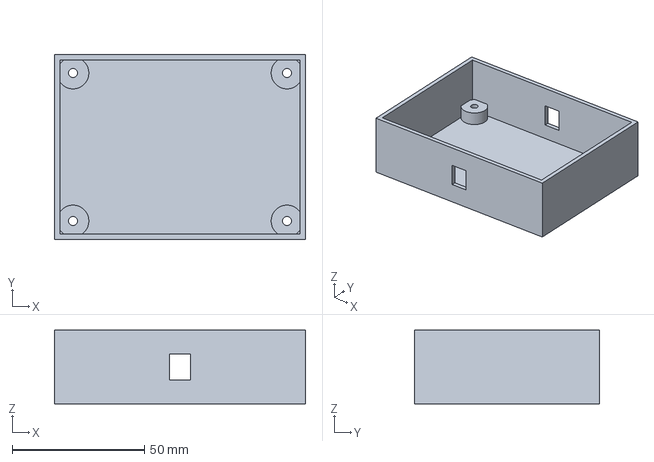
[picture p31: CAD file, 2026-10-19]
exports/print/PPR-C06/PPR-C06.step
95.0 x 70.0 x 28.0 mm
