kotori0919/PLA-PET-Recycling-Lab/exports/print/PPR-C11/PPR-C11.step

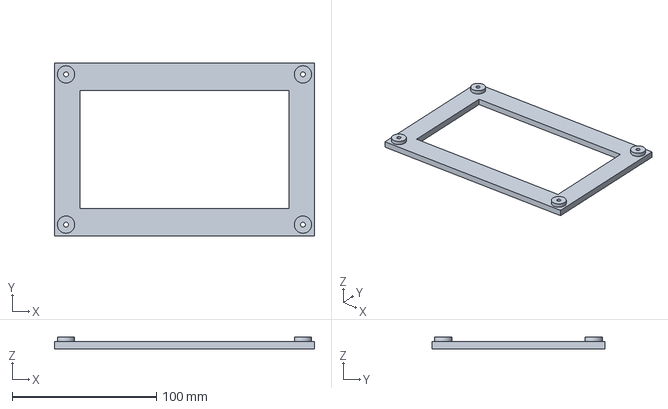
[picture p32: CAD file, 2026-10-19]
exports/print/PPR-C11/PPR-C11.step
180.0 x 120.0 x 8.00 mm
