kotori0919/PLA-PET-Recycling-Lab/exports/review/compact_layout_v08/fixed_foot/SHELF-after.step

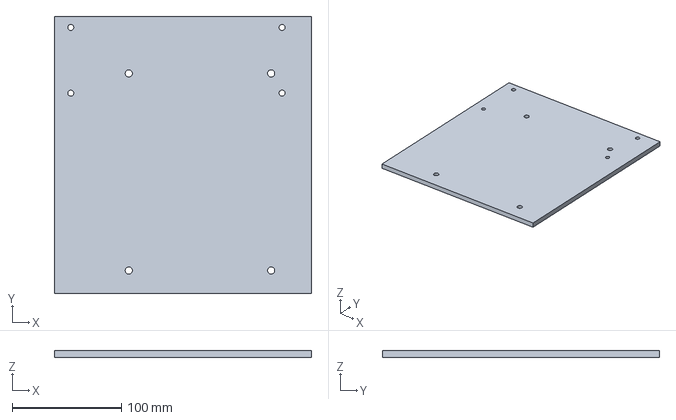
[picture p33: CAD file, 2026-10-19]
exports/review/compact_layout_v08/fixed_foot/SHELF-after.step
235.0 x 253.0 x 6.00 mm
