kotori0919/PLA-PET-Recycling-Lab/exports/review/engineering-closure-20260909/01_STEP/ExtruderFixedCollar.step

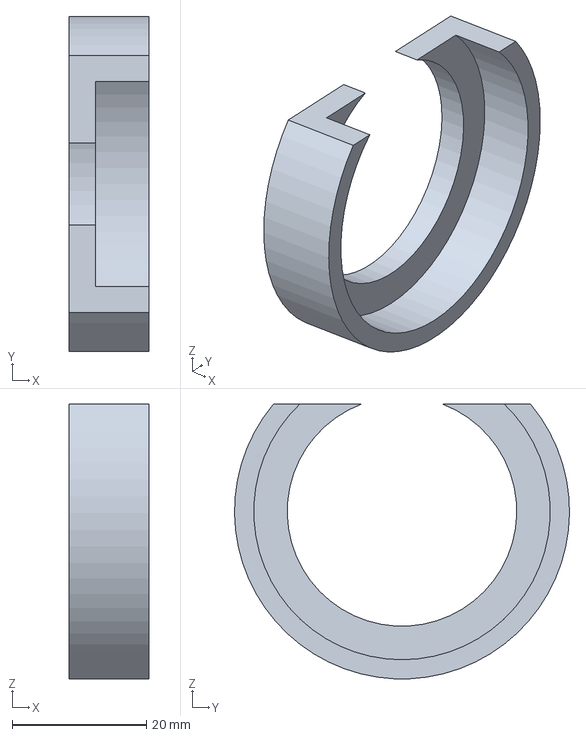
[picture p34: CAD file, 2026-10-19]
exports/review/engineering-closure-20260909/01_STEP/ExtruderFixedCollar.step
12.0 x 50.0 x 41.0 mm
