kotori0919/PLA-PET-Recycling-Lab/exports/review/engineering-closure-20260909/02_DRAWINGS/CUT-05R.dxf

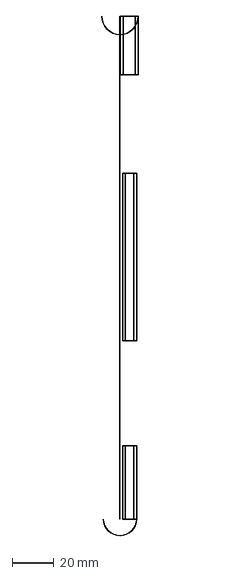
[picture p35: CAD file, 2026-10-19]
exports/review/engineering-closure-20260909/02_DRAWINGS/CUT-05R.dxf
17.5 x 248.0 mm
