kotori0919/PLA-PET-Recycling-Lab/exports/review/engineering-closure-20260909/05_SOURCE/analysis/final_validation/input/bearing_plate.step

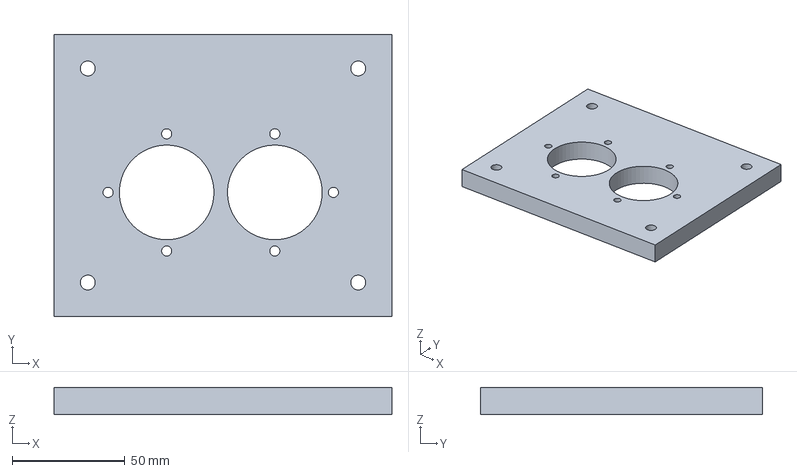
[picture p36: CAD file, 2026-10-19]
exports/review/engineering-closure-20260909/05_SOURCE/analysis/final_validation/input/bearing_plate.step
150.0 x 125.0 x 12.0 mm
