kotori0919/PLA-PET-Recycling-Lab/analysis/final_validation/results/v0.8/die_pilot_candidate_die.step

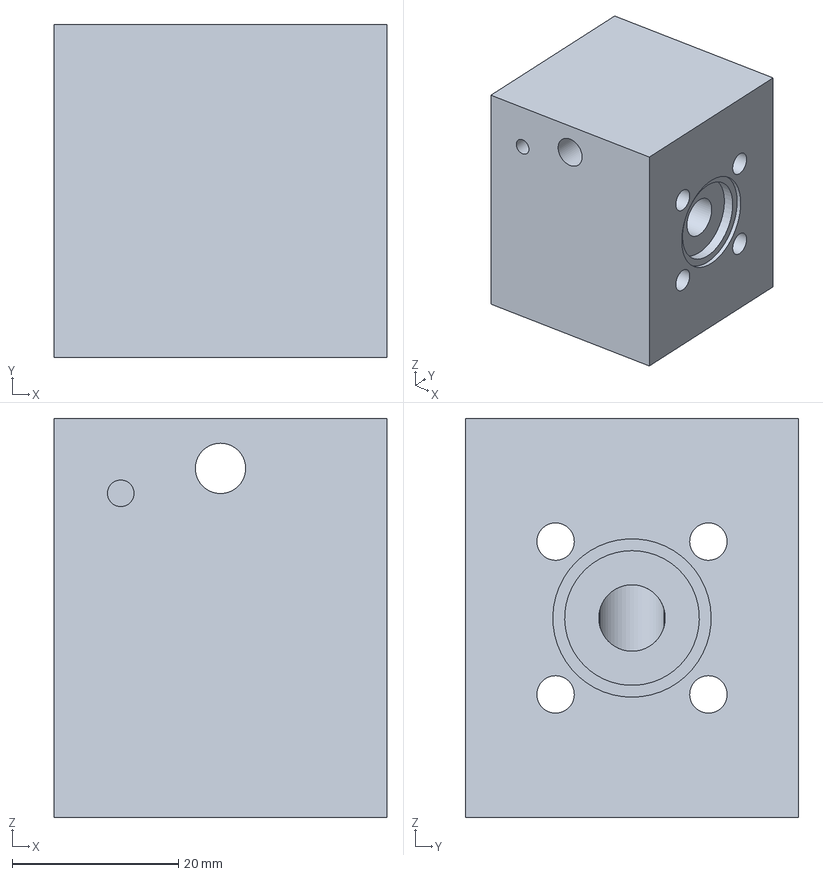
[picture p37: CAD file, 2026-10-19]
analysis/final_validation/results/v0.8/die_pilot_candidate_die.step
40.0 x 40.0 x 48.0 mm
