kotori0919/PLA-PET-Recycling-Lab/exports/final/drive_ggm_v08/GGM_SH_JackInputKey.step

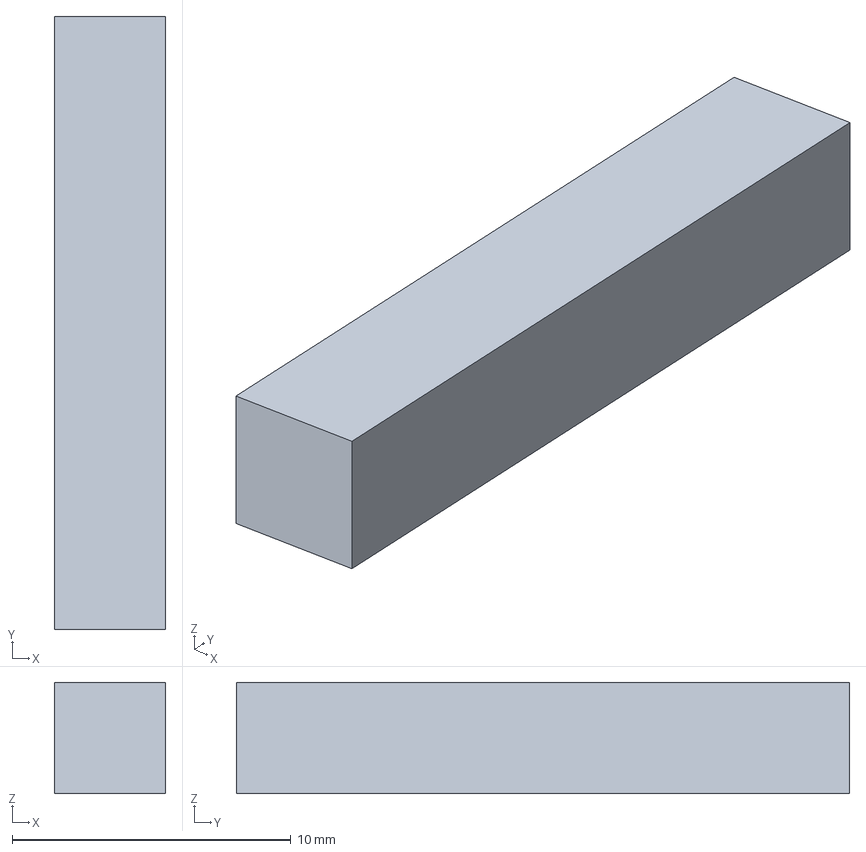
[picture p38: CAD file, 2026-10-19]
exports/final/drive_ggm_v08/GGM_SH_JackInputKey.step
4.00 x 22.0 x 4.00 mm
