kotori0919/PLA-PET-Recycling-Lab/exports/fusion_validation/geometry/cutter_shaft.step

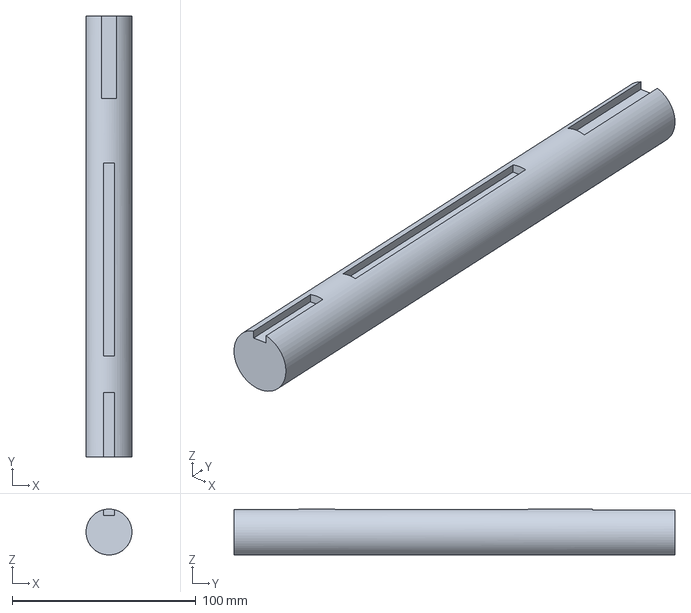
[picture p39: CAD file, 2026-10-19]
exports/fusion_validation/geometry/cutter_shaft.step
25.0 x 240.0 x 25.0 mm
