kotori0919/PLA-PET-Recycling-Lab/exports/review/engineering-closure-20260909/02_DRAWINGS/CUT-05.dxf

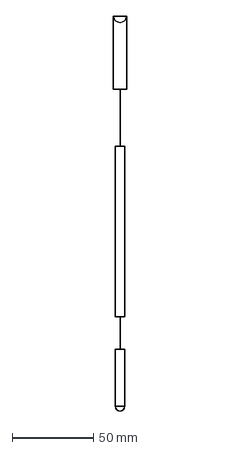
[picture p40: CAD file, 2026-10-19]
exports/review/engineering-closure-20260909/02_DRAWINGS/CUT-05.dxf
8.00 x 243.0 mm
