kotori0919/PLA-PET-Recycling-Lab/analysis/final_validation/results/v0.8/die_pilot_L0p9_candidate_breaker.step

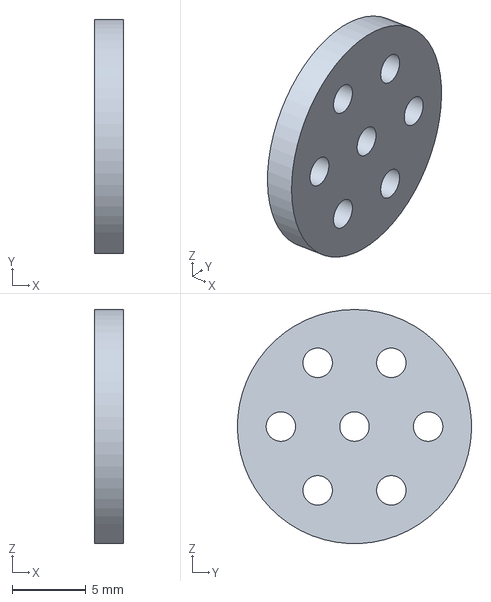
[picture p41: CAD file, 2026-10-19]
analysis/final_validation/results/v0.8/die_pilot_L0p9_candidate_breaker.step
2.00 x 15.9 x 15.9 mm
