kotori0919/PLA-PET-Recycling-Lab/exports/fusion_validation/geometry/shredder_frame.step

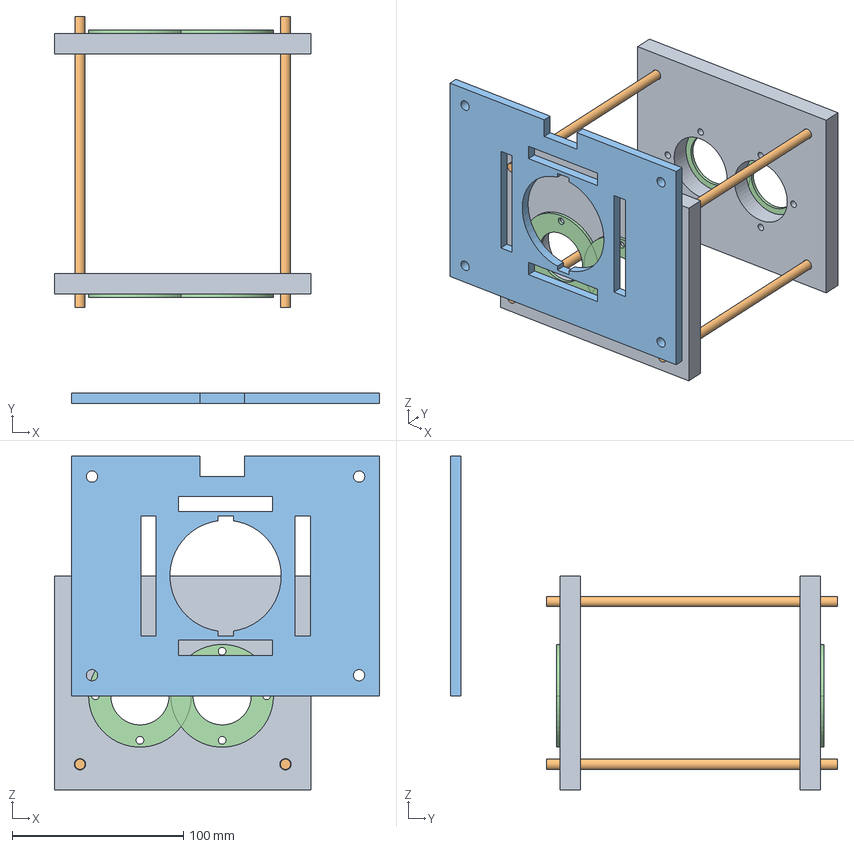
[picture p42: CAD file, 2026-10-19]
exports/fusion_validation/geometry/shredder_frame.step
190.0 x 226.0 x 195.0 mm
