kotori0919/PLA-PET-Recycling-Lab/exports/review/engineering-closure-20260909/01_STEP/ExtruderRearFixedDatum.step

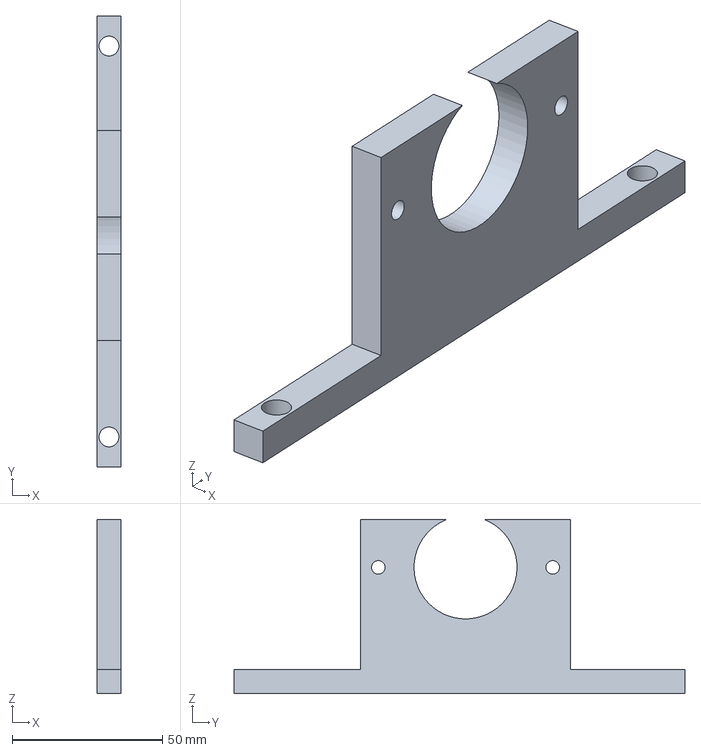
[picture p43: CAD file, 2026-10-19]
exports/review/engineering-closure-20260909/01_STEP/ExtruderRearFixedDatum.step
8.00 x 150.0 x 58.0 mm
