kotori0919/PLA-PET-Recycling-Lab/exports/review/engineering-closure-20260909/05_SOURCE/analysis/final_validation/input/extruder_barrel.step

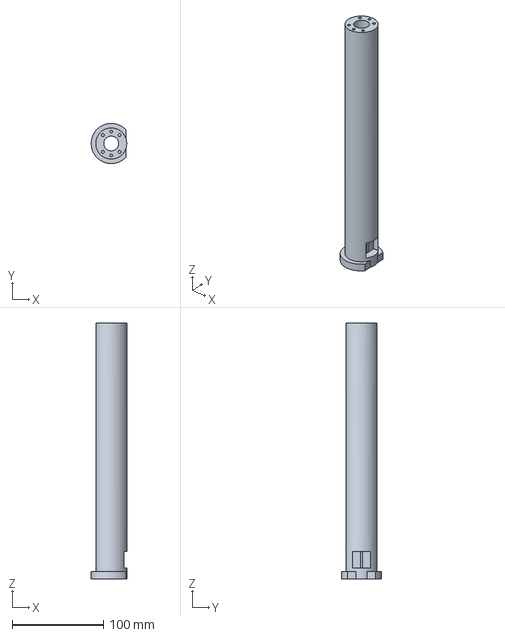
[picture p44: CAD file, 2026-10-19]
exports/review/engineering-closure-20260909/05_SOURCE/analysis/final_validation/input/extruder_barrel.step
39.0 x 44.0 x 280.0 mm
