kotori0919/PLA-PET-Recycling-Lab/exports/fusion_validation/geometry/die.step

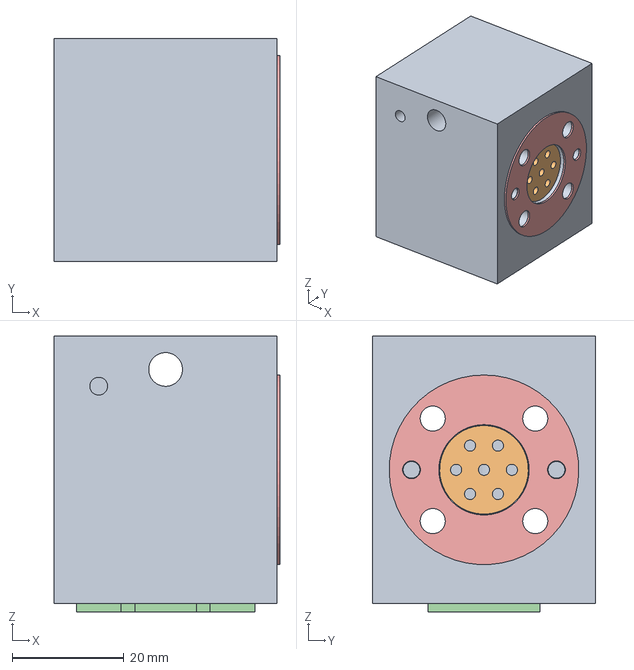
[picture p45: CAD file, 2026-10-19]
exports/fusion_validation/geometry/die.step
40.5 x 40.0 x 49.5 mm
