kotori0919/PLA-PET-Recycling-Lab/exports/print/plate_layouts/plate-03-PPR-C03.3mf

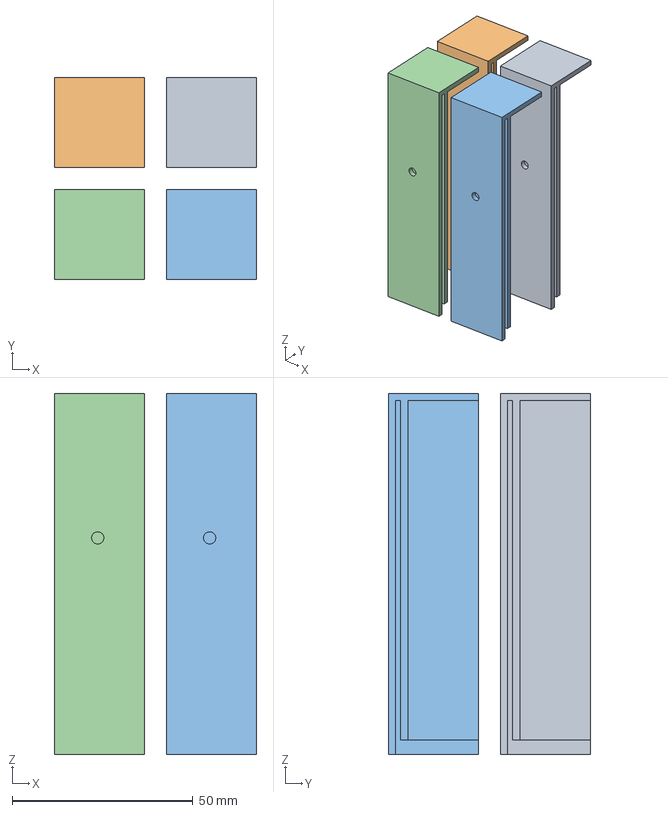
[picture p46: CAD file, 2026-10-19]
exports/print/plate_layouts/plate-03-PPR-C03.3mf
56.0 x 56.0 x 100.0 mm
