kotori0919/PLA-PET-Recycling-Lab/exports/fusion_validation/geometry/extruder_hot_zone.step

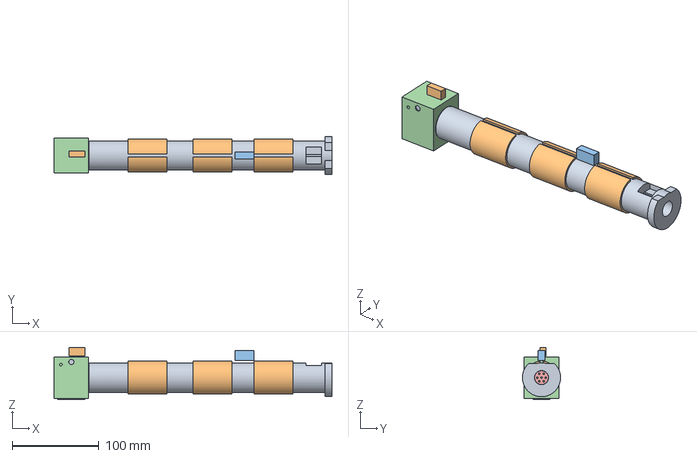
[picture p47: CAD file, 2026-10-19]
exports/fusion_validation/geometry/extruder_hot_zone.step
320.5 x 44.0 x 60.5 mm
