kotori0919/PLA-PET-Recycling-Lab/exports/print/plate_layouts/plate-10-PPR-C10.3mf

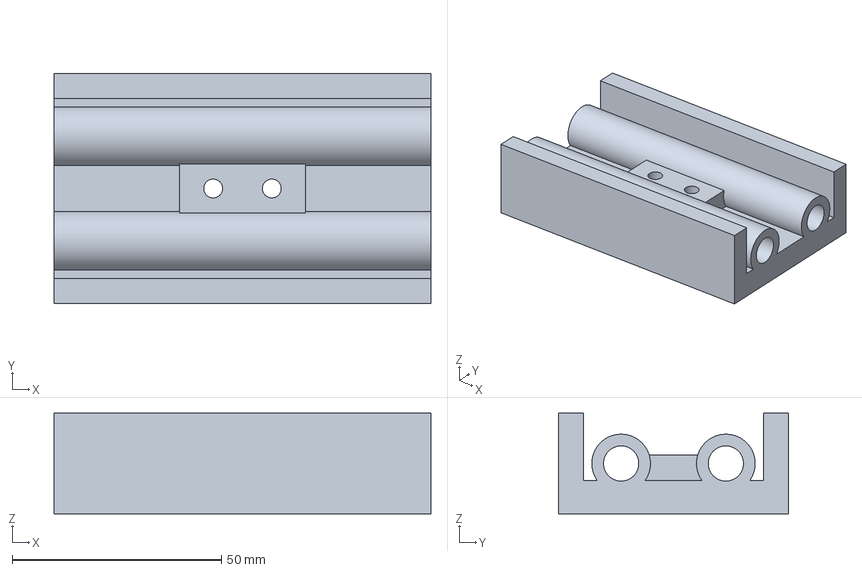
[picture p48: CAD file, 2026-10-19]
exports/print/plate_layouts/plate-10-PPR-C10.3mf
90.0 x 55.0 x 24.0 mm
