kotori0919/PLA-PET-Recycling-Lab/exports/review/engineering-closure-20260909/01_STEP/ExtruderRearRetainer.step

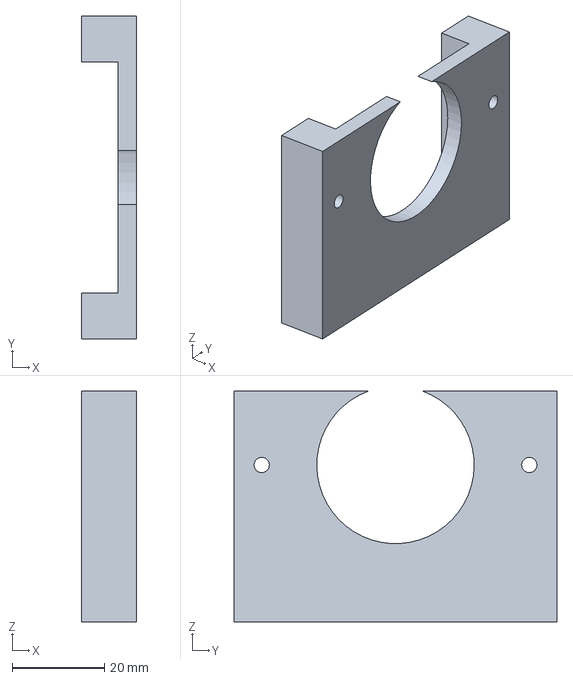
[picture p49: CAD file, 2026-10-19]
exports/review/engineering-closure-20260909/01_STEP/ExtruderRearRetainer.step
12.0 x 70.0 x 50.0 mm
