kotori0919/PLA-PET-Recycling-Lab/analysis/final_validation/results/v0.8/shield_service_window_candidate.step

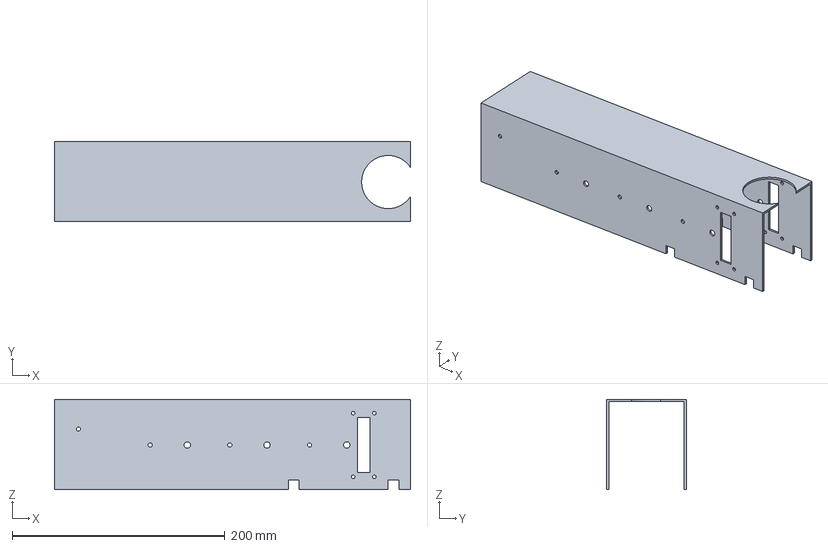
[picture p50: CAD file, 2026-10-19]
analysis/final_validation/results/v0.8/shield_service_window_candidate.step
335.0 x 75.0 x 85.0 mm
