kotori0919/PLA-PET-Recycling-Lab/exports/final/drive_ggm_v08/GGM_SH_Angle83.step

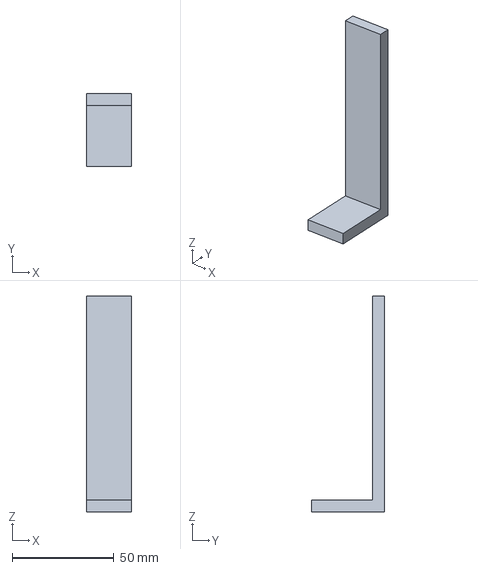
[picture p51: CAD file, 2026-10-19]
exports/final/drive_ggm_v08/GGM_SH_Angle83.step
22.0 x 36.0 x 106.0 mm
