kotori0919/PLA-PET-Recycling-Lab/exports/fusion_validation/geometry/shredder_rotor_support.step

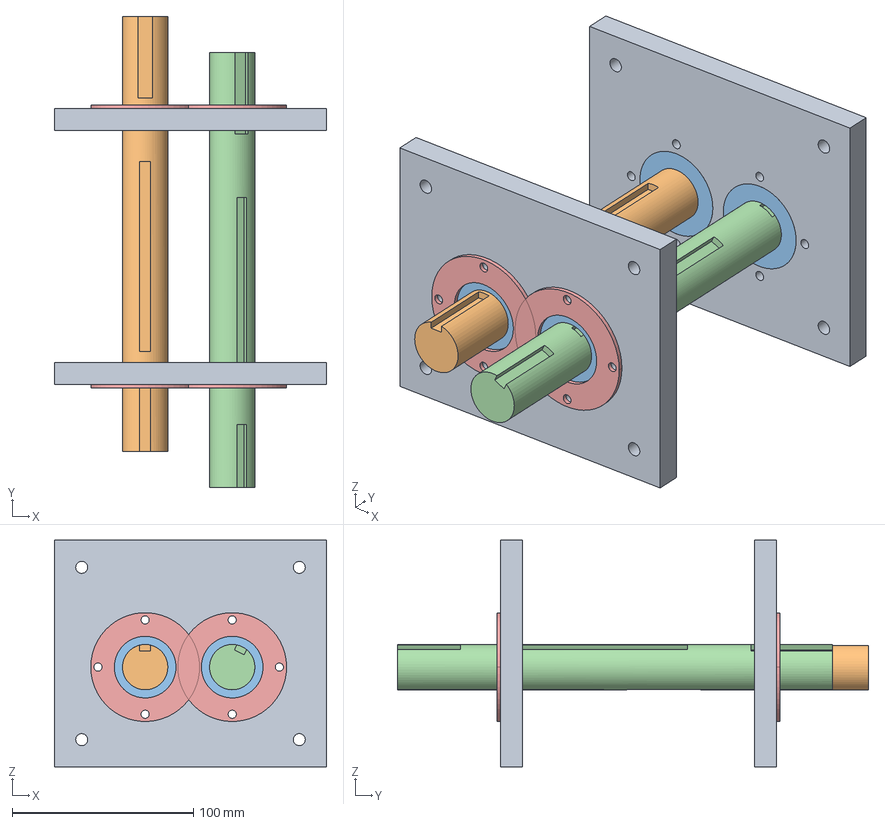
[picture p52: CAD file, 2026-10-19]
exports/fusion_validation/geometry/shredder_rotor_support.step
150.0 x 260.0 x 125.0 mm
