kotori0919/PLA-PET-Recycling-Lab/analysis/final_validation/results/v0.8/die_pilot_L0p9_candidate_gasket.step

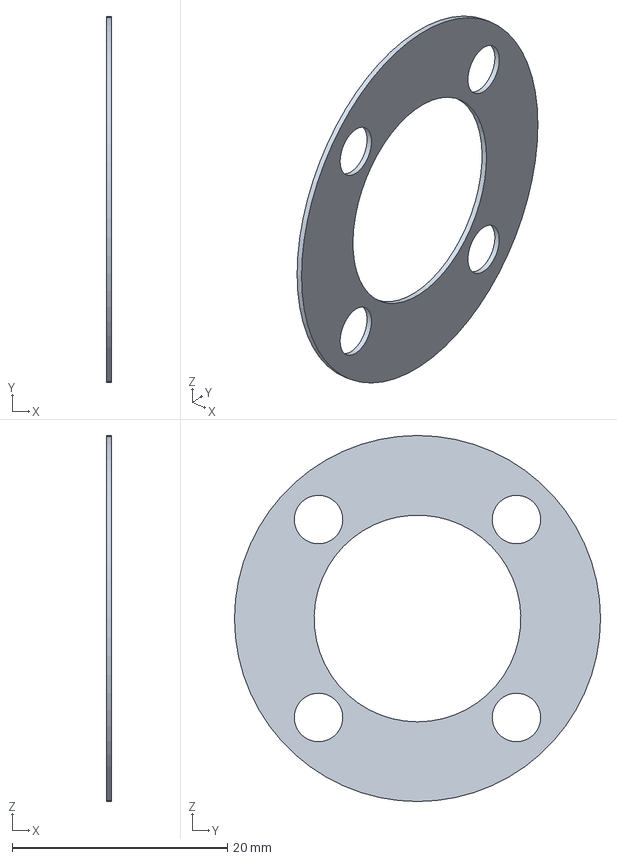
[picture p54: CAD file, 2026-10-19]
analysis/final_validation/results/v0.8/die_pilot_L0p9_candidate_gasket.step
0.5 x 34.0 x 34.0 mm
