kotori0919/PLA-PET-Recycling-Lab/exports/final/drive_ggm_v08/GGM_SH_Spacer_220_100.FCStd

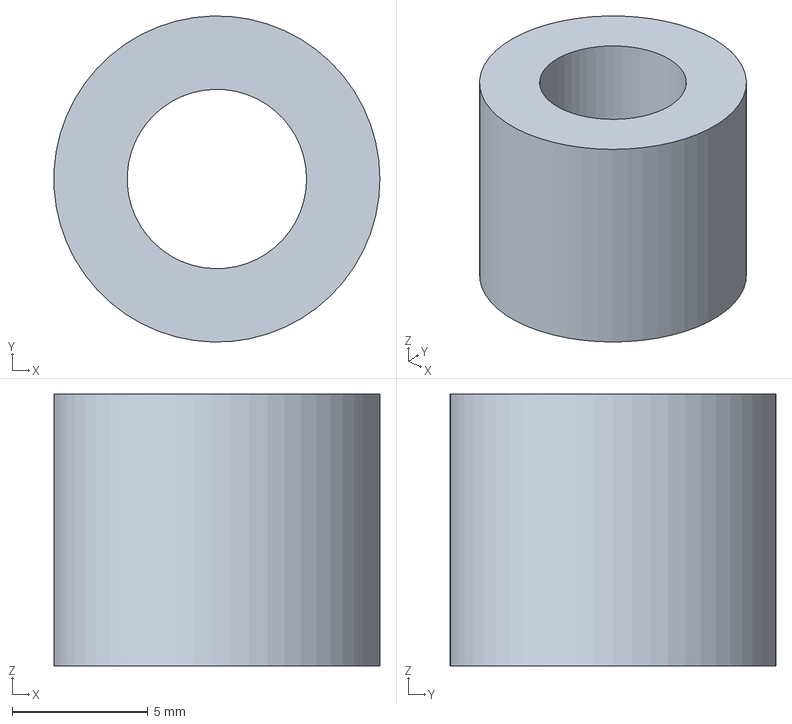
[picture p55: CAD file, 2026-10-19]
exports/final/drive_ggm_v08/GGM_SH_Spacer_220_100.FCStd
12.0 x 12.0 x 10.0 mm
