kotori0919/PLA-PET-Recycling-Lab/exports/print/plate_layouts/plate-05-PPR-C05.3mf

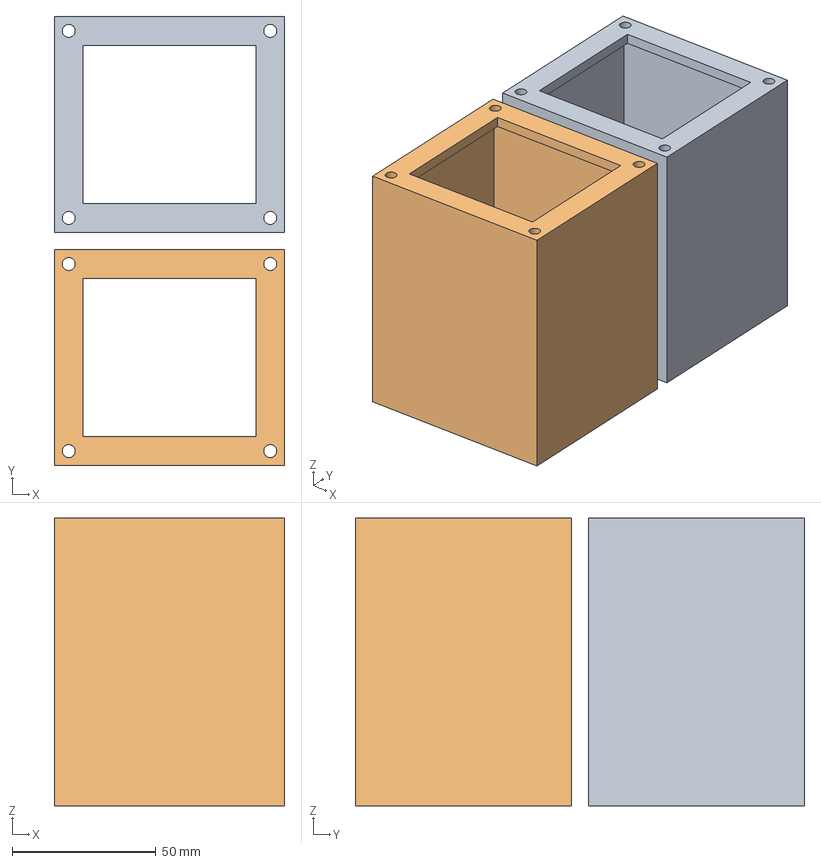
[picture p56: CAD file, 2026-10-19]
exports/print/plate_layouts/plate-05-PPR-C05.3mf
80.0 x 156.0 x 100.0 mm
