kotori0919/PLA-PET-Recycling-Lab/exports/final/drive_ggm_v08/GGM_EX_RadialHolder.FCStd

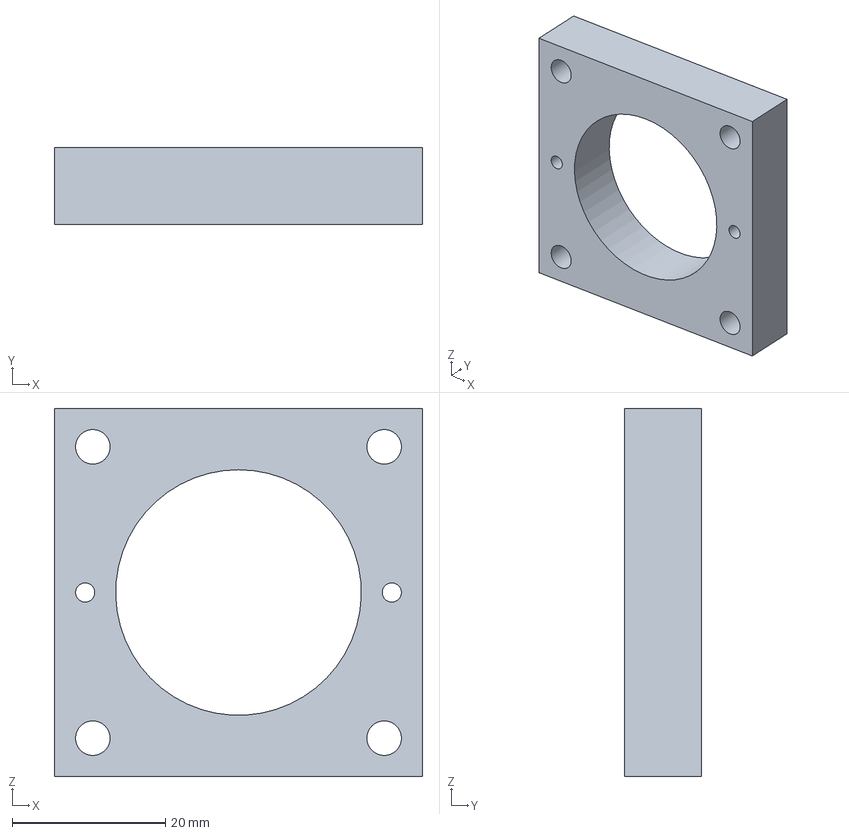
[picture p57: CAD file, 2026-10-19]
exports/final/drive_ggm_v08/GGM_EX_RadialHolder.FCStd
48.0 x 10.0 x 48.0 mm
