kotori0919/PLA-PET-Recycling-Lab/exports/print/plate_layouts/plate-08-PPR-C08.3mf

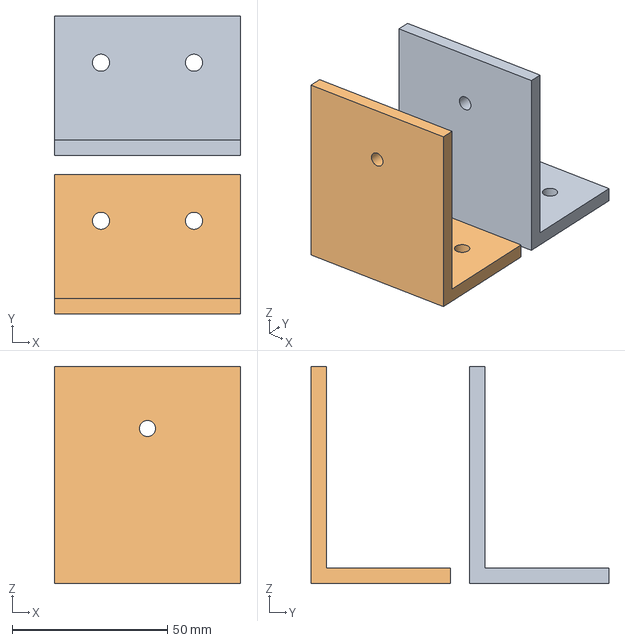
[picture p58: CAD file, 2026-10-19]
exports/print/plate_layouts/plate-08-PPR-C08.3mf
60.0 x 96.0 x 70.0 mm
