kotori0919/PLA-PET-Recycling-Lab/exports/final/drive_ggm_v08/GGM_SH_FuseInput.step

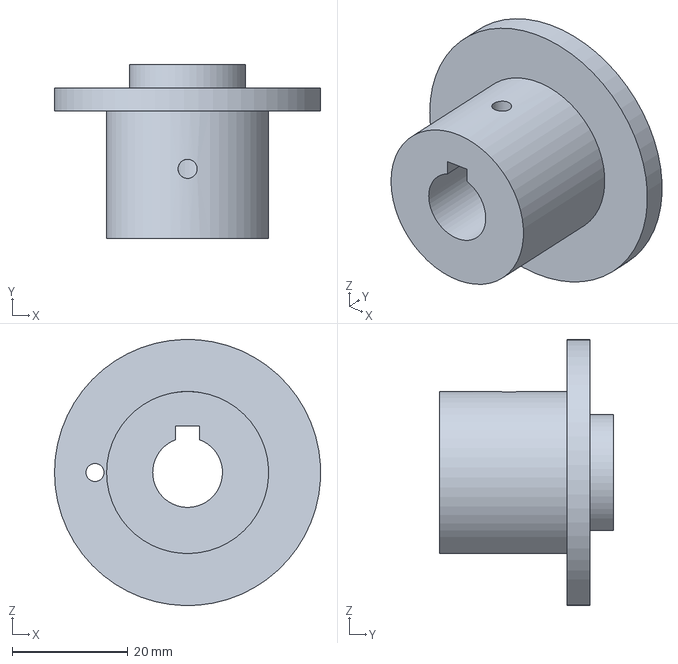
[picture p59: CAD file, 2026-10-19]
exports/final/drive_ggm_v08/GGM_SH_FuseInput.step
46.0 x 30.0 x 46.0 mm
