kotori0919/PLA-PET-Recycling-Lab/exports/print/plate_layouts/plate-09-PPR-C09.3mf

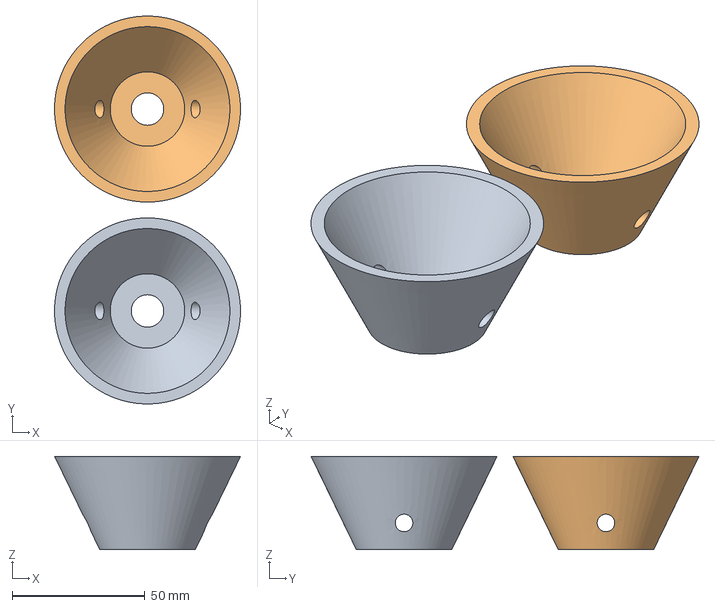
[picture p60: CAD file, 2026-10-19]
exports/print/plate_layouts/plate-09-PPR-C09.3mf
70.0 x 146.0 x 35.0 mm
