kotori0919/PLA-PET-Recycling-Lab/exports/print/plate_layouts/plate-07-PPR-C07.3mf

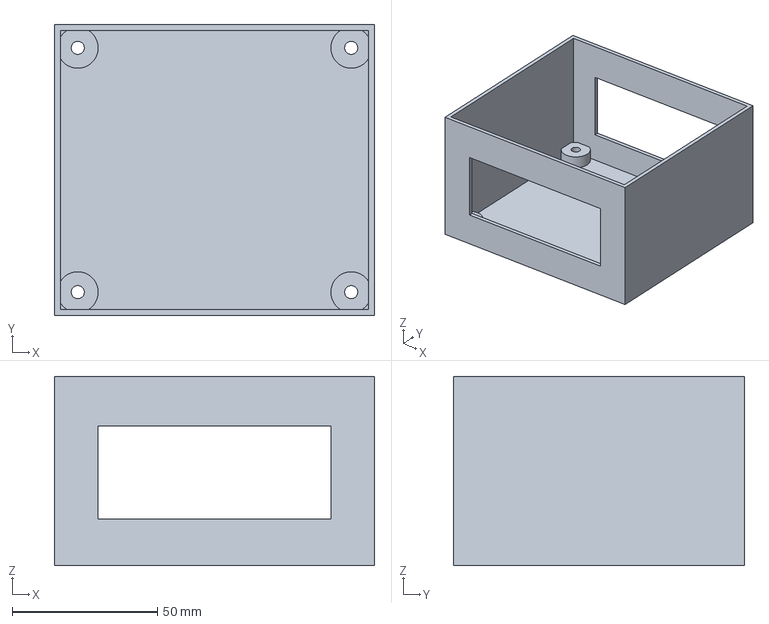
[picture p61: CAD file, 2026-10-19]
exports/print/plate_layouts/plate-07-PPR-C07.3mf
110.0 x 100.0 x 65.0 mm
