kotori0919/PLA-PET-Recycling-Lab/analysis/final_validation/results/v0.8/torsion_load_path_153.step

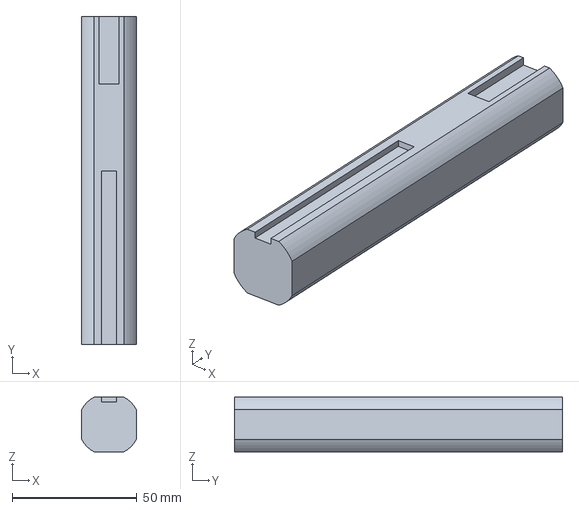
[picture p62: CAD file, 2026-10-19]
analysis/final_validation/results/v0.8/torsion_load_path_153.step
22.0 x 131.5 x 22.0 mm
