kotori0919/PLA-PET-Recycling-Lab/exports/print/plate_layouts/plate-04-PPR-C04.3mf

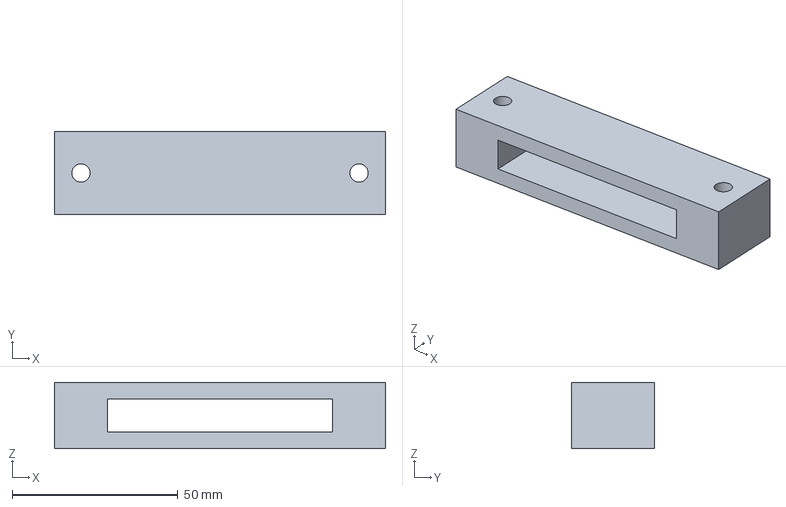
[picture p63: CAD file, 2026-10-19]
exports/print/plate_layouts/plate-04-PPR-C04.3mf
100.0 x 25.0 x 20.0 mm
