kotori0919/PLA-PET-Recycling-Lab/exports/final/drive_ggm_v08/ThrustPlate-GGM.FCStd

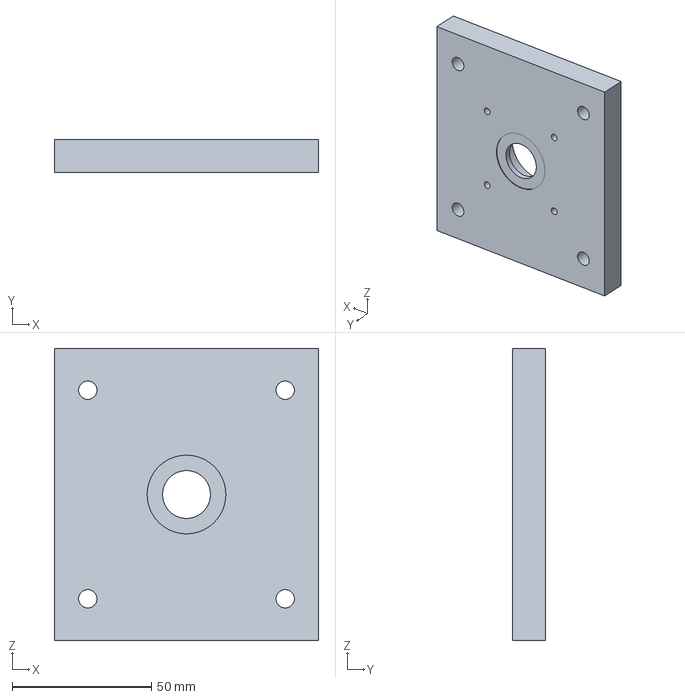
[picture p64: CAD file, 2026-10-19]
exports/final/drive_ggm_v08/ThrustPlate-GGM.FCStd
95.0 x 12.0 x 105.0 mm
