kotori0919/PLA-PET-Recycling-Lab/exports/print/plate_layouts/plate-12-PPR-C12.3mf

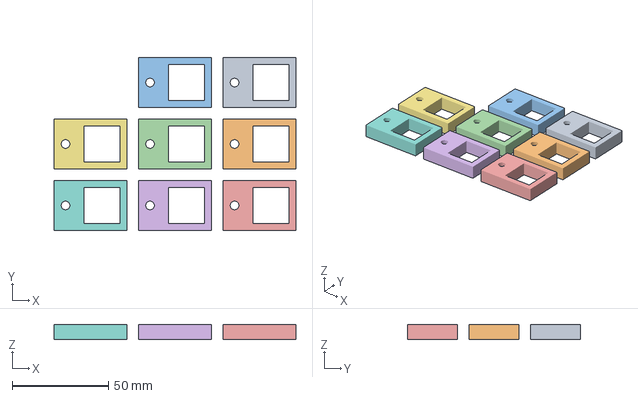
[picture p65: CAD file, 2026-10-19]
exports/print/plate_layouts/plate-12-PPR-C12.3mf
126.0 x 90.0 x 8.00 mm
