kotori0919/PLA-PET-Recycling-Lab/analysis/final_validation/results/v0.8/die_pilot_candidate_barrel.step

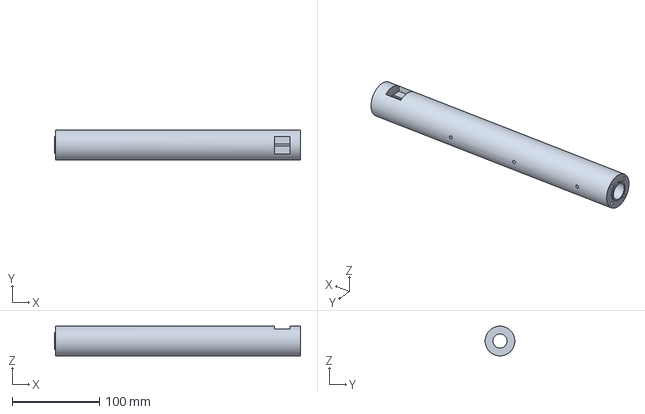
[picture p66: CAD file, 2026-10-19]
analysis/final_validation/results/v0.8/die_pilot_candidate_barrel.step
281.2 x 34.0 x 34.0 mm
