kotori0919/PLA-PET-Recycling-Lab/exports/final/drive_ggm_v08/GGM_SH_MotorKey.step

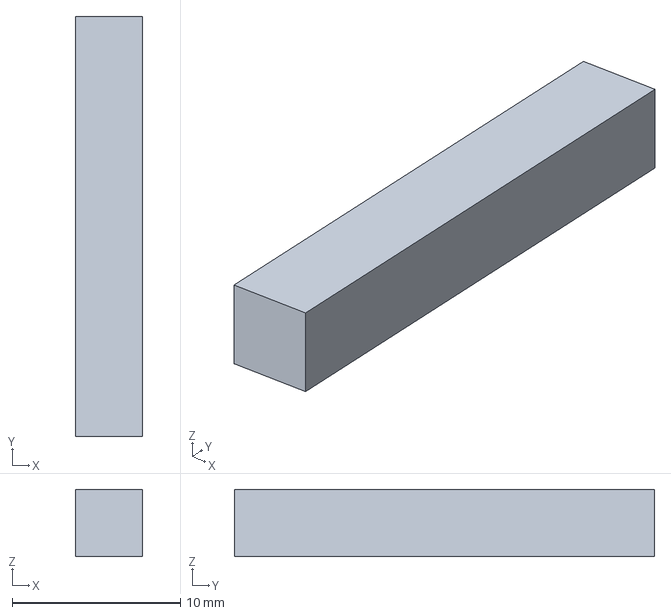
[picture p67: CAD file, 2026-10-19]
exports/final/drive_ggm_v08/GGM_SH_MotorKey.step
4.00 x 25.0 x 4.00 mm
