kotori0919/PLA-PET-Recycling-Lab/analysis/final_validation/results/v0.8/slave_keyseat_R1p5_candidate.step

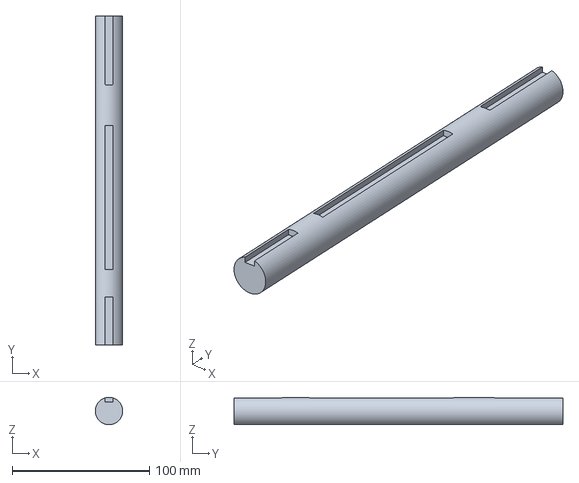
[picture p68: CAD file, 2026-10-19]
analysis/final_validation/results/v0.8/slave_keyseat_R1p5_candidate.step
20.0 x 240.0 x 20.0 mm
