kotori0919/PLA-PET-Recycling-Lab/exports/final/drive_ggm_v08/GGM_EX_Mount.FCStd

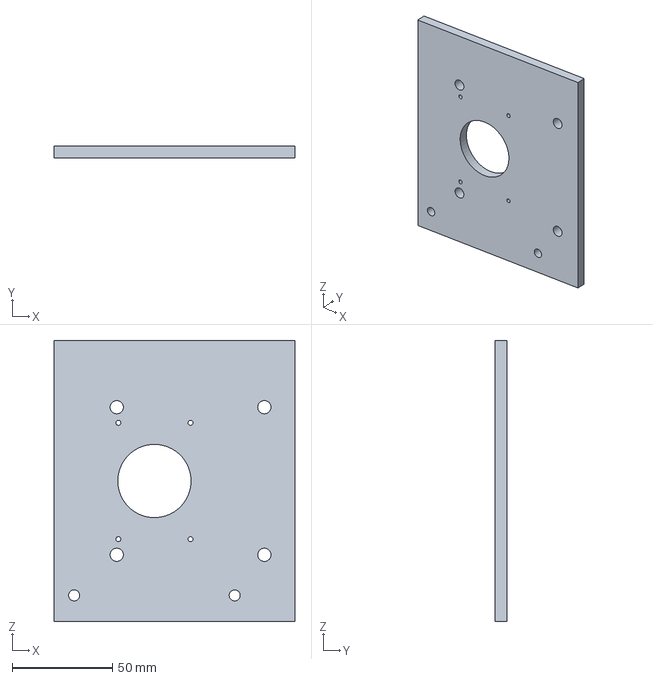
[picture p69: CAD file, 2026-10-19]
exports/final/drive_ggm_v08/GGM_EX_Mount.FCStd
120.0 x 6.00 x 140.0 mm
