kotori0919/PLA-PET-Recycling-Lab/analysis/final_validation/results/v0.8/torsion_load_path_105.step

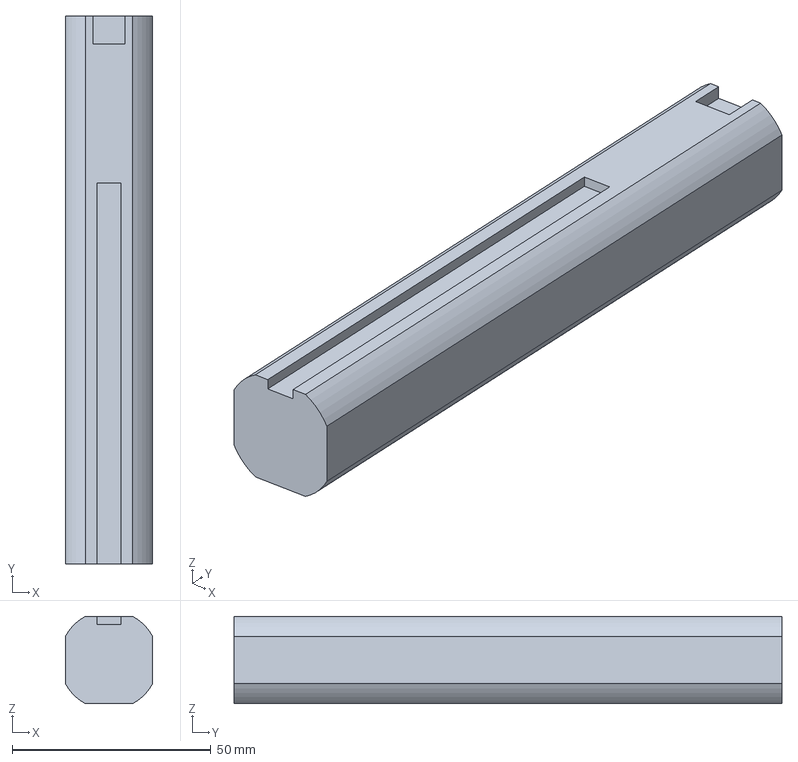
[picture p70: CAD file, 2026-10-19]
analysis/final_validation/results/v0.8/torsion_load_path_105.step
22.0 x 138.0 x 22.0 mm
