kotori0919/PLA-PET-Recycling-Lab/exports/final/drive_ggm_v08/GGM_SH_FuseOutput.step

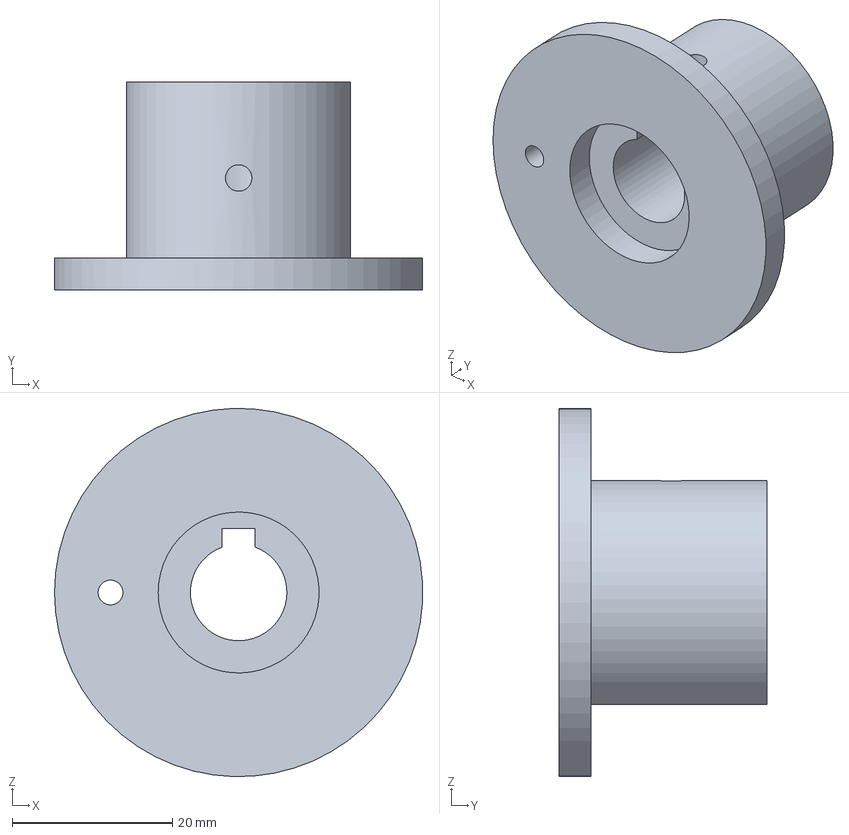
[picture p72: CAD file, 2026-10-19]
exports/final/drive_ggm_v08/GGM_SH_FuseOutput.step
46.0 x 26.0 x 46.0 mm
