kotori0919/PLA-PET-Recycling-Lab/exports/final/drive_ggm_v08/GGM_SH_Mount.step

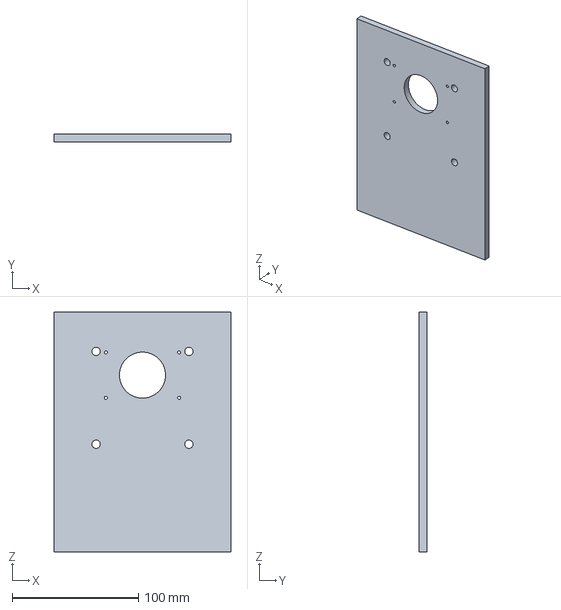
[picture p73: CAD file, 2026-10-19]
exports/final/drive_ggm_v08/GGM_SH_Mount.step
140.0 x 6.00 x 190.2 mm
