kotori0919/PLA-PET-Recycling-Lab/exports/final/drive_ggm_v08/GGM_SH_CouplingGuard.step

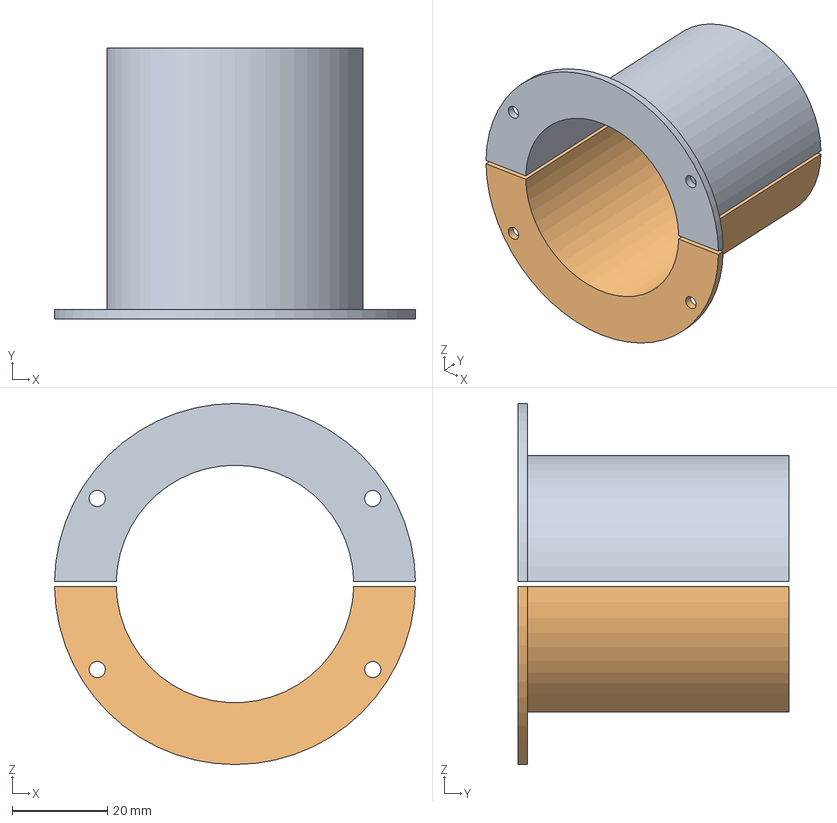
[picture p74: CAD file, 2026-10-19]
exports/final/drive_ggm_v08/GGM_SH_CouplingGuard.step
76.0 x 57.0 x 76.0 mm
