kotori0919/PLA-PET-Recycling-Lab/exports/final/drive_ggm_v08/GGM_JackInnerSpacer_pinionrear.step

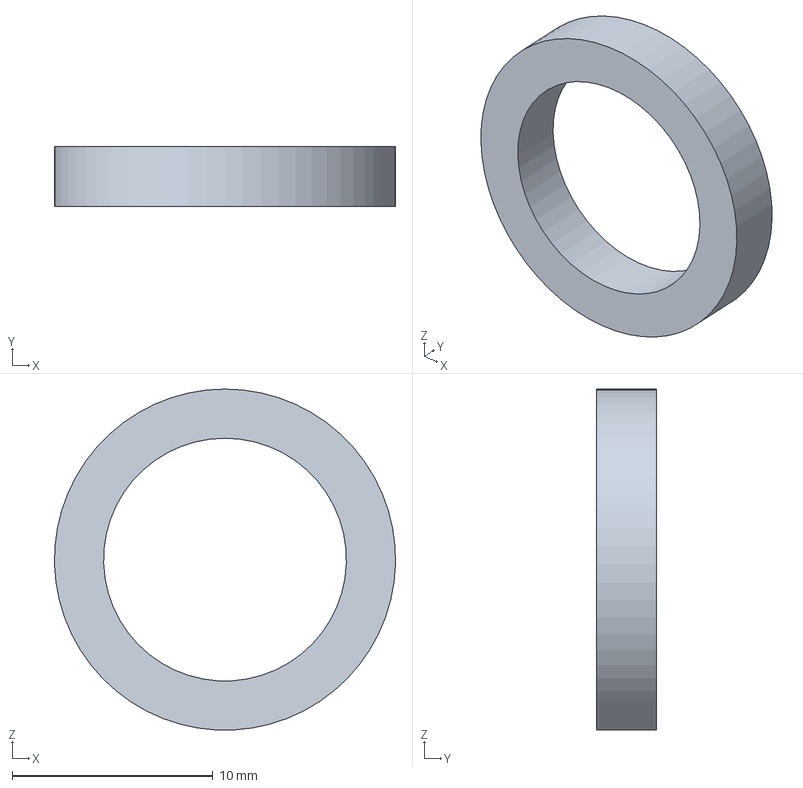
[picture p75: CAD file, 2026-10-19]
exports/final/drive_ggm_v08/GGM_JackInnerSpacer_pinionrear.step
17.0 x 3.00 x 17.0 mm
