kotori0919/PLA-PET-Recycling-Lab/exports/final/drive_ggm_v08/GGM_SH_FusePinBlank.step

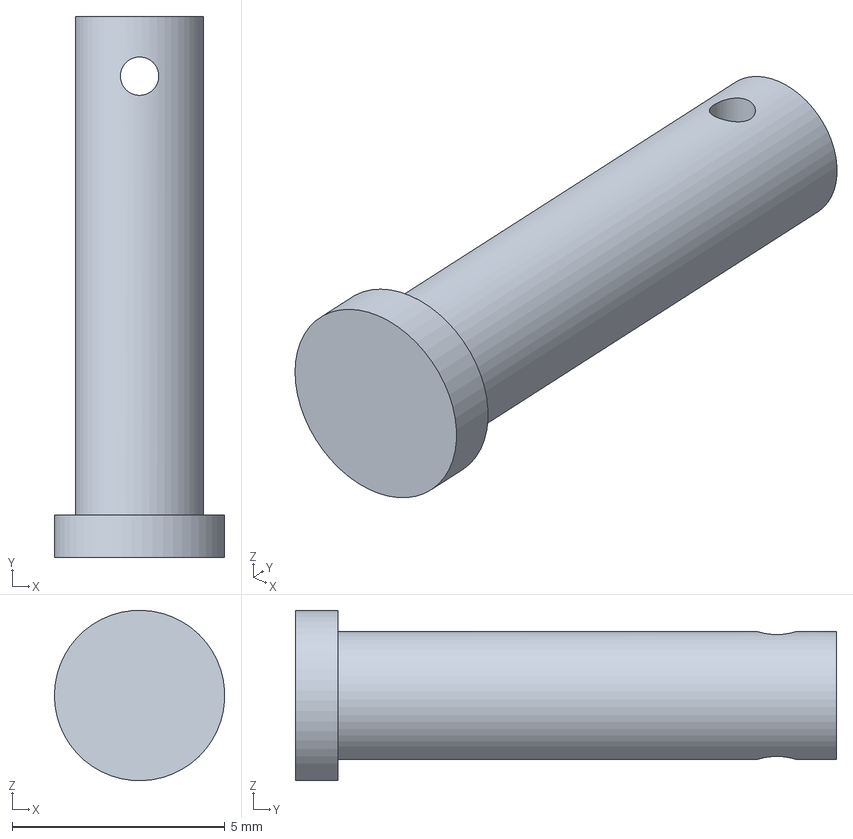
[picture p76: CAD file, 2026-10-19]
exports/final/drive_ggm_v08/GGM_SH_FusePinBlank.step
4.00 x 12.7 x 4.00 mm
