kotori0919/PLA-PET-Recycling-Lab/exports/final/drive_ggm_v08/GGM_SH_BearingPlate303.step

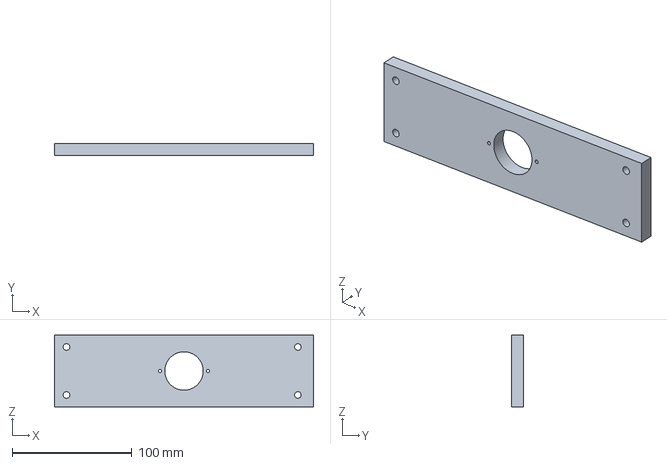
[picture p78: CAD file, 2026-10-19]
exports/final/drive_ggm_v08/GGM_SH_BearingPlate303.step
216.0 x 10.0 x 60.0 mm
