kotori0919/PLA-PET-Recycling-Lab/exports/final/drive_ggm_v08/GGM_SH_Jackshaft.step

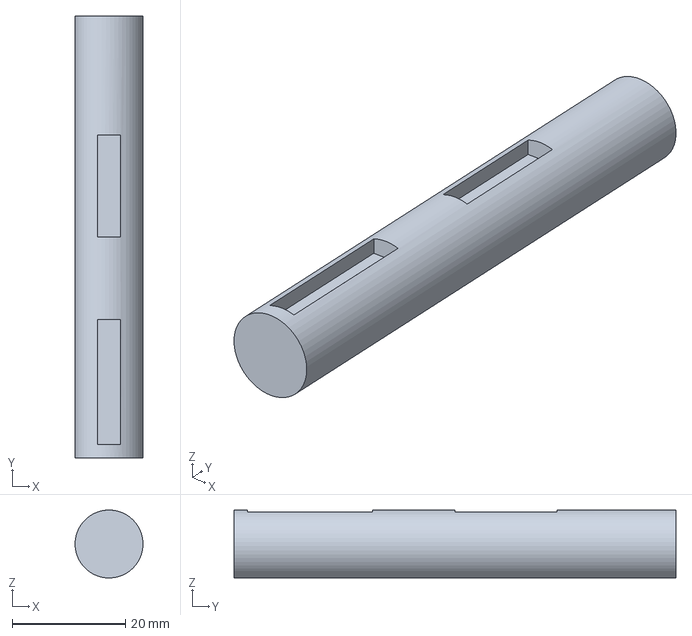
[picture p79: CAD file, 2026-10-19]
exports/final/drive_ggm_v08/GGM_SH_Jackshaft.step
12.0 x 78.0 x 12.0 mm
