kotori0919/PLA-PET-Recycling-Lab/exports/final/drive_ggm_v08/GGM_SH_CutterKey.step

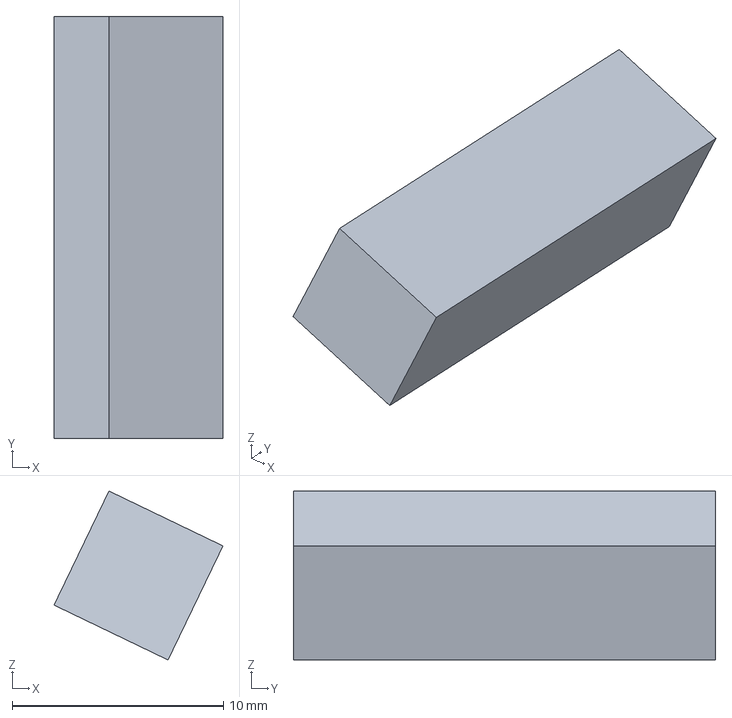
[picture p80: CAD file, 2026-10-19]
exports/final/drive_ggm_v08/GGM_SH_CutterKey.step
8.01 x 20.0 x 8.01 mm
