kotori0919/PLA-PET-Recycling-Lab/exports/final/drive_ggm_v08/GGM_ChainGuard.step

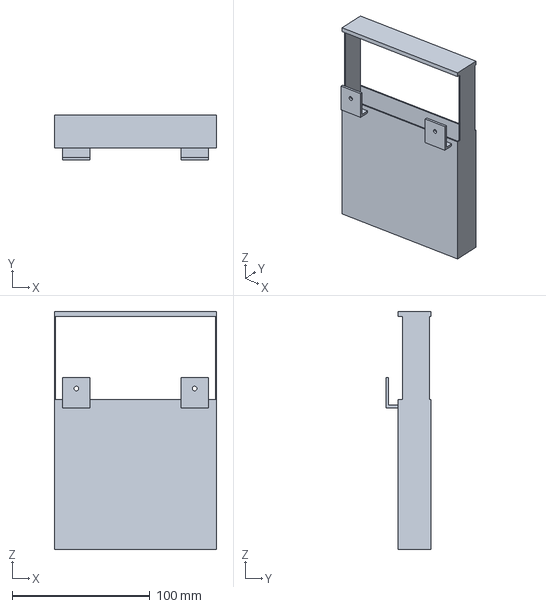
[picture p81: CAD file, 2026-10-19]
exports/final/drive_ggm_v08/GGM_ChainGuard.step
118.0 x 33.0 x 173.0 mm
