kotori0919/PLA-PET-Recycling-Lab/exports/final/drive_ggm_v08/GGM_JackInnerSpacer_pinionfront.step

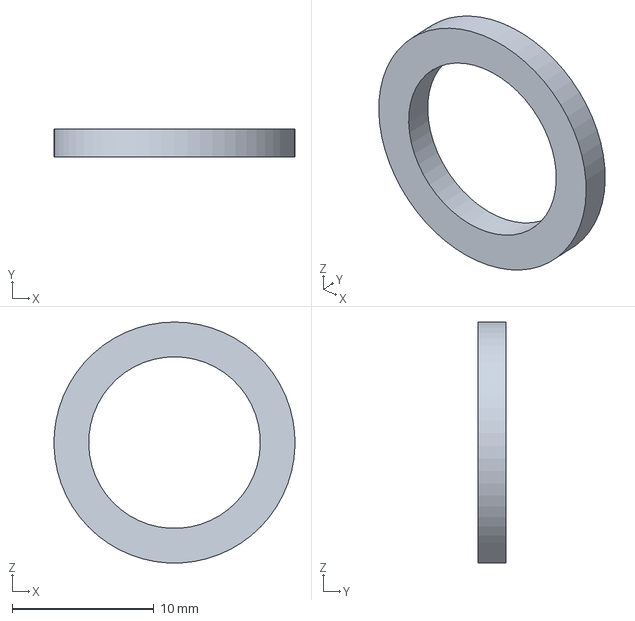
[picture p83: CAD file, 2026-10-19]
exports/final/drive_ggm_v08/GGM_JackInnerSpacer_pinionfront.step
17.0 x 2.00 x 17.0 mm
