kotori0919/PLA-PET-Recycling-Lab/exports/final/drive_ggm_v08/GGM_SH_JackSprocketKey.step

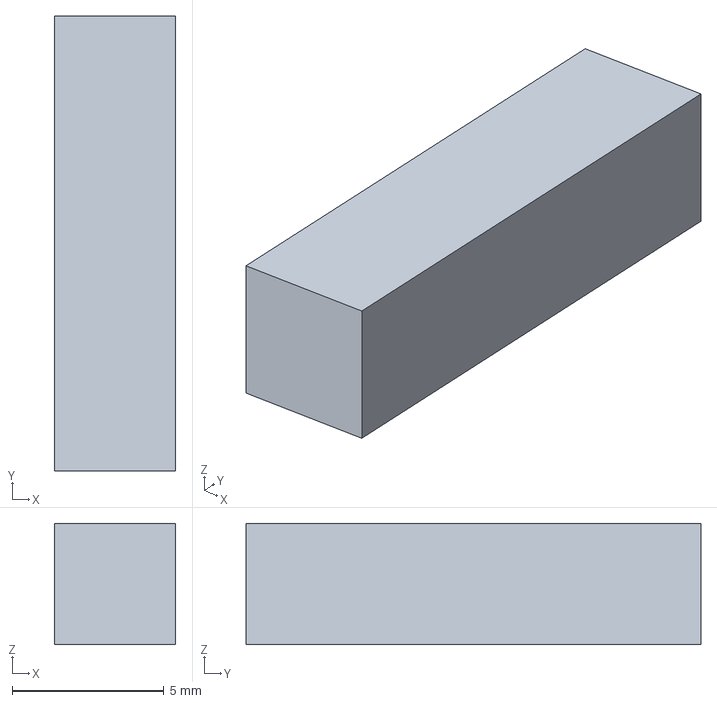
[picture p84: CAD file, 2026-10-19]
exports/final/drive_ggm_v08/GGM_SH_JackSprocketKey.step
4.00 x 15.0 x 4.00 mm
