kotori0919/PLA-PET-Recycling-Lab/exports/final/drive_ggm_v08/GGM_EX_CouplingGuard.FCStd

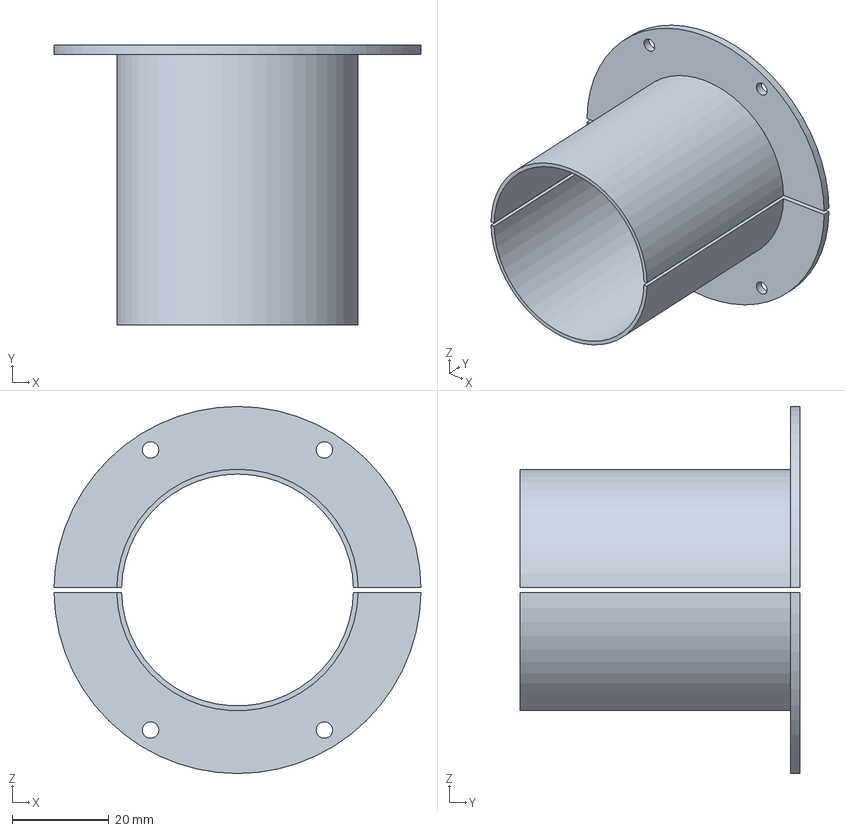
[picture p85: CAD file, 2026-10-19]
exports/final/drive_ggm_v08/GGM_EX_CouplingGuard.FCStd
76.0 x 58.0 x 76.0 mm
