kotori0919/PLA-PET-Recycling-Lab/(list of files, cad)

Other CAD files:
exports/step/compact_full_assembly.step
exports/review/compact_layout_v08/PPR-COMPACT-PLACEMENT-REVIEW.step
exports/review/compact_layout_v08/support_datum/PPR-COMPACT-SUPPORT-REVIEW.step
analysis/final_validation/results/v0.8/phase_gear_candidates/DRV-03-L-MATCHED-CANDIDATE.step
exports/print/plate_layouts/plate-02-PPR-C02.3mf
exports/review/compact_layout_v08/fixed_foot/SHELF-before.step
exports/review/compact_layout_v08/support_datum/GGM_SH_Base.step
exports/review/engineering-closure-20260909/01_STEP/CUT-05R.step
exports/review/engineering-closure-20260909/05_SOURCE/analysis/final_validation/input/CUT-05R.step
analysis/final_validation/results/v0.8/phase_gear_candidates/DRV-03-L-CANDIDATE.step
exports/final/drive_ggm_v08/GGM_SH_BearingCap313.step
exports/print/plate_layouts/plate-11-PPR-C11.3mf
exports/review/compact_layout_v08/fixed_foot/PPR-FIXED-FOOT-REVIEW.step
analysis/final_validation/results/v0.8/phase_gear_candidates/DRV-03-R-CANDIDATE.step
analysis/final_validation/results/v0.8/shield_service_cover_318_candidate.step
exports/final/drive_ggm_v08/GGM_SH_BearingCap301.step
exports/review/engineering-closure-20260909/05_SOURCE/analysis/final_validation/input/CUT-05.step
exports/final/drive_ggm_v08/GGM_EX_RadialCap.FCStd
exports/print/plate_layouts/plate-01-PPR-C01.3mf
exports/review/engineering-closure-20260909/01_STEP/CUT-05.step
analysis/final_validation/results/v0.8/die_pilot_L0p9_candidate_die.step
analysis/final_validation/results/v0.8/die_pilot_L0p9_candidate_barrel.step
analysis/final_validation/results/v0.8/die_pilot_candidate_breaker.step
exports/final/drive_ggm_v08/GGM_SH_Angle201.step
exports/final/drive_ggm_v08/GGM_SH_Spacer_90_280.FCStd
exports/final/drive_ggm_v08/GGM_SH_Base.step
analysis/final_validation/results/v0.8/slave_keyseat_candidate.step
exports/final/drive_ggm_v08/GGM_SH_BearingCap271.step
analysis/final_validation/results/v0.8/die_pilot_candidate_gasket.step
exports/final/drive_ggm_v08/GGM_EX_FuseInput.FCStd
exports/final/drive_ggm_v08/GGM_SH_Spacer_90_100.FCStd
exports/final/drive_ggm_v08/GGM_SH_Spacer_220_280.FCStd
exports/final/drive_ggm_v08/GGM_EX_FuseOutput.FCStd
exports/final/drive_ggm_v08/GGM_EX_FusePinBlank.FCStd
analysis/final_validation/results/v0.8/die_bolt_spacer_2p5_candidate.step
analysis/final_validation/results/v0.8/die_bolt_spacer_2p5_chamfer_candidate.step
analysis/final_validation/results/v0.8/die_bolt_spacer_candidate.step
exports/final/drive_ggm_v08/GGM-DRIVE-ASM.FCStd
exports/final/drive_ggm_v08/GGM-FULL-ASM.FCStd
exports/final/drive_ggm_v08/GGM_ChainGuard.FCStd
exports/final/drive_ggm_v08/GGM_JackInnerSpacer_front.FCStd
exports/final/drive_ggm_v08/GGM_JackInnerSpacer_pinionfront.FCStd
exports/final/drive_ggm_v08/GGM_JackInnerSpacer_pinionrear.FCStd
exports/final/drive_ggm_v08/GGM_JackInnerSpacer_rear.FCStd
exports/final/drive_ggm_v08/GGM_SH_Angle201.FCStd
exports/final/drive_ggm_v08/GGM_SH_Angle83.FCStd
exports/final/drive_ggm_v08/GGM_SH_Base.FCStd
exports/final/drive_ggm_v08/GGM_SH_BearingCap271.FCStd
exports/final/drive_ggm_v08/GGM_SH_BearingCap283.FCStd
exports/final/drive_ggm_v08/GGM_SH_BearingCap301.FCStd
exports/final/drive_ggm_v08/GGM_SH_BearingCap313.FCStd
exports/final/drive_ggm_v08/GGM_SH_BearingPlate273.FCStd
exports/final/drive_ggm_v08/GGM_SH_BearingPlate303.FCStd
exports/final/drive_ggm_v08/GGM_SH_CouplingGuard.FCStd
exports/final/drive_ggm_v08/GGM_SH_CutterKey.FCStd
exports/final/drive_ggm_v08/GGM_SH_FuseInput.FCStd
exports/final/drive_ggm_v08/GGM_SH_FuseOutput.FCStd
exports/final/drive_ggm_v08/GGM_SH_FusePinBlank.FCStd
exports/final/drive_ggm_v08/GGM_SH_JackInputKey.FCStd
exports/final/drive_ggm_v08/GGM_SH_JackSprocketKey.FCStd
exports/final/drive_ggm_v08/GGM_SH_Jackshaft.FCStd
exports/final/drive_ggm_v08/GGM_SH_MotorKey.FCStd
exports/final/drive_ggm_v08/GGM_SH_Mount.FCStd
exports/final/drive_ggm_v08/Screw-GGM.FCStd
exports/final/frame_v08/FR-TIE-01.FCStd
exports/final/frame_v08/FR-TIE-01.dxf
exports/print/PPR-C01/PPR-C01.3mf
exports/print/PPR-C01/PPR-C01.FCStd
exports/print/PPR-C01/PPR-C01.stl
exports/print/PPR-C02/PPR-C02.3mf
exports/print/PPR-C02/PPR-C02.FCStd
exports/print/PPR-C02/PPR-C02.stl
exports/print/PPR-C06/PPR-C06.3mf
exports/print/PPR-C06/PPR-C06.FCStd
exports/print/PPR-C06/PPR-C06.stl
exports/print/PPR-C11/PPR-C11.3mf
exports/print/PPR-C11/PPR-C11.FCStd
exports/print/PPR-C11/PPR-C11.stl
exports/review/compact_layout_v08/PPR-COMPACT-PLACEMENT-REVIEW.FCStd
exports/review/compact_layout_v08/fixed_foot/PPR-FIXED-FOOT-REVIEW.FCStd
exports/review/engineering-closure-20260909/01_STEP/CUT-05.FCStd
exports/review/engineering-closure-20260909/01_STEP/CUT-05R.FCStd
