kotori0919/PLA-PET-Recycling-Lab/exports/print/PPR-C01/print_notes.md

# PPR-C01 — Sliding hopper lid

- revision: `safety-orchestration-closure-v0.6.1`
- quantity: 1
- material: PLA
- nozzle diameter: 0.4 mm
- orientation: flat
- layer height: 0.24 mm
- wall count: 4
- top/bottom layers: 4
- infill: 20%
- support: no
- support-contact region: none
- support removal: ream latch hole to Ø4.50–4.70 and deburr underside countersink
- brim: none
- designed minimum wall: 1.6 mm
- estimated mass: 103.0 g/ea, 103.0 g total
- estimated print time: 8.6 h at 12 g/h planning rate
- fastener: 1x M4x16 90° flat-head latch flag screw + washer + nyloc
- insert or captured nut: none
- tightening torque: 1.2 N.m
- fastener edge distance: 15 mm boss centre to edge
- physical interfaces: M4 through bore Ø4.50–4.70 with Ø8.4×2 90° underside countersink; rail slide gap0.35
- tolerance: finished latch hole Ø4.50–4.70; screw head flush or recessed≤0.05; rail slide gap0.35
- mating part: metal hopper rails and lid-interlock flag
- assembly order: 3
- bounding box: 195.0 x 195.0 x 8.0 mm
- FreeCAD Python source: `PPR-C01.py` -> `cad/freecad/compact/geometry.py`
- dimension sheet: `dimension_sheet.svg`

Slicer 질량·시간은 `print_manifest.csv`와 `total_material_report.md`의 PrusaSlicer 결과가 지배한다.

<!-- SLICER_EVIDENCE_BEGIN -->
- PrusaSlicer package mass: **99.12 g** for released quantity
- PrusaSlicer package time: **11.21 h**
- support extrusion volume: **0.000 cm³** (G-code role integration; included in package mass)
<!-- SLICER_EVIDENCE_END -->
