kotori0919/PLA-PET-Recycling-Lab/exports/print/PPR-C03/print_notes.md

# PPR-C03 — Flake bin sheet corner

- revision: `safety-orchestration-closure-v0.6.1`
- quantity: 4
- material: PLA
- nozzle diameter: 0.4 mm
- orientation: end down
- layer height: 0.28 mm
- wall count: 4
- top/bottom layers: 4
- infill: 25%
- support: no
- support-contact region: none
- support removal: none
- brim: 5 mm
- designed minimum wall: 1.6 mm
- estimated mass: 22.7 g/ea, 90.6 g total
- estimated print time: 7.6 h at 12 g/h planning rate
- fastener: 2x M3x8 + washer + nyloc
- insert or captured nut: none
- tightening torque: 0.5 N.m
- fastener edge distance: 12 mm hole centre
- physical interfaces: 2x Ø3.4 through on orthogonal legs
- tolerance: sheet slot 1.40 ±0.30 mm
- mating part: 1.00 ±0.05 mm sheet bin and screen rails
- assembly order: 7
- bounding box: 25.0 x 25.0 x 100.0 mm
- FreeCAD Python source: `PPR-C03.py` -> `cad/freecad/compact/geometry.py`
- dimension sheet: `dimension_sheet.svg`

Slicer 질량·시간은 `print_manifest.csv`와 `total_material_report.md`의 PrusaSlicer 결과가 지배한다.

<!-- SLICER_EVIDENCE_BEGIN -->
- PrusaSlicer package mass: **89.04 g** for released quantity
- PrusaSlicer package time: **10.02 h**
- support extrusion volume: **0.000 cm³** (G-code role integration; included in package mass)
<!-- SLICER_EVIDENCE_END -->
