kotori0919/PLA-PET-Recycling-Lab/cad/manufacturing_object_audit.csv

object_id | category | container_type | expected_solids | solid_count | volume_mm3 | bbox_x_mm | bbox_y_mm | bbox_z_mm | status | errors
PPR-C01 | PRINT | Solid | 1 | 1 | 83050.862 | 195.0 | 195.0 | 8.0 | PASS
PPR-C02 | PRINT | Solid | 1 | 1 | 199061.375 | 190.0 | 120.0 | 90.0 | PASS
PPR-C03 | PRINT | Solid | 1 | 1 | 18273.283 | 25.0 | 25.0 | 100.0 | PASS
PPR-C04 | PRINT | Solid | 1 | 1 | 32049.668 | 100.0 | 25.0 | 20.0 | PASS
PPR-C05 | PRINT | Solid | 1 | 1 | 76659.062 | 80.0 | 75.0 | 100.0 | PASS
PPR-C06 | PRINT | Solid | 1 | 1 | 31931.727 | 95.0 | 70.0 | 28.0 | PASS
PPR-C07 | PRINT | Solid | 1 | 1 | 66623.308 | 110.0 | 100.0 | 65.0 | PASS
PPR-C08 | PRINT | Solid | 1 | 1 | 32656.231 | 60.0 | 45.0 | 70.0 | PASS
PPR-C09 | PRINT | Solid | 1 | 1 | 24324.594 | 70.0 | 70.0 | 35.0 | PASS
PPR-C10 | PRINT | Solid | 1 | 1 | 71902.833 | 90.0 | 55.0 | 24.0 | PASS
PPR-C11 | PRINT | Solid | 1 | 1 | 49616.634 | 180.0 | 120.0 | 8.0 | PASS
PPR-C12 | PRINT | Solid | 1 | 1 | 5009.085 | 38.0 | 26.0 | 8.0 | PASS
PPR-TC01 | TEST_COUPON | Solid | 1 | 1 | 61595.286 | 120.0 | 80.0 | 18.0 | PASS
CUT-01 | MACHINED | Compound | 1 | 1 | 7710.541 | 57.62 | 6.0 | 56.692 | PASS
CUT-02 | MACHINED | Compound | 1 | 1 | 2891.781 | 34.0 | 34.0 | 7.0 | PASS
CUT-03 | MACHINED | Compound | 1 | 1 | 188962.1 | 150.0 | 125.0 | 12.0 | PASS
CUT-04 | MACHINED | Compound | 1 | 1 | 38703.983 | 135.0 | 120.0 | 3.0 | PASS
CUT-05 | MACHINED | Compound | 1 | 1 | 113609.439 | 25.0 | 240.0 | 25.0 | PASS
CUT-05R | MACHINED | Compound | 1 | 1 | 113609.439 | 25.0 | 240.0 | 25.0 | PASS
CUT-06 | MACHINED | Compound | 1 | 1 | 1652.446 | 34.0 | 34.0 | 4.0 | PASS
CUT-07 | MACHINED | Compound | 1 | 1 | 114815.822 | 180.0 | 140.0 | 6.0 | PASS
CUT-08 | MACHINED | Compound | 1 | 1 | 6898.597 | 108.0 | 60.0 | 2.0 | PASS
CUT-09 | MACHINED | Compound | 1 | 1 | 5673.968 | 10.0 | 10.0 | 128.0 | PASS
CUT-10 | MACHINED | Compound | 1 | 1 | 2624.212 | 42.0 | 42.0 | 3.0 | PASS
G1J-01 | JIG_METAL | Compound | 1 | 1 | 845132.248 | 380.0 | 280.0 | 8.0 | PASS
G1J-02 | JIG_METAL | Compound | 1 | 1 | 42695.453 | 300.0 | 25.0 | 6.0 | PASS
G1J-03 | JIG_SHEET | Compound | 1 | 1 | 224113.722 | 340.0 | 220.0 | 3.0 | PASS
G1J-04 | JIG_SHEET | Compound | 1 | 1 | 171313.722 | 220.0 | 260.0 | 3.0 | PASS
G1J-05 | JIG_SHEET | Compound | 1 | 1 | 168313.722 | 220.0 | 260.0 | 3.0 | PASS
G1J-06 | JIG_SHEET | Compound | 1 | 1 | 9259.148 | 45.0 | 70.0 | 3.0 | PASS
G1J-07 | JIG_STOCK | Compound | 1 | 1 | 16529.148 | 20.0 | 20.0 | 220.0 | PASS
G1J-08 | JIG_STOCK | Compound | 1 | 1 | 11304.967 | 20.0 | 150.0 | 20.0 | PASS
G1J-09 | JIG_METAL | Compound | 1 | 1 | 5456.383 | 50.0 | 30.0 | 30.0 | PASS
G1J-10 | JIG_STOCK | Compound | 1 | 1 | 14652.609 | 50.0 | 40.0 | 40.0 | PASS
G1J-11 | JIG_STOCK | Compound | 1 | 1 | 14652.609 | 50.0 | 40.0 | 40.0 | PASS
G1J-12 | JIG_SHEET | Compound | 1 | 1 | 231241.722 | 340.0 | 260.0 | 3.0 | PASS
G1J-P01 | JIG_PRINT | Compound | 1 | 1 | 61531.2 | 120.0 | 90.0 | 115.0 | PASS
G1J-P02 | JIG_PRINT | Compound | 1 | 1 | 67617.792 | 180.0 | 160.0 | 42.0 | PASS
G1J-P03 | JIG_PRINT | Compound | 1 | 1 | 16880.0 | 10.0 | 10.0 | 210.0 | PASS
EX-SCR-01 | EXTRUDER_RFQ | Solid | 1 | 1 | 41745.626 | 23.0 | 23.0 | 316.0 | PASS
EX-BAR-01 | EXTRUDER_RFQ | Compound | 1 | 1 | 196898.993 | 39.0 | 44.0 | 280.0 | PASS
EX-CPN-SCR | EXTRUDER_RFQ | Solid | 1 | 1 | 4931.459 | 15.871 | 15.871 | 48.0 | PASS
EX-CPN-BAR | EXTRUDER_RFQ | Compound | 1 | 1 | 42108.023 | 34.0 | 34.0 | 60.0 | PASS
EX-DIE-01 | EXTRUDER_RFQ | Solid | 1 | 1 | 68180.327 | 40.0 | 40.0 | 48.0 | PASS
EX-DIE-02 | EXTRUDER_RFQ | Solid | 1 | 1 | 353.131 | 2.0 | 15.9 | 15.9 | PASS
EX-DIE-03 | EXTRUDER_RFQ | Solid | 1 | 1 | 1384.819 | 11.9 | 11.9 | 14.0 | PASS
EX-DIE-04 | EXTRUDER_RFQ | Solid | 1 | 1 | 818.438 | 32.0 | 20.0 | 1.5 | PASS
EX-DIE-05 | EXTRUDER_RFQ | Solid | 1 | 1 | 311.049 | 0.5 | 34.0 | 34.0 | PASS
FrameColumn0_0 | ASSEMBLY_MANUFACTURED_OR_STOCK | Solid | 1 | 1 | 356000.0 | 20.0 | 20.0 | 890.0 | PASS
FrameColumn0_680 | ASSEMBLY_MANUFACTURED_OR_STOCK | Solid | 1 | 1 | 356000.0 | 20.0 | 20.0 | 890.0 | PASS
FrameColumn450_0 | ASSEMBLY_MANUFACTURED_OR_STOCK | Solid | 1 | 1 | 356000.0 | 20.0 | 20.0 | 890.0 | PASS
FrameColumn450_680 | ASSEMBLY_MANUFACTURED_OR_STOCK | Solid | 1 | 1 | 356000.0 | 20.0 | 20.0 | 890.0 | PASS
FrameX0_0 | ASSEMBLY_MANUFACTURED_OR_STOCK | Solid | 1 | 1 | 172000.0 | 430.0 | 20.0 | 20.0 | PASS
FrameX0_680 | ASSEMBLY_MANUFACTURED_OR_STOCK | Solid | 1 | 1 | 172000.0 | 430.0 | 20.0 | 20.0 | PASS
FrameY0_0 | ASSEMBLY_MANUFACTURED_OR_STOCK | Solid | 1 | 1 | 264000.0 | 20.0 | 660.0 | 20.0 | PASS
FrameY0_450 | ASSEMBLY_MANUFACTURED_OR_STOCK | Solid | 1 | 1 | 264000.0 | 20.0 | 660.0 | 20.0 | PASS
FrameX910_0 | ASSEMBLY_MANUFACTURED_OR_STOCK | Solid | 1 | 1 | 172000.0 | 430.0 | 20.0 | 20.0 | PASS
FrameX910_680 | ASSEMBLY_MANUFACTURED_OR_STOCK | Solid | 1 | 1 | 172000.0 | 430.0 | 20.0 | 20.0 | PASS
FrameY910_0 | ASSEMBLY_MANUFACTURED_OR_STOCK | Solid | 1 | 1 | 264000.0 | 20.0 | 660.0 | 20.0 | PASS
FrameY910_450 | ASSEMBLY_MANUFACTURED_OR_STOCK | Solid | 1 | 1 | 264000.0 | 20.0 | 660.0 | 20.0 | PASS
FrameTierY320_0 | ASSEMBLY_MANUFACTURED_OR_STOCK | Solid | 1 | 1 | 264000.0 | 20.0 | 660.0 | 20.0 | PASS
FrameTierY320_450 | ASSEMBLY_MANUFACTURED_OR_STOCK | Solid | 1 | 1 | 264000.0 | 20.0 | 660.0 | 20.0 | PASS
MidRail320 | ASSEMBLY_MANUFACTURED_OR_STOCK | Solid | 1 | 1 | 172000.0 | 430.0 | 20.0 | 20.0 | PASS
FrameTierY500_0 | ASSEMBLY_MANUFACTURED_OR_STOCK | Solid | 1 | 1 | 528000.0 | 20.0 | 660.0 | 40.0 | PASS
FrameTierY500_450 | ASSEMBLY_MANUFACTURED_OR_STOCK | Solid | 1 | 1 | 528000.0 | 20.0 | 660.0 | 40.0 | PASS
MidRail500 | ASSEMBLY_MANUFACTURED_OR_STOCK | Solid | 1 | 1 | 172000.0 | 430.0 | 20.0 | 20.0 | PASS
FrameBottomCross275 | ASSEMBLY_MANUFACTURED_OR_STOCK | Solid | 1 | 1 | 172000.0 | 430.0 | 20.0 | 20.0 | PASS
FrameBottomCross405 | ASSEMBLY_MANUFACTURED_OR_STOCK | Solid | 1 | 1 | 172000.0 | 430.0 | 20.0 | 20.0 | PASS
FrameBottomCross440 | ASSEMBLY_MANUFACTURED_OR_STOCK | Solid | 1 | 1 | 172000.0 | 430.0 | 20.0 | 20.0 | PASS
FrameBottomCross608 | ASSEMBLY_MANUFACTURED_OR_STOCK | Solid | 1 | 1 | 172000.0 | 430.0 | 20.0 | 20.0 | PASS
FrameSpoolColumnFront | ASSEMBLY_MANUFACTURED_OR_STOCK | Solid | 1 | 1 | 120000.0 | 20.0 | 20.0 | 300.0 | PASS
FrameSpoolColumnRear | ASSEMBLY_MANUFACTURED_OR_STOCK | Solid | 1 | 1 | 120000.0 | 20.0 | 20.0 | 300.0 | PASS
FrameSpoolTopRail | ASSEMBLY_MANUFACTURED_OR_STOCK | Solid | 1 | 1 | 127200.0 | 20.0 | 318.0 | 20.0 | PASS
FrameTraversePostLeft | ASSEMBLY_MANUFACTURED_OR_STOCK | Solid | 1 | 1 | 112000.0 | 20.0 | 20.0 | 280.0 | PASS
FrameTraversePostRight | ASSEMBLY_MANUFACTURED_OR_STOCK | Solid | 1 | 1 | 112000.0 | 20.0 | 20.0 | 280.0 | PASS
MetalHopper | ASSEMBLY_MANUFACTURED_OR_STOCK | Compound | 1 | 1 | 231095.556 | 200.0 | 200.0 | 210.0 | PASS
PPR-C01_SlidingLid | ASSEMBLY_MANUFACTURED_OR_STOCK | Solid | 1 | 1 | 83050.862 | 195.0 | 195.0 | 8.0 | PASS
PPR-C02_AntiReach | ASSEMBLY_MANUFACTURED_OR_STOCK | Solid | 1 | 1 | 199061.375 | 190.0 | 120.0 | 90.0 | PASS
CutterPlateFront | ASSEMBLY_MANUFACTURED_OR_STOCK | Compound | 1 | 1 | 188962.1 | 150.0 | 12.0 | 125.0 | PASS
CutterPlateRear | ASSEMBLY_MANUFACTURED_OR_STOCK | Compound | 1 | 1 | 188962.1 | 150.0 | 12.0 | 125.0 | PASS
Shaft105 | ASSEMBLY_MANUFACTURED_OR_STOCK | Compound | 1 | 1 | 113609.439 | 25.0 | 240.0 | 25.0 | PASS
Hook105_0 | ASSEMBLY_MANUFACTURED_OR_STOCK | Compound | 1 | 1 | 7679.172 | 57.56 | 6.0 | 56.692 | PASS
Hook105_1 | ASSEMBLY_MANUFACTURED_OR_STOCK | Compound | 1 | 1 | 7679.172 | 57.56 | 6.0 | 56.692 | PASS
Hook105_2 | ASSEMBLY_MANUFACTURED_OR_STOCK | Compound | 1 | 1 | 7679.172 | 57.56 | 6.0 | 56.692 | PASS
Hook105_3 | ASSEMBLY_MANUFACTURED_OR_STOCK | Compound | 1 | 1 | 7679.172 | 57.56 | 6.0 | 56.692 | PASS
Hook105_4 | ASSEMBLY_MANUFACTURED_OR_STOCK | Compound | 1 | 1 | 7679.172 | 57.56 | 6.0 | 56.692 | PASS
Hook105_5 | ASSEMBLY_MANUFACTURED_OR_STOCK | Compound | 1 | 1 | 7679.172 | 57.56 | 6.0 | 56.692 | PASS
Bearing105_315 | ASSEMBLY_MANUFACTURED_OR_STOCK | Compound | 1 | 1 | 10734.822 | 42.0 | 12.0 | 42.0 | PASS
Bearing105_455 | ASSEMBLY_MANUFACTURED_OR_STOCK | Compound | 1 | 1 | 10734.822 | 42.0 | 12.0 | 42.0 | PASS
Shaft153 | ASSEMBLY_MANUFACTURED_OR_STOCK | Compound | 1 | 1 | 113609.439 | 25.0 | 240.0 | 25.0 | PASS
Hook153_0 | ASSEMBLY_MANUFACTURED_OR_STOCK | Compound | 1 | 1 | 7679.172 | 57.56 | 6.0 | 56.692 | PASS
Hook153_1 | ASSEMBLY_MANUFACTURED_OR_STOCK | Compound | 1 | 1 | 7679.172 | 57.56 | 6.0 | 56.692 | PASS
Hook153_2 | ASSEMBLY_MANUFACTURED_OR_STOCK | Compound | 1 | 1 | 7679.172 | 57.56 | 6.0 | 56.692 | PASS
Hook153_3 | ASSEMBLY_MANUFACTURED_OR_STOCK | Compound | 1 | 1 | 7679.172 | 57.56 | 6.0 | 56.692 | PASS
Hook153_4 | ASSEMBLY_MANUFACTURED_OR_STOCK | Compound | 1 | 1 | 7679.172 | 57.56 | 6.0 | 56.692 | PASS
Hook153_5 | ASSEMBLY_MANUFACTURED_OR_STOCK | Compound | 1 | 1 | 7679.172 | 57.56 | 6.0 | 56.692 | PASS
Bearing153_315 | ASSEMBLY_MANUFACTURED_OR_STOCK | Compound | 1 | 1 | 10734.822 | 42.0 | 12.0 | 42.0 | PASS
Bearing153_455 | ASSEMBLY_MANUFACTURED_OR_STOCK | Compound | 1 | 1 | 10734.822 | 42.0 | 12.0 | 42.0 | PASS
CUT09Sleeve70_550 | ASSEMBLY_MANUFACTURED_OR_STOCK | Compound | 1 | 1 | 5673.968 | 10.0 | 128.0 | 10.0 | PASS
M6Fastener70_550 | ASSEMBLY_MANUFACTURED_OR_STOCK | Solid | 1 | 1 | 4806.637 | 6.0 | 170.0 | 6.0 | PASS
CUT09Sleeve70_645 | ASSEMBLY_MANUFACTURED_OR_STOCK | Compound | 1 | 1 | 5673.968 | 10.0 | 128.0 | 10.0 | PASS
M6Fastener70_645 | ASSEMBLY_MANUFACTURED_OR_STOCK | Solid | 1 | 1 | 4806.637 | 6.0 | 170.0 | 6.0 | PASS
CUT09Sleeve190_550 | ASSEMBLY_MANUFACTURED_OR_STOCK | Compound | 1 | 1 | 5673.968 | 10.0 | 128.0 | 10.0 | PASS
M6Fastener190_550 | ASSEMBLY_MANUFACTURED_OR_STOCK | Solid | 1 | 1 | 4806.637 | 6.0 | 170.0 | 6.0 | PASS
CUT09Sleeve190_645 | ASSEMBLY_MANUFACTURED_OR_STOCK | Compound | 1 | 1 | 5673.968 | 10.0 | 128.0 | 10.0 | PASS
M6Fastener190_645 | ASSEMBLY_MANUFACTURED_OR_STOCK | Solid | 1 | 1 | 4806.637 | 6.0 | 170.0 | 6.0 | PASS
Screen | ASSEMBLY_MANUFACTURED_OR_STOCK | Solid | 1 | 1 | 48600.0 | 135.0 | 120.0 | 3.0 | PASS
PPR-C04_ScreenHandle | ASSEMBLY_MANUFACTURED_OR_STOCK | Solid | 1 | 1 | 32049.668 | 100.0 | 25.0 | 20.0 | PASS
PhaseGear105 | ASSEMBLY_MANUFACTURED_OR_STOCK | Compound | 1 | 1 | 22538.028 | 53.996 | 18.0 | 53.996 | PASS
PhaseGear153 | ASSEMBLY_MANUFACTURED_OR_STOCK | Compound | 1 | 1 | 22538.028 | 53.305 | 18.0 | 53.305 | PASS
CutterSprocket30T | ASSEMBLY_MANUFACTURED_OR_STOCK | Solid | 1 | 1 | 70429.176 | 96.839 | 12.0 | 96.687 | PASS
MotorSprocket12T | ASSEMBLY_MANUFACTURED_OR_STOCK | Solid | 1 | 1 | 8786.025 | 41.763 | 10.0 | 41.763 | PASS
ChainTightSide | ASSEMBLY_PURCHASED_REFERENCE_LOD | Solid | 1 | 1 | 2880.0 | 4.0 | 8.0 | 90.0 | PASS
ChainSlackSide | ASSEMBLY_PURCHASED_REFERENCE_LOD | Solid | 1 | 1 | 2880.0 | 4.0 | 8.0 | 90.0 | PASS
DriveGuard | ASSEMBLY_MANUFACTURED_OR_STOCK | Compound | 1 | 1 | 60555.505 | 165.0 | 48.0 | 190.0 | PASS
DriveMotorGMP60Reference | ASSEMBLY_PURCHASED_REFERENCE_ENVELOPE | Solid | 1 | 1 | 538182.271 | 60.5 | 211.8 | 60.5 | PASS
DriveAdapterGMP60 | ASSEMBLY_MANUFACTURED_OR_STOCK | Solid | 1 | 1 | 31556.069 | 80.0 | 6.0 | 80.0 | PASS
MotorMountPlate | ASSEMBLY_MANUFACTURED_OR_STOCK | Compound | 1 | 1 | 114815.822 | 180.0 | 6.0 | 140.0 | PASS
BearingRetainerFront | ASSEMBLY_MANUFACTURED_OR_STOCK | Compound | 1 | 1 | 6898.597 | 108.0 | 2.0 | 60.0 | PASS
BearingRetainerRear | ASSEMBLY_MANUFACTURED_OR_STOCK | Compound | 1 | 1 | 6898.597 | 108.0 | 2.0 | 60.0 | PASS
ShredderRPMSensorEnvelope | ASSEMBLY_UNVERIFIED_DONOR_ENVELOPE | Solid | 1 | 1 | 1920.0 | 12.0 | 8.0 | 20.0 | PASS
ShredderCableRouteEnvelope | ASSEMBLY_PURCHASED_REFERENCE_ENVELOPE | Solid | 1 | 1 | 18000.0 | 12.0 | 12.0 | 125.0 | PASS
FlakeBin | ASSEMBLY_MANUFACTURED_OR_STOCK | Solid | 1 | 1 | 113640.6 | 185.0 | 175.0 | 115.0 | PASS
PPR-C03_FlakeCorner0 | ASSEMBLY_MANUFACTURED_OR_STOCK | Solid | 1 | 1 | 18273.283 | 25.0 | 25.0 | 100.0 | PASS
PPR-C03_FlakeCorner1 | ASSEMBLY_MANUFACTURED_OR_STOCK | Solid | 1 | 1 | 18273.283 | 25.0 | 25.0 | 100.0 | PASS
PPR-C03_FlakeCorner2 | ASSEMBLY_MANUFACTURED_OR_STOCK | Solid | 1 | 1 | 18273.283 | 25.0 | 25.0 | 100.0 | PASS
PPR-C03_FlakeCorner3 | ASSEMBLY_MANUFACTURED_OR_STOCK | Solid | 1 | 1 | 18273.283 | 25.0 | 25.0 | 100.0 | PASS
SealedFeedHopper | ASSEMBLY_MANUFACTURED_OR_STOCK | Solid | 1 | 1 | 173637.008 | 156.0 | 156.001 | 200.0 | PASS
FeedHopperGasket | ASSEMBLY_MANUFACTURED_OR_STOCK | Solid | 1 | 1 | 392.196 | 44.0 | 44.0 | 0.5 | PASS
TemperatureProbeT5 | ASSEMBLY_MANUFACTURED_OR_STOCK | Solid | 1 | 1 | 337.878 | 6.0 | 70.4 | 6.0 | PASS
FeederHousing | ASSEMBLY_MANUFACTURED_OR_STOCK | Solid | 1 | 1 | 22783.873 | 44.0 | 44.0 | 106.2 | PASS
FeederAuger | ASSEMBLY_MANUFACTURED_OR_STOCK | Solid | 1 | 1 | 8319.556 | 24.414 | 24.414 | 105.0 | PASS
FeederAgitatorDriveShaft | ASSEMBLY_MANUFACTURED_OR_STOCK | Solid | 1 | 1 | 18125.184 | 120.0 | 100.0 | 300.0 | PASS
FeederAugerSpringPin | ASSEMBLY_MANUFACTURED_OR_STOCK | Solid | 1 | 1 | 84.823 | 12.0 | 3.0 | 3.0 | PASS
FeederDriveReference | ASSEMBLY_UNVERIFIED_DONOR_ENVELOPE | Solid | 1 | 1 | 163072.0 | 56.0 | 56.0 | 52.0 | PASS
FeederCableRouteEnvelope | ASSEMBLY_PURCHASED_REFERENCE_ENVELOPE | Solid | 1 | 1 | 24480.0 | 12.0 | 12.0 | 170.0 | PASS
ThrustPlate | ASSEMBLY_MANUFACTURED_OR_STOCK | Solid | 1 | 1 | 111640.112 | 12.0 | 95.0 | 105.0 | PASS
ScrewThrustBearing | ASSEMBLY_PURCHASED_REFERENCE_ENVELOPE | Solid | 1 | 1 | 3951.338 | 9.0 | 28.0 | 28.0 | PASS
Screw | ASSEMBLY_MANUFACTURED_OR_STOCK | Solid | 1 | 1 | 41745.626 | 316.0 | 23.0 | 23.0 | PASS
Barrel | ASSEMBLY_MANUFACTURED_OR_STOCK | Solid | 1 | 1 | 196898.993 | 280.0 | 44.0 | 39.0 | PASS
BarrelBandHeaterZ1 | ASSEMBLY_PURCHASED_REFERENCE_ENVELOPE | Solid | 1 | 1 | 9860.431 | 45.0 | 38.15 | 38.045 | PASS
TemperatureProbeT1 | ASSEMBLY_MANUFACTURED_OR_STOCK | Solid | 1 | 1 | 337.878 | 6.0 | 70.4 | 6.0 | PASS
TemperatureProbeRetainerT1 | ASSEMBLY_MANUFACTURED_OR_STOCK | Solid | 1 | 1 | 247.144 | 12.0 | 16.0 | 1.5 | PASS
BarrelBandHeaterZ2 | ASSEMBLY_PURCHASED_REFERENCE_ENVELOPE | Solid | 1 | 1 | 9860.431 | 45.0 | 38.15 | 38.045 | PASS
TemperatureProbeT2 | ASSEMBLY_MANUFACTURED_OR_STOCK | Solid | 1 | 1 | 337.878 | 6.0 | 70.4 | 6.0 | PASS
TemperatureProbeRetainerT2 | ASSEMBLY_MANUFACTURED_OR_STOCK | Solid | 1 | 1 | 247.144 | 12.0 | 16.0 | 1.5 | PASS
BarrelBandHeaterZ3 | ASSEMBLY_PURCHASED_REFERENCE_ENVELOPE | Solid | 1 | 1 | 9860.431 | 45.0 | 38.15 | 38.045 | PASS
TemperatureProbeT3 | ASSEMBLY_MANUFACTURED_OR_STOCK | Solid | 1 | 1 | 337.878 | 6.0 | 70.4 | 6.0 | PASS
TemperatureProbeRetainerT3 | ASSEMBLY_MANUFACTURED_OR_STOCK | Solid | 1 | 1 | 247.144 | 12.0 | 16.0 | 1.5 | PASS
BarrelThermalFuse | ASSEMBLY_MANUFACTURED_OR_STOCK | Solid | 1 | 1 | 2112.0 | 22.0 | 8.0 | 12.0 | PASS
HotShield | ASSEMBLY_MANUFACTURED_OR_STOCK | Solid | 1 | 1 | 156429.831 | 335.0 | 75.0 | 85.0 | PASS
ExtruderDrive | ASSEMBLY_UNVERIFIED_DONOR_ENVELOPE | Solid | 1 | 1 | 294641.819 | 55.0 | 75.0 | 85.0 | PASS
DownDieBody | ASSEMBLY_MANUFACTURED_OR_STOCK | Solid | 1 | 1 | 68180.327 | 40.0 | 40.0 | 48.0 | PASS
DownDieBreaker | ASSEMBLY_MANUFACTURED_OR_STOCK | Solid | 1 | 1 | 353.131 | 2.0 | 15.9 | 15.9 | PASS
DownDieInsert | ASSEMBLY_MANUFACTURED_OR_STOCK | Solid | 1 | 1 | 1384.819 | 11.9 | 11.9 | 14.0 | PASS
DownDieRelief | ASSEMBLY_MANUFACTURED_OR_STOCK | Solid | 1 | 1 | 818.438 | 32.0 | 20.0 | 1.5 | PASS
DownDieGasket | ASSEMBLY_MANUFACTURED_OR_STOCK | Solid | 1 | 1 | 311.049 | 0.5 | 34.0 | 34.0 | PASS
DieCartridgeHeater | ASSEMBLY_PURCHASED_REFERENCE_ENVELOPE | Solid | 1 | 1 | 1626.902 | 20.0 | 40.5 | 12.0 | PASS
TemperatureProbeT4 | ASSEMBLY_MANUFACTURED_OR_STOCK | Solid | 1 | 1 | 337.878 | 6.0 | 70.4 | 6.0 | PASS
TemperatureProbeRetainerT4 | ASSEMBLY_MANUFACTURED_OR_STOCK | Solid | 1 | 1 | 247.144 | 12.0 | 16.0 | 1.5 | PASS
DieThermalFuse | ASSEMBLY_MANUFACTURED_OR_STOCK | Solid | 1 | 1 | 1260.0 | 18.0 | 7.0 | 10.0 | PASS
HeaterLeadZ1 | ASSEMBLY_MANUFACTURED_OR_STOCK | Solid | 1 | 1 | 691.15 | 4.0 | 55.0 | 4.0 | PASS
HeaterLeadZ2 | ASSEMBLY_MANUFACTURED_OR_STOCK | Solid | 1 | 1 | 691.15 | 4.0 | 55.0 | 4.0 | PASS
HeaterLeadZ3 | ASSEMBLY_MANUFACTURED_OR_STOCK | Solid | 1 | 1 | 691.15 | 4.0 | 55.0 | 4.0 | PASS
HeaterCableDuct | ASSEMBLY_MANUFACTURED_OR_STOCK | Solid | 1 | 1 | 13544.0 | 250.0 | 18.0 | 18.0 | PASS
HeaterCableDuctBridgeX | ASSEMBLY_MANUFACTURED_OR_STOCK | Solid | 1 | 1 | 3872.0 | 64.0 | 18.0 | 18.0 | PASS
HeaterCableDuctBridgeY | ASSEMBLY_MANUFACTURED_OR_STOCK | Solid | 1 | 1 | 12608.0 | 18.0 | 232.0 | 18.0 | PASS
PPR-C05_CoolingDuctLower | ASSEMBLY_MANUFACTURED_OR_STOCK | Solid | 1 | 1 | 76659.062 | 80.0 | 75.0 | 100.0 | PASS
PPR-C05_CoolingDuctUpper | ASSEMBLY_MANUFACTURED_OR_STOCK | Solid | 1 | 1 | 76659.062 | 80.0 | 75.0 | 100.0 | PASS
PPR-C06_GaugeX | ASSEMBLY_MANUFACTURED_OR_STOCK | Solid | 1 | 1 | 31931.727 | 95.0 | 70.0 | 28.0 | PASS
PPR-C06_GaugeY | ASSEMBLY_MANUFACTURED_OR_STOCK | Solid | 1 | 1 | 31931.727 | 70.0 | 95.0 | 28.0 | PASS
PullerPlateFront | ASSEMBLY_MANUFACTURED_OR_STOCK | Solid | 1 | 1 | 36750.397 | 100.0 | 10.0 | 40.0 | PASS
PullerPlateRear | ASSEMBLY_MANUFACTURED_OR_STOCK | Solid | 1 | 1 | 36750.397 | 100.0 | 10.0 | 40.0 | PASS
PullerRoll53.6 | ASSEMBLY_MANUFACTURED_OR_STOCK | Solid | 1 | 1 | 72229.613 | 40.0 | 60.0 | 40.0 | PASS
PullerSpindle53.6 | ASSEMBLY_MANUFACTURED_OR_STOCK | Solid | 1 | 1 | 4021.239 | 8.0 | 80.0 | 8.0 | PASS
PullerRoll95.4 | ASSEMBLY_MANUFACTURED_OR_STOCK | Solid | 1 | 1 | 72229.613 | 40.0 | 60.0 | 40.0 | PASS
PullerSpindle95.4 | ASSEMBLY_MANUFACTURED_OR_STOCK | Solid | 1 | 1 | 4021.239 | 8.0 | 80.0 | 8.0 | PASS
PullerEccentricBushFront | ASSEMBLY_MANUFACTURED_OR_STOCK | Solid | 1 | 1 | 2492.14 | 24.0 | 13.0 | 24.0 | PASS
PullerEccentricBushRear | ASSEMBLY_MANUFACTURED_OR_STOCK | Solid | 1 | 1 | 2492.14 | 24.0 | 13.0 | 24.0 | PASS
FormingCableRouteEnvelope | ASSEMBLY_PURCHASED_REFERENCE_ENVELOPE | Solid | 1 | 1 | 18000.0 | 125.0 | 12.0 | 12.0 | PASS
PPR-C07_PullerGuard | ASSEMBLY_MANUFACTURED_OR_STOCK | Solid | 1 | 1 | 66623.308 | 110.0 | 100.0 | 65.0 | PASS
GuideRoller | ASSEMBLY_MANUFACTURED_OR_STOCK | Solid | 1 | 1 | 15259.366 | 36.0 | 20.0 | 36.0 | PASS
GuideRollerAxle | ASSEMBLY_MANUFACTURED_OR_STOCK | Solid | 1 | 1 | 589.049 | 5.0 | 30.0 | 5.0 | PASS
GuideBearingFront | ASSEMBLY_MANUFACTURED_OR_STOCK | Compound | 1 | 1 | 907.135 | 16.0 | 5.0 | 16.0 | PASS
GuideBearingRear | ASSEMBLY_MANUFACTURED_OR_STOCK | Compound | 1 | 1 | 907.135 | 16.0 | 5.0 | 16.0 | PASS
GuideBearingRetainerFront | ASSEMBLY_MANUFACTURED_OR_STOCK | Solid | 1 | 1 | 600.296 | 32.0 | 1.0 | 32.0 | PASS
GuideBearingRetainerRear | ASSEMBLY_MANUFACTURED_OR_STOCK | Solid | 1 | 1 | 600.296 | 32.0 | 1.0 | 32.0 | PASS
PPR-C08_GuideBracketFront | ASSEMBLY_MANUFACTURED_OR_STOCK | Solid | 1 | 1 | 32656.231 | 60.0 | 45.0 | 70.0 | PASS
PPR-C08_GuideBracketRear | ASSEMBLY_MANUFACTURED_OR_STOCK | Solid | 1 | 1 | 32656.231 | 60.0 | 45.0 | 70.0 | PASS
DancerArm | ASSEMBLY_MANUFACTURED_OR_STOCK | Solid | 1 | 1 | 12886.609 | 122.0 | 8.0 | 24.0 | PASS
DancerSupportPlate | ASSEMBLY_MANUFACTURED_OR_STOCK | Solid | 1 | 1 | 22237.386 | 36.0 | 8.0 | 80.0 | PASS
DancerSupportPost | ASSEMBLY_MANUFACTURED_OR_STOCK | Solid | 1 | 1 | 20000.0 | 20.0 | 20.0 | 50.0 | PASS
DancerPivotAxle | ASSEMBLY_MANUFACTURED_OR_STOCK | Solid | 1 | 1 | 804.248 | 8.0 | 16.0 | 8.0 | PASS
DancerEndRoller | ASSEMBLY_MANUFACTURED_OR_STOCK | Compound | 1 | 1 | 5226.982 | 20.0 | 20.0 | 20.0 | PASS
DancerEndAxle | ASSEMBLY_MANUFACTURED_OR_STOCK | Solid | 1 | 1 | 1809.557 | 8.0 | 36.0 | 8.0 | PASS
Spool | ASSEMBLY_PURCHASED_REFERENCE_ENVELOPE | Solid | 1 | 1 | 2293362.637 | 200.0 | 73.0 | 200.0 | PASS
SpoolCore | ASSEMBLY_PURCHASED_REFERENCE_LOD | Solid | 1 | 1 | 155031.314 | 52.0 | 73.0 | 52.0 | PASS
SpoolSpindle | ASSEMBLY_MANUFACTURED_OR_STOCK | Solid | 1 | 1 | 16172.919 | 12.0 | 143.0 | 12.0 | PASS
SpoolBearingPlateFront | ASSEMBLY_MANUFACTURED_OR_STOCK | Solid | 1 | 1 | 55578.844 | 105.0 | 10.0 | 60.0 | PASS
SpoolBearingPlateRear | ASSEMBLY_MANUFACTURED_OR_STOCK | Solid | 1 | 1 | 55578.844 | 105.0 | 10.0 | 60.0 | PASS
SpoolBearingRetainerFront | ASSEMBLY_MANUFACTURED_OR_STOCK | Solid | 1 | 1 | 4580.075 | 54.0 | 2.0 | 54.0 | PASS
SpoolBearingRetainerRear | ASSEMBLY_MANUFACTURED_OR_STOCK | Solid | 1 | 1 | 4580.075 | 54.0 | 2.0 | 54.0 | PASS
SpoolBearingFront | ASSEMBLY_MANUFACTURED_OR_STOCK | Compound | 1 | 1 | 3990.828 | 28.0 | 8.0 | 28.0 | PASS
SpoolBearingRear | ASSEMBLY_MANUFACTURED_OR_STOCK | Compound | 1 | 1 | 3990.828 | 28.0 | 8.0 | 28.0 | PASS
PPR-C09_SpoolAdapterFront | ASSEMBLY_MANUFACTURED_OR_STOCK | Solid | 1 | 1 | 24324.594 | 70.0 | 35.0 | 70.0 | PASS
PPR-C09_SpoolAdapterRear | ASSEMBLY_MANUFACTURED_OR_STOCK | Solid | 1 | 1 | 24324.594 | 70.0 | 35.0 | 70.0 | PASS
TraverseRodA | ASSEMBLY_MANUFACTURED_OR_STOCK | Solid | 1 | 1 | 8042.477 | 160.0 | 8.0 | 8.0 | PASS
TraverseRodB | ASSEMBLY_MANUFACTURED_OR_STOCK | Solid | 1 | 1 | 8042.477 | 160.0 | 8.0 | 8.0 | PASS
TraverseEndPlateLeft | ASSEMBLY_MANUFACTURED_OR_STOCK | Solid | 1 | 1 | 9234.315 | 5.0 | 50.0 | 40.0 | PASS
TraverseEndPlateRight | ASSEMBLY_MANUFACTURED_OR_STOCK | Solid | 1 | 1 | 9234.315 | 5.0 | 50.0 | 40.0 | PASS
PPR-C10_TraverseCarriage | ASSEMBLY_MANUFACTURED_OR_STOCK | Solid | 1 | 1 | 71902.833 | 90.0 | 55.0 | 24.0 | PASS
DancerSensorEnvelope | ASSEMBLY_UNVERIFIED_DONOR_ENVELOPE | Solid | 1 | 1 | 3168.0 | 12.0 | 12.0 | 22.0 | PASS
TraverseLeftLimitEnvelope | ASSEMBLY_UNVERIFIED_DONOR_ENVELOPE | Solid | 1 | 1 | 2160.0 | 12.0 | 10.0 | 18.0 | PASS
TraverseRightLimitEnvelope | ASSEMBLY_UNVERIFIED_DONOR_ENVELOPE | Solid | 1 | 1 | 2160.0 | 12.0 | 10.0 | 18.0 | PASS
SpoolerTachSensorEnvelope | ASSEMBLY_UNVERIFIED_DONOR_ENVELOPE | Solid | 1 | 1 | 2520.0 | 14.0 | 10.0 | 18.0 | PASS
SpoolerCableRouteEnvelope | ASSEMBLY_PURCHASED_REFERENCE_ENVELOPE | Solid | 1 | 1 | 38880.0 | 270.0 | 12.0 | 12.0 | PASS
SpoolMotorMount | ASSEMBLY_MANUFACTURED_OR_STOCK | Solid | 1 | 1 | 28130.861 | 101.0 | 6.0 | 52.0 | PASS
SpoolMotorEnvelope | ASSEMBLY_UNVERIFIED_DONOR_ENVELOPE | Solid | 1 | 1 | 84672.0 | 42.0 | 48.0 | 42.0 | PASS
ControlPanel | ASSEMBLY_MANUFACTURED_OR_STOCK | Compound | 1 | 1 | 119275.361 | 190.0 | 35.0 | 190.0 | PASS
PPR-C11_ControlBezel | ASSEMBLY_MANUFACTURED_OR_STOCK | Solid | 1 | 1 | 49616.634 | 180.0 | 8.0 | 120.0 | PASS
ControlEmergencyStopEnvelope | ASSEMBLY_UNVERIFIED_DONOR_ENVELOPE | Solid | 1 | 1 | 37699.112 | 30.0 | 40.0 | 40.0 | PASS
ControlEncoderEnvelope | ASSEMBLY_UNVERIFIED_DONOR_ENVELOPE | Solid | 1 | 1 | 5598.318 | 18.0 | 22.0 | 18.0 | PASS
ControlSafetyInputEnvelope | ASSEMBLY_UNVERIFIED_DONOR_ENVELOPE | Solid | 1 | 1 | 58800.0 | 70.0 | 24.0 | 35.0 | PASS
ControlBezelM3Fastener1 | ASSEMBLY_MANUFACTURED_OR_STOCK | Solid | 1 | 1 | 84.823 | 3.0 | 12.0 | 3.0 | PASS
ControlBezelM3Fastener2 | ASSEMBLY_MANUFACTURED_OR_STOCK | Solid | 1 | 1 | 84.823 | 3.0 | 12.0 | 3.0 | PASS
ControlBezelM3Fastener3 | ASSEMBLY_MANUFACTURED_OR_STOCK | Solid | 1 | 1 | 84.823 | 3.0 | 12.0 | 3.0 | PASS
ControlBezelM3Fastener4 | ASSEMBLY_MANUFACTURED_OR_STOCK | Solid | 1 | 1 | 84.823 | 3.0 | 12.0 | 3.0 | PASS
PSU | ASSEMBLY_UNVERIFIED_DONOR_ENVELOPE | Solid | 1 | 1 | 2592000.0 | 160.0 | 180.0 | 90.0 | PASS
CableDuct | ASSEMBLY_PURCHASED_REFERENCE_ENVELOPE | Solid | 1 | 1 | 243000.0 | 18.0 | 18.0 | 750.0 | PASS
PPR-C12_CableClip0 | ASSEMBLY_MANUFACTURED_OR_STOCK | Solid | 1 | 1 | 5009.085 | 38.0 | 26.0 | 8.0 | PASS
PPR-C12_CableClip1 | ASSEMBLY_MANUFACTURED_OR_STOCK | Solid | 1 | 1 | 5009.085 | 38.0 | 26.0 | 8.0 | PASS
PPR-C12_CableClip2 | ASSEMBLY_MANUFACTURED_OR_STOCK | Solid | 1 | 1 | 5009.085 | 38.0 | 26.0 | 8.0 | PASS
PPR-C12_CableClip3 | ASSEMBLY_MANUFACTURED_OR_STOCK | Solid | 1 | 1 | 5009.085 | 38.0 | 26.0 | 8.0 | PASS
PPR-C12_CableClip4 | ASSEMBLY_MANUFACTURED_OR_STOCK | Solid | 1 | 1 | 5009.085 | 38.0 | 26.0 | 8.0 | PASS
PPR-C12_CableClip5 | ASSEMBLY_MANUFACTURED_OR_STOCK | Solid | 1 | 1 | 5009.085 | 38.0 | 26.0 | 8.0 | PASS
PPR-C12_CableClip6 | ASSEMBLY_MANUFACTURED_OR_STOCK | Solid | 1 | 1 | 5009.085 | 38.0 | 26.0 | 8.0 | PASS
PPR-C12_CableClip7 | ASSEMBLY_MANUFACTURED_OR_STOCK | Solid | 1 | 1 | 5009.085 | 38.0 | 26.0 | 8.0 | PASS
ExtruderSupportRailRear | ASSEMBLY_MANUFACTURED_OR_STOCK | Solid | 1 | 1 | 156000.0 | 390.0 | 20.0 | 20.0 | PASS
ExtruderRearFixedDatum | ASSEMBLY_MANUFACTURED_OR_STOCK | Solid | 1 | 1 | 29558.384 | 8.0 | 150.0 | 58.0 | PASS
ExtruderFrontSlidingGuide | ASSEMBLY_MANUFACTURED_OR_STOCK | Solid | 1 | 1 | 28694.575 | 8.0 | 150.0 | 76.0 | PASS
ExtruderFixedCollar | ASSEMBLY_MANUFACTURED_OR_STOCK | Solid | 1 | 1 | 5848.021 | 12.0 | 50.0 | 41.0 | PASS
ExtruderRearRetainer | ASSEMBLY_MANUFACTURED_OR_STOCK | Solid | 1 | 1 | 18174.851 | 12.0 | 70.0 | 50.0 | PASS
ExtruderRearRetainerSpacer318 | ASSEMBLY_MANUFACTURED_OR_STOCK | Solid | 1 | 1 | 144.317 | 4.2 | 8.0 | 8.0 | PASS
ExtruderRearRetainerSpacer376 | ASSEMBLY_MANUFACTURED_OR_STOCK | Solid | 1 | 1 | 144.317 | 4.2 | 8.0 | 8.0 | PASS
RearRetainerM4_318 | ASSEMBLY_PURCHASED_FASTENER | Solid | 1 | 1 | 468.097 | 29.0 | 7.0 | 7.0 | PASS
RearRetainerM4_376 | ASSEMBLY_PURCHASED_FASTENER | Solid | 1 | 1 | 468.097 | 29.0 | 7.0 | 7.0 | PASS
HotMountBoltFrontFront | ASSEMBLY_PURCHASED_FASTENER | Solid | 1 | 1 | 942.478 | 10.0 | 10.0 | 36.0 | PASS
HotMountBoltFrontRear | ASSEMBLY_PURCHASED_FASTENER | Solid | 1 | 1 | 942.478 | 10.0 | 10.0 | 36.0 | PASS
HotMountBoltRearFront | ASSEMBLY_PURCHASED_FASTENER | Solid | 1 | 1 | 942.478 | 10.0 | 10.0 | 36.0 | PASS
HotMountBoltRearRear | ASSEMBLY_PURCHASED_FASTENER | Solid | 1 | 1 | 942.478 | 10.0 | 10.0 | 36.0 | PASS
KO_ChainMotion | REVIEW_ONLY | Solid | 1 | 1 | 190080.0 | 66.0 | 18.0 | 160.0 | PASS
KO_DancerSweep | REVIEW_ONLY | Solid | 1 | 1 | 498570.754 | 230.0 | 12.0 | 230.0 | PASS
KO_TraverseMotion | REVIEW_ONLY | Solid | 1 | 1 | 224400.0 | 170.0 | 55.0 | 24.0 | PASS
KO_ScrewService | REVIEW_ONLY | Solid | 1 | 1 | 3092250.0 | 310.0 | 95.0 | 105.0 | PASS
