kotori0919/PLA-PET-Recycling-Lab/exports/fusion_validation/load_case_manifest.csv

case_id | title | geometry | load_file | load_file_sha256 | source_git_sha | geometry_sha256
LC01 | rated shredder dynamic envelope | shredder_rotor_support.step | LC01.json | 6d60c770ef3db0afd5ded6040755e432e8ab22bd0bed6af58b42d2d5ccbdadb8 | 93db9533dcaf0655f9bde158d53e6f4df24ebb42 | 19c5f9261b5581cc7bc034eb0aa6de461d3667dce4e0b1238d9f28f5df315d0e
LC02 | mechanical fuse shaft jam | cutter_shaft.step | LC02.json | 9f223b92d42f6bce2c5ddad788866b29aa1a2260adfe84a4540d5d5a4714eaff | 93db9533dcaf0655f9bde158d53e6f4df24ebb42 | cda573938a4247710d3d3ea2adfce2ad632fa944f3739be349b7675e80472c05
LC03 | phase gear load reversal | shredder_rotor_support.step | LC03.json | b7d090371c7538358e3ba8fe04831a7c329cfa874a8ab5860f60a736563ff5ec | 93db9533dcaf0655f9bde158d53e6f4df24ebb42 | 19c5f9261b5581cc7bc034eb0aa6de461d3667dce4e0b1238d9f28f5df315d0e
LC04 | peak bearing reaction | bearing_plate.step | LC04.json | cd041288a930558a8289f91ec850e9645ec2e25465b1834a5df46ddcdde464d3 | 93db9533dcaf0655f9bde158d53e6f4df24ebb42 | d625b0e138c28c11b19d31e9402fd3fd12af2871ea3f81fb4d4ea5981ce09af6
LC05 | peak chain force and overhang | cutter_shaft.step | LC05.json | 689069c5c85529764d5caa8a28a7768b4e196869eb34d603f1ab9c21150bfb5d | 93db9533dcaf0655f9bde158d53e6f4df24ebb42 | cda573938a4247710d3d3ea2adfce2ad632fa944f3739be349b7675e80472c05
LC06 | blocked die pressure trip | extruder_hot_zone.step | LC06.json | 9d2cf82672f2fe2bbf112de4bb2ccd3de4f447147a6005ee3785a22db2f6b6b3 | 93db9533dcaf0655f9bde158d53e6f4df24ebb42 | 6e05a8ca6c67985559775e639c646de9655fd423fdc09cd0c683b19b65ea6200
LC07 | PLA thermal steady/transient | extruder_hot_zone.step | LC07.json | 71d974fb1e17bb6452d7ea425509314015a74f7676363b7c96355fa48cc518c1 | 93db9533dcaf0655f9bde158d53e6f4df24ebb42 | 6e05a8ca6c67985559775e639c646de9655fd423fdc09cd0c683b19b65ea6200
LC08 | PET thermal steady/transient | extruder_hot_zone.step | LC08.json | 986a7ebc29c7739f844e5cbeea8a9ffec2b474f934d268da6516194152be5847 | 93db9533dcaf0655f9bde158d53e6f4df24ebb42 | 6e05a8ca6c67985559775e639c646de9655fd423fdc09cd0c683b19b65ea6200
LC09 | full spool plus line tension | spooler_support.step | LC09.json | b46d3ac9858d9d73e8a76f3569b28452189598a6ebbe0921e3a647957051d572 | 93db9533dcaf0655f9bde158d53e6f4df24ebb42 | 622072a82516511381c6ea32165a3eee4b77950a02bc120460161d8f4d6b3bae
LC10 | global frame reaction/modal/buckling | frame.step | LC10.json | 12ca1c9855ecbb8c1bdc3cffd91bd61537c14d337401f25f45e3b244a5d6850d | 93db9533dcaf0655f9bde158d53e6f4df24ebb42 | 625db72ebbd4b5610ee7e203297b3917f2335e74452dbdc9e4363506c5c9084d
