kotori0919/PLA-PET-Recycling-Lab/exports/fusion_validation/model_manifest.csv

file | role | units | source_git_sha | source_tree_sha256 | step_sha256 | bbox_x_mm | bbox_y_mm | bbox_z_mm | volume_mm3 | authority
frame.step | global metal load path and table interface | mm | 93db9533dcaf0655f9bde158d53e6f4df24ebb42 | 35fa577888bbb191e628343092acd2b958fc2bce79ba0f791bbecde2012fd576 | 625db72ebbd4b5610ee7e203297b3917f2335e74452dbdc9e4363506c5c9084d | 470.000000 | 700.000000 | 930.000000 | 6375200.000000 | FreeCAD Python controlling geometry
shredder_frame.step | shredder fixed support and motor plate | mm | 93db9533dcaf0655f9bde158d53e6f4df24ebb42 | 35fa577888bbb191e628343092acd2b958fc2bce79ba0f791bbecde2012fd576 | 43886ebd7832162f3c1eaf99906b9b5bc9288db3e6a0f9545fbe99b3c2a64544 | 190.000000 | 226.000000 | 195.000000 | 525763.761522 | FreeCAD Python controlling geometry
shredder_rotor_support.step | two-shaft bearing support assembly | mm | 93db9533dcaf0655f9bde158d53e6f4df24ebb42 | 35fa577888bbb191e628343092acd2b958fc2bce79ba0f791bbecde2012fd576 | 19c5f9261b5581cc7bc034eb0aa6de461d3667dce4e0b1238d9f28f5df315d0e | 150.000000 | 260.000000 | 125.000000 | 661879.558686 | FreeCAD Python controlling geometry
cutter_shaft.step | decision-critical shaft | mm | 93db9533dcaf0655f9bde158d53e6f4df24ebb42 | 35fa577888bbb191e628343092acd2b958fc2bce79ba0f791bbecde2012fd576 | cda573938a4247710d3d3ea2adfce2ad632fa944f3739be349b7675e80472c05 | 25.000000 | 240.000000 | 25.000000 | 113609.438928 | FreeCAD Python controlling geometry
bearing_plate.step | decision-critical bearing plate | mm | 93db9533dcaf0655f9bde158d53e6f4df24ebb42 | 35fa577888bbb191e628343092acd2b958fc2bce79ba0f791bbecde2012fd576 | d625b0e138c28c11b19d31e9402fd3fd12af2871ea3f81fb4d4ea5981ce09af6 | 150.000000 | 125.000000 | 12.000000 | 188962.099520 | FreeCAD Python controlling geometry
extruder_hot_zone.step | barrel/heater/die thermal assembly | mm | 93db9533dcaf0655f9bde158d53e6f4df24ebb42 | 35fa577888bbb191e628343092acd2b958fc2bce79ba0f791bbecde2012fd576 | 6e05a8ca6c67985559775e639c646de9655fd423fdc09cd0c683b19b65ea6200 | 320.500000 | 44.000000 | 60.500000 | 302388.000308 | FreeCAD Python controlling geometry
die.step | pressure relief and die interfaces | mm | 93db9533dcaf0655f9bde158d53e6f4df24ebb42 | 35fa577888bbb191e628343092acd2b958fc2bce79ba0f791bbecde2012fd576 | bf737b144f8b981b279ca856e565079ad984dcfe62b38ff16d6df5f2ce8ae5aa | 40.500000 | 40.000000 | 49.500000 | 71343.859182 | FreeCAD Python controlling geometry
thermocouple_bore_coupon.step | matched material/process coupon envelope | mm | 93db9533dcaf0655f9bde158d53e6f4df24ebb42 | 35fa577888bbb191e628343092acd2b958fc2bce79ba0f791bbecde2012fd576 | 92ec9372a1e842f94d43b77a7c6043384729c86402a2676d14cffca198fc517b | 34.000000 | 34.000000 | 60.000000 | 42108.022973 | FreeCAD Python controlling geometry
spooler_support.step | metal spindle/dancer/traverse support | mm | 93db9533dcaf0655f9bde158d53e6f4df24ebb42 | 35fa577888bbb191e628343092acd2b958fc2bce79ba0f791bbecde2012fd576 | 622072a82516511381c6ea32165a3eee4b77950a02bc120460161d8f4d6b3bae | 240.000000 | 184.000000 | 280.000000 | 262139.985991 | FreeCAD Python controlling geometry
