kotori0919/PLA-PET-Recycling-Lab/simulation/openmodelica/results/scenario_metrics.csv

average_power_w | classification | control_margin_m_s | controlled_stop_seen | cooldown_max_temperature_c | cooldown_seen | cooling_feedback_min_a | cooling_residence_s | diameter_error_mm | drive_tripped | fault_detected | fault_reason | feeder_enabled | final_material_session | final_net_flow_gph | final_normal_flow_gph | final_process_state | final_screw_rpm | final_state | forming_chain_state_final | fuse_blown | fuse_broken | fuse_power_cut_verified | hard_stop_engaged | inertia_kg_m2 | jam_detected | jam_fault | late_max_zone_temperature_range_c | line_velocity_m_s | mass_flow_gph | max_settled_diameter_error_mm | max_temperature_c | maximum_absolute_diameter_error_mm | min_duty | minimum_reserve_w | normal_after_confirm_s | out_of_tolerance_duration_s | overlap_blocked | overshoot_percent | peak_bearing_load_n | peak_bus_power_w | peak_chain_force_n | peak_coolingPower_w | peak_cutter_rpm | peak_cutter_torque_nm | peak_dancer_angle_rad | peak_driverLossPower_w | peak_electronicsPower_w | peak_feederPower_w | peak_hard_stop_reaction_nm | peak_heaterPower_w | peak_length_imbalance_m | peak_line_tension_n | peak_motor_current_a | peak_motor_torque_nm | peak_net_flow_gph |
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
