kotori0919/PLA-PET-Recycling-Lab/electronics/pcb/interface_board/analysis/spice_work/decoupling_C1.cir

* Auto-generated testbench for decoupling analysis: +5V rail
* 1 capacitor(s) in parallel, series R-L-C model
* Model: ESR/ESL from pdn_impedance (package-based)

R_esr_C1 rail n_esr_0 1.581
L_par_C1 n_esr_0 n_lpar_0 7.5n
C1 n_lpar_0 0 100n

* 1A AC current source into the rail node — V(rail) = Z(f)
IAC 0 rail DC 0 AC 1

.control
ac dec 200 100 100Meg
let z_mag = vm(rail)
meas ac z_min min z_mag
meas ac f_at_zmin when z_mag=z_min
meas ac z_at_1M find vm(rail) at=1Meg
meas ac z_at_100k find vm(rail) at=100k
echo "z_min=$&z_min f_at_zmin=$&f_at_zmin z_at_1M=$&z_at_1M z_at_100k=$&z_at_100k n_caps=1" > electronics/pcb/interface_board/analysis/spice_work/decoupling_C1.out
quit
.endc

.end
