kotori0919/PLA-PET-Recycling-Lab/(commit log)

2026-10-19 build(cad): rebind frame cut list to compact GGM layout (470x700x930)
    Adopt the compact GGM layout as the v0.8 fabrication baseline and
    regenerate the hash-bound frame evidence (audit_geometry, beam_screen,
    build_frame_release) so frame_release.py and compliance item 07 pass
    again. Cut quantities are unchanged (2020 x36 / 15078 mm, 2040 x4 /
    2180 mm). Correct stale Y729 envelope statements to the nominal CAD
    value and add the verification plan (docs/final/hardware_verification_plan_ko.md).
    Verified on a clean HEAD export overlaid with only these paths:
    frame_release PASS, v08_full_compliance 23/25 (20 release package and
    21 release policy pending). Physical validation remains NOT_RUN; no
    pu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
    [FR-TIE-01.FCStd, FR-TIE-01.dxf, FR-TIE-01.step, GGM-DRIVE-ASM.FCStd, GGM-DRIVE-ASM.step, GGM-FULL-ASM.FCStd, GGM-FULL-ASM.step, GGM_ChainGuard.FCStd]
2026-10-19 build(evidence): rebind clearance, motion and hot-zone reviews to compact assembly
    Regenerate integrated_clearance, integrated_motion (both PASS on the
    compact model) and hot_zone_revision_review. The thermal screen differs
    from the previous file only at ~1e-13 relative (float noise), so the
    physics is unchanged; the source hashes now match assembly.py.
    Physical validation remains NOT_RUN.
2026-10-19 fix(release): point remote_release_state at the current PR URL
    GitHub now serves PR #4 under kotori0919; the recorded snowman0919 URL
    made compliance 21_release_policy fail although origin HEAD and the open
    main-target PR were verified.
2026-10-19 feat(design): commit remaining compact-layout v0.8 design, BOM and review set
    Commit the rest of the adopted compact-layout work so the committed tree
    is a single coherent fabrication baseline: BOM and budget revisions
    (custom Tempco die heater quote, 4-channel heater MOSFET, total 176076
    KRW), exports/print and fusion validation refresh, FD-TRN-01 removal,
    compact-layout analysis and tests, review records and supplier notes.
    Large scratch solver output (phase_gear_raw, keyed-torsion, retainer,
    sensor-bore work dirs) and the skill archive are intentionally excluded.
    Physical validation remains NOT_RUN; no purchase, fabrication or
    energizing is authorized by this commit.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
    [CUT-05.FCStd, CUT-05.dxf, CUT-05.step, CUT-05R.FCStd, CUT-05R.dxf, CUT-05R.step, DRV-03-L-CANDIDATE.step, DRV-03-L-MATCHED-CANDIDATE.step]
2026-10-19 fix(ci): make compact-layout tests runnable in their suites
    run_calculix_v08 imports its sibling beam_torque_recovery, which failed
    when loaded as a module by test_compact_shelf_mesh; add its own directory
    to sys.path. test_fixed_foot_compact_layout needs FreeCAD, so register it
    in the CAD suite instead of the light suite.
    [ci_v08.py]
2026-10-19 fix(ci): resolve beam_torque_recovery in the shelf mesh test, keep solver source hash
    The previous fix edited run_calculix_v08.py, whose hash is bound by the
    solver evidence (summary.json and others), and broke the 03/05 source
    currency gates. Restore that file byte-for-byte and add the sibling
    analysis directory to the test's sys.path instead.
    [test_compact_shelf_mesh.py]
2026-10-19 docs(final): add prototype fabrication and physical validation readiness report
    Detailed report built on the hardware-verification-plan skill: compliance
    25/25, inventory 13/13, P0 23/23, execution record, P1 start procedure,
    staged purchase/fabrication sequence with approval points, cost status,
    failure handling, safety boundaries and user decision checklist.
    Physical validation remains NOT_RUN; nothing here authorizes purchase,
    fabrication or energizing.
2026-10-19 feat(validation): gate extrusion diameter consistency and add precision error budget
    The P10/P11 and P12 analyzers checked the window mean error, ovality and
    per-sample measurement U95, but never the sample-to-sample spread, so a
    window alternating 1.72/1.78 mm passed. Require every sample within
    1.75 +/- 0.05 mm, sample standard deviation <= 0.015 mm and reference
    gauge U95 <= 0.01 mm (proposed limits derived from the 0.03 mm U95
    budget). Update the gate contract, P10-P12 docs, P12 template and tests.
    Add a mass-conservation error budget (analysis/extrusion_precision_v08)
    and docs/final/extrusion_precision_plan_ko.md with derived requirements
    XP-01..XP-06. The budget is a screening estimat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
    [p12_forming_spool.csv]
2026-10-19 docs(review): record 108_stls mechanical traverse analysis for the spooler
    Inspect the three external STL parts (crank, pin-slider frame, grooved
    drum), record what is observed versus inferred, map the idea onto the
    existing electronic traverse (1.85 mm pitch, 68 mm stroke) and define the
    adoption path. The STL archive itself is not committed (unknown source
    and licence). No design file is changed.
